Antho32170/ETD2/IMGS/sesame-fonctionnel.png

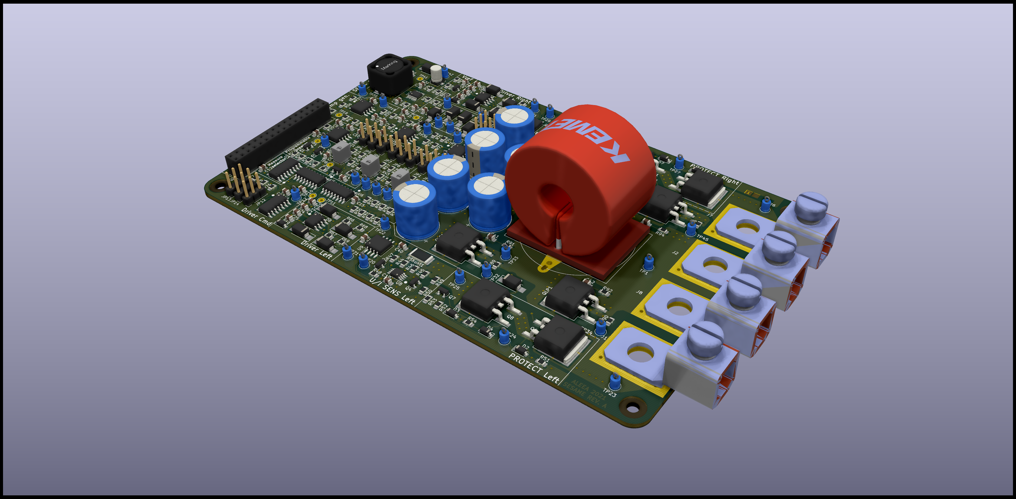
IMGS/sesame-fonctionnel.png
