Antho32170/ETD2/IMGS/sesame-dual_LT6105_equiped_render.png

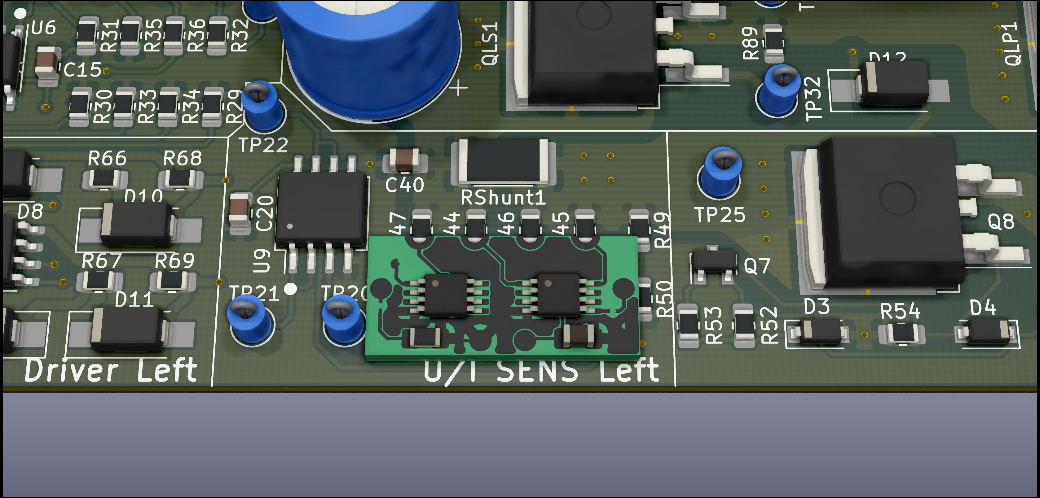
IMGS/sesame-dual_LT6105_equiped_render.png
