Antho32170/ETD2/README.md

# SESAME
Projet ETD18 BALMA

The SESAME project is a DC-DC converter which can be pluged from either side.
