Antho32170/ETD2/IMGS/Current_Res_Breaker.png

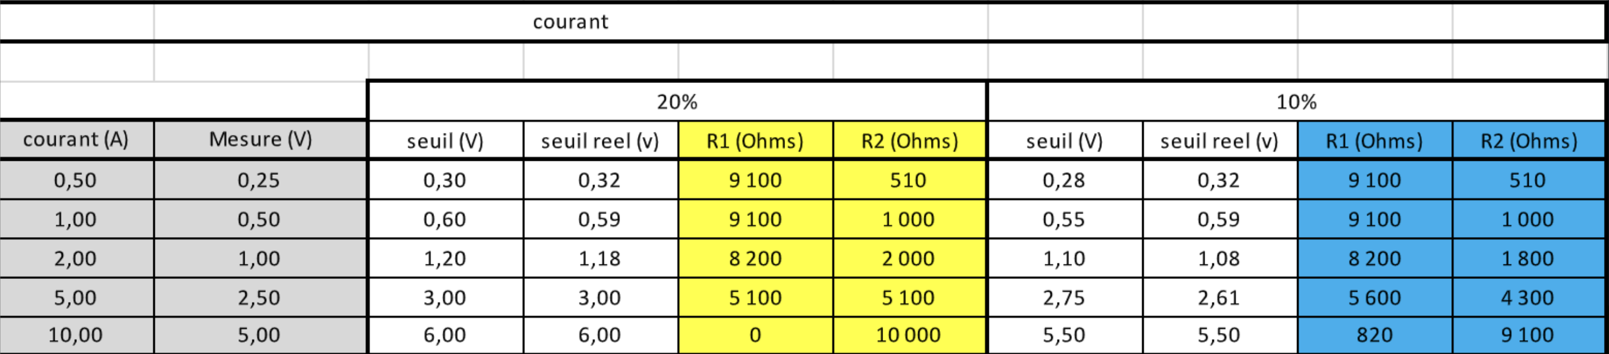
IMGS/Current_Res_Breaker.png
