Antho32170/ETD2/IMGS/lt6105_typ.png

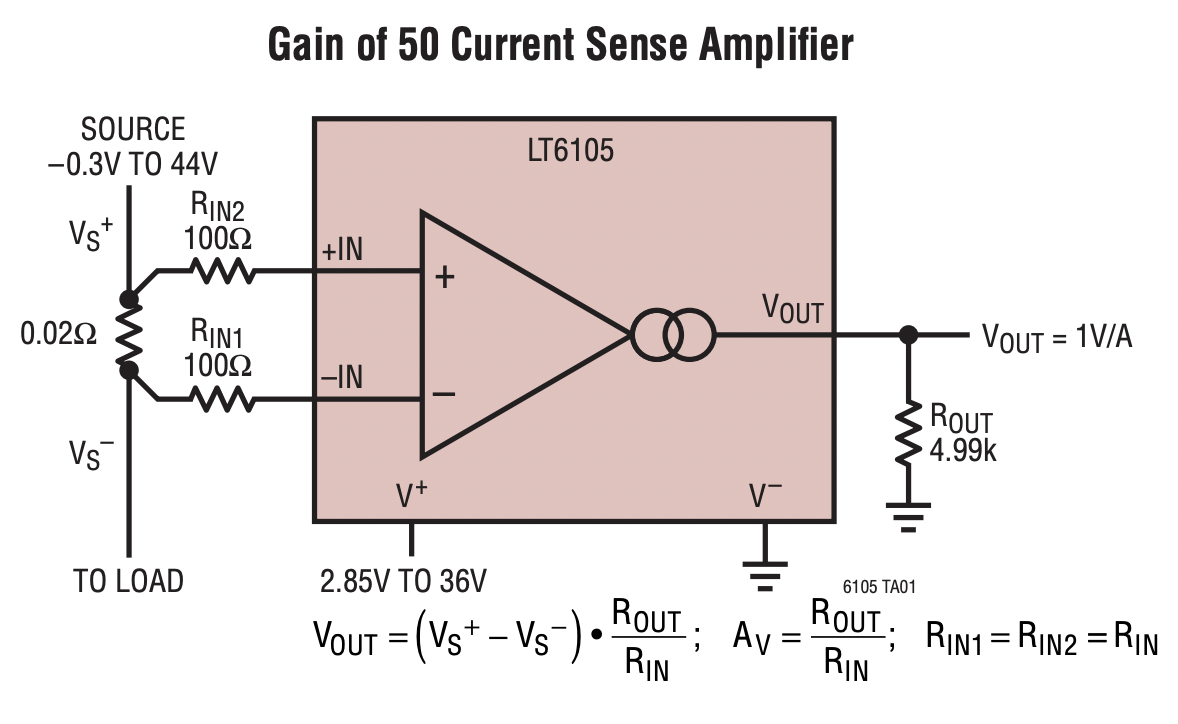
IMGS/lt6105_typ.png
