Antho32170/ETD2/IMGS/sesame-fonctionnel-no-rt.png

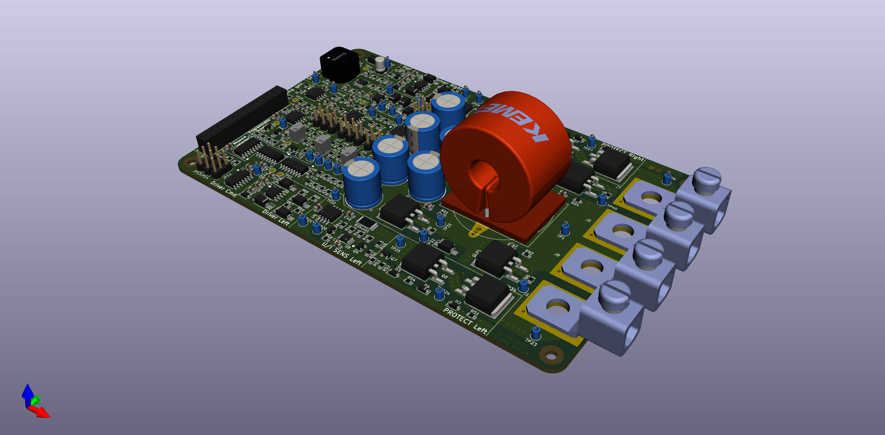
IMGS/sesame-fonctionnel-no-rt.png
