Antho32170/ETD2/IMGS/Voltage_Res_Breaker.png

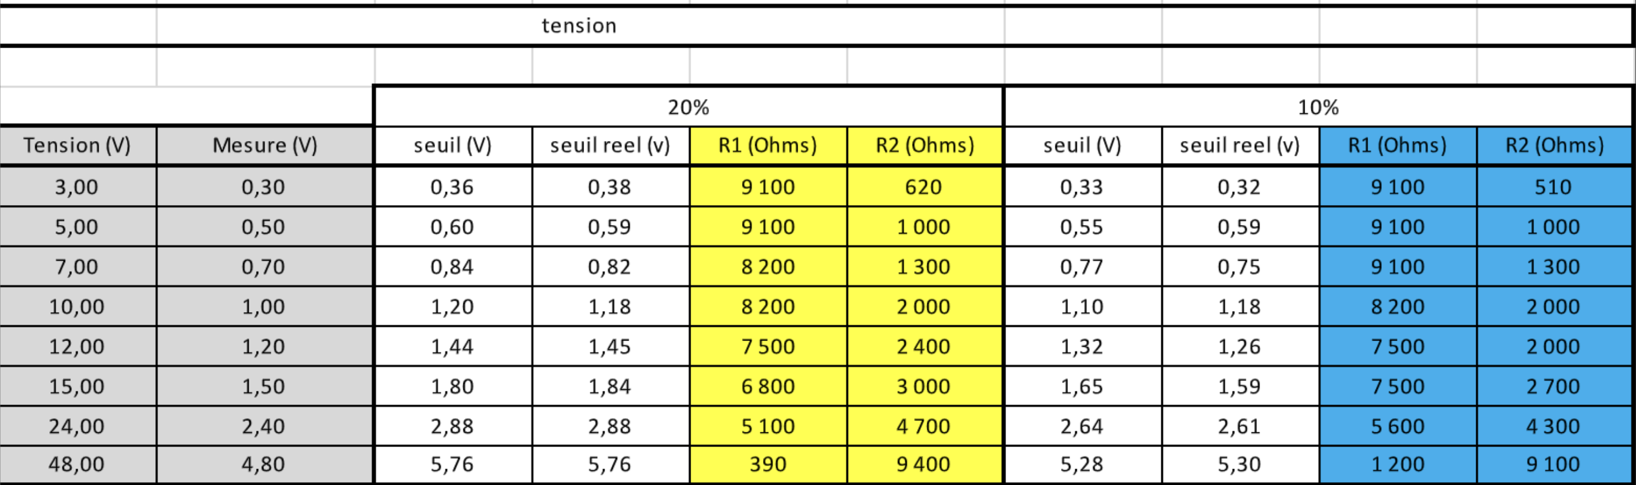
IMGS/Voltage_Res_Breaker.png
