Antho32170/ETD2/KICAD/dual_LT6105/dual_LT6105-rt.png

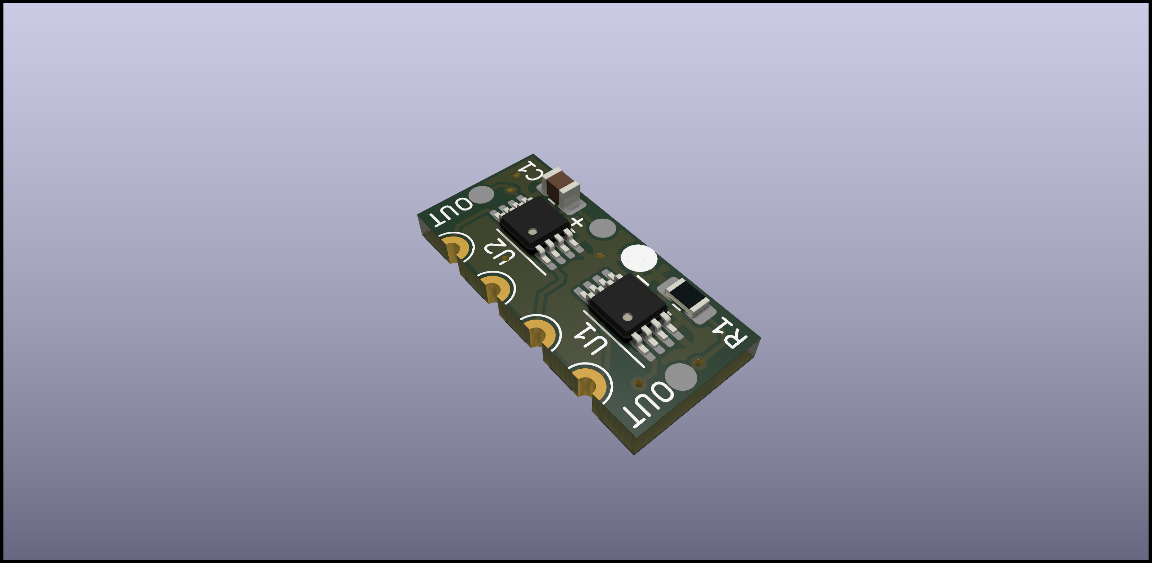
KICAD/dual_LT6105/dual_LT6105-rt.png
