Antho32170/ETD2/montage composants ordre.xlsx

Couleur | Ref | Valeur | Observation
 | R44 R45 R46 R47 R59 R60 R61 R62 R83 | 200Ω
 | mod1 mod2 | x | (suivre la procedure)
 | R68 R69 R87 R88 | 1Ω
 | R66 R67 R85 R86 | 4.7Ω
 | R9 | 390Ω
 | R43 | 680Ω
 | R71 | 4.7kΩ
 | R39 | 6.8kΩ
 | R7 R26 R29 R31 R32 R35 R36 R37 R40 R50 R65 R76 R77 R78 R84 R97 R98 | 10kΩ | En bobine
 | R38 | 11kΩ
Couleur | Ref | Valeur | Observation
 | R41 | 13kΩ
 | R28 | 14kΩ
 | R42 | 18kΩ
 | R8 mod1_R1 mod2_R1 | 20kΩ
 | R3 R5 R22 R23 R24 R25 R27 | 47kΩ
 | R49 R64 | 91kΩ
 | R14 R15 R16 R17 R18 R19 R20 R21 R52 R53 R56 R57 R70 R72 R73 R74 R75 | 100kΩ
 | R51 R55 | 330kΩ
 | R54 R58 | 1MΩ
 | RShunt1 RShunt2 | 5mΩ
Couleur | Ref | Valeur | Observation
 | C18 | 2.2nF
 | C8 C10 C11 | 10nF
 | C4 | 22nF
 | C1 C6 C12 C13 C15 C16 C17 C20 C22 C23 C24 C26 C27 C33 C34 mod1_C1 mod2_C1 | 100nF
 | C5 | 220nF
 | C3 C7 C9 C14 | 470nF
 | C50 C51 | 1µF
 | D1 | BZX384B5V1 | 5V1
 | D2 D4 D5 D7 D19 D22 | MMSZ5245 | 15V
 | D3 D6 | MMSZ51T1G | 51V
Couleur | Ref | Valeur | Observation
 | D10 D11 D17 D18 D20 D23 | SK16
 | Q1 Q2 Q3 | BC847 | NPN
 | Q7 Q10 | BC857 | PNP
 | U16 | TL431DBZ
 | U12 U17 | UCC27284-Q1
 | U13 | TS3702
 | U1 U7 U9 U11 | OPA2172
 | U2 | LM2903
 | U4 | CD4011
 | U3 U5 U6 | CD4053
 | mod1_U1 mod1_U2 mod2_U1 mod2_U2 | LT6105
Couleur | Ref | Valeur | Observation
 | QLS1 QLP1 QRP1 QRS1 | IRF3710SPBF | CHANNEL N
 | Q6 Q8 Q9 Q11 | TJ60S04 | CHANNEL P
 | C32 | 10µF | 60V
 | RV1 RV2 RV3 | 10KΩ
 | JP1 JP2 JP3 JP4 JP5 JP6 JP7 JP8 JP9 | 1X2
 | JP10 JP11 JP12 JP13 JP14 | 1X3
 | J9 | 2X16
 | C36 C47 | 470µF
 | L2 | GROSSE BOB
 | TP1 TP2 TP4 TP7 TP9 TP12 TP13 TP14 TP15 TP16 TP17 TP19 TP21 TP22 TP23 TP24 TP25 TP26 TP27 TP28 TP30 TP31 TP32 TP33 TP34 TP36 TP37 TP38 TP42 TP43 TP44 TP45 TP46 TP47 TP48 TP49 | Test point
