Antho32170/ETD2/FREECAD/dual_LT61051.FCStd

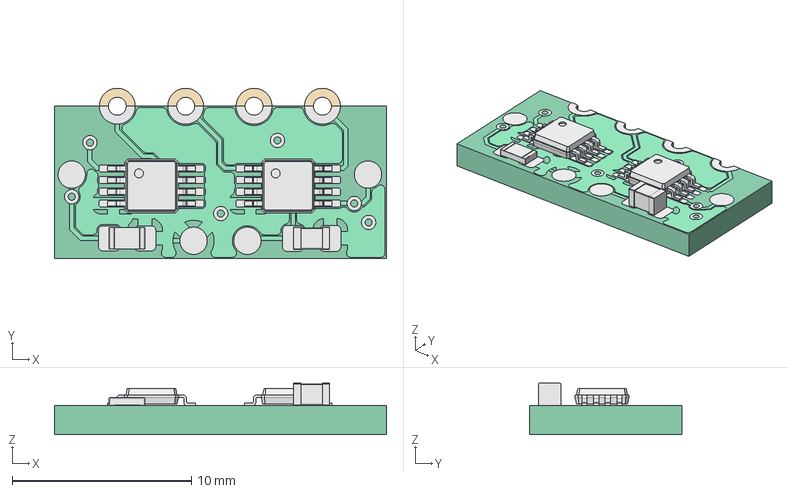
[picture p13: CAD file, 2021-11-26]
FREECAD/dual_LT61051.FCStd
18.5 x 9.50 x 2.87 mm
Pcb_2a2f
topPads_2a2f
topTracks_2a2f
topZones_2a2f
botPads_2a2f
botTracks_2a2f
botZones_2a2f
U1_MSOP_8_3x3mm_P065mm_f12392cb5f74 x 2
C1_C_0805_2012Metric_c8931768d43d
R1_R_0805_2012Metric_d0d7686d96ad
