Antho32170/ETD2/KICAD/dual_LT6105/dual_LT6105.step

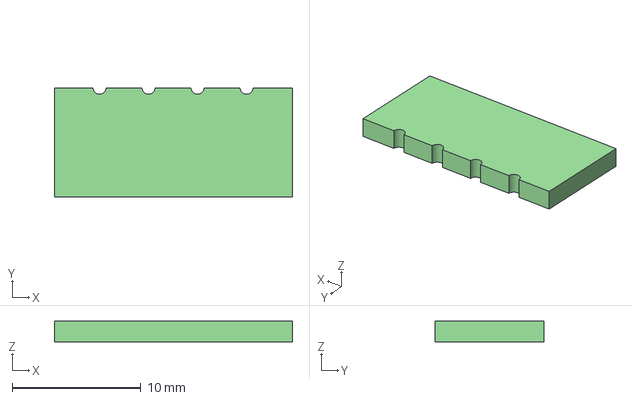
[picture p14: CAD file, 2021-11-26]
KICAD/dual_LT6105/dual_LT6105.step
18.5 x 8.50 x 1.60 mm
