Antho32170/ETD2/KICAD/STEP/SOIC-16.STEP

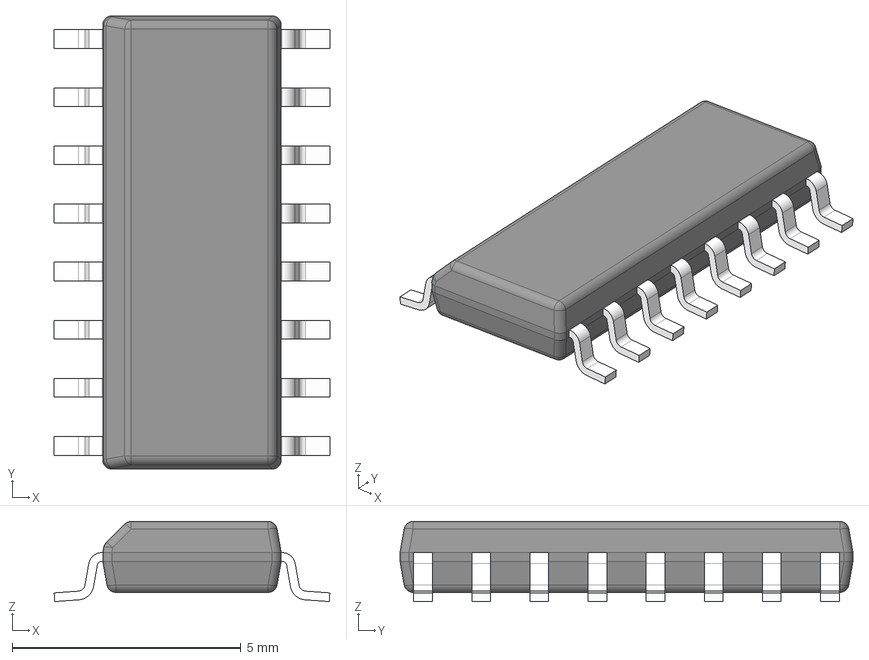
[picture p15: CAD file, 2021-08-27]
KICAD/STEP/SOIC-16.STEP
6.03 x 9.90 x 1.75 mm
BODY-SO
LEAD-SO x 16
PIN1-ID
