Antho32170/ETD2/KICAD/STEP/3214W.stp

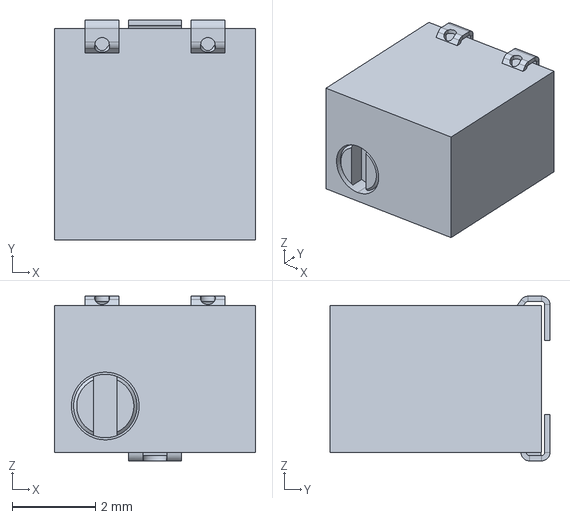
[picture p16: CAD file, 2021-08-26]
KICAD/STEP/3214W.stp
4.83 x 5.28 x 3.96 mm
