Antho32170/ETD2/KICAD/STEP/SN14P-300J.step

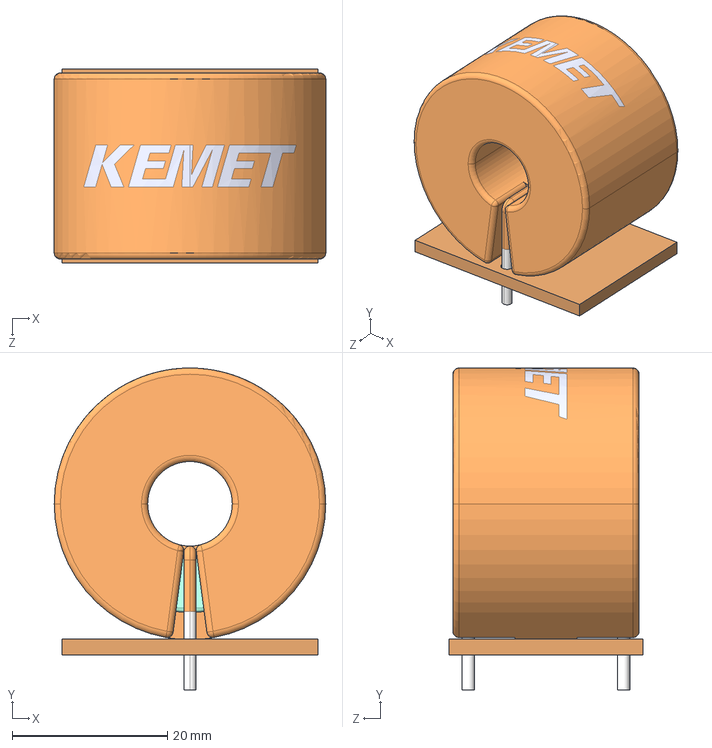
[picture p17: CAD file, 2021-08-25]
KICAD/STEP/SN14P-300J.step
35.0 x 41.5 x 25.0 mm
