Antho32170/ETD2/KICAD/STEP/keystone-PN6095.STEP

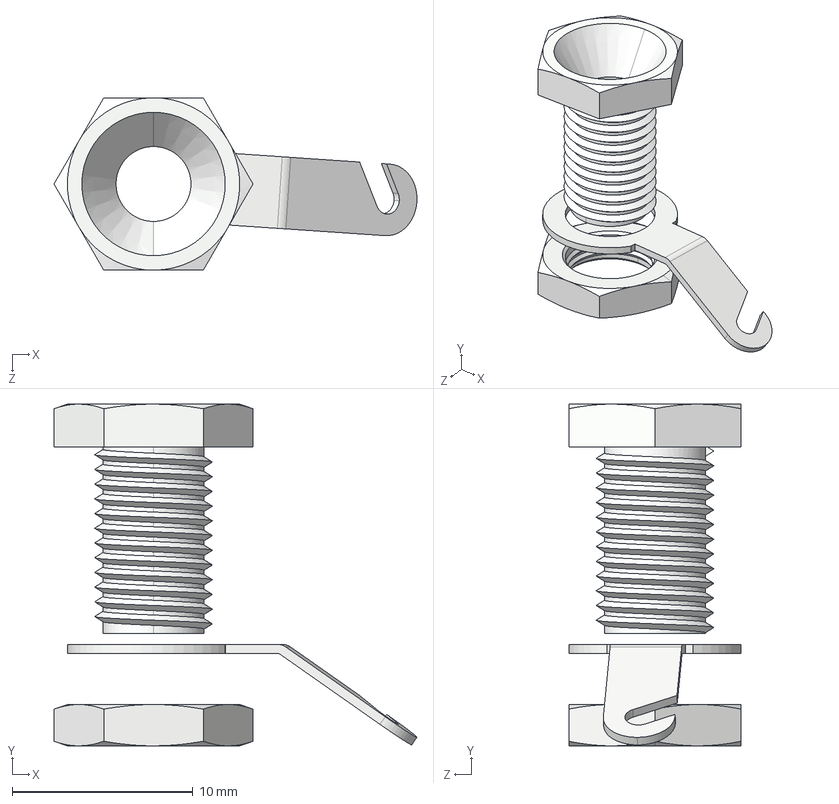
[picture p18: CAD file, 2021-08-22]
KICAD/STEP/keystone-PN6095.STEP
20.1 x 18.9 x 9.53 mm
