Antho32170/ETD2/KICAD/STEP/CXS70-14-C.STEP

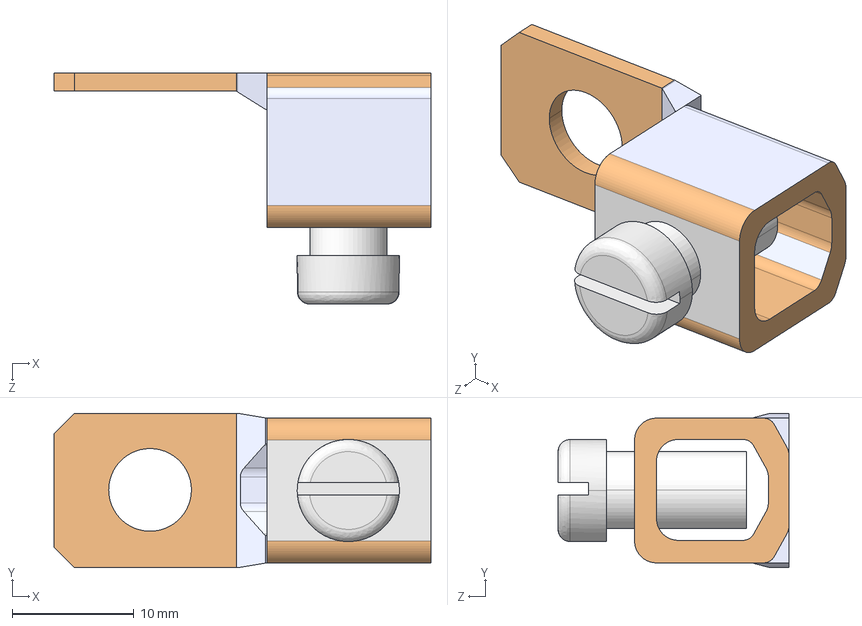
[picture p19: CAD file, 2021-08-22]
KICAD/STEP/CXS70-14-C.STEP
31.0 x 12.7 x 19.0 mm
