Antho32170/ETD2/KICAD/STEP/744873001_Download_STP_WE-DD-1280_rev1.stp

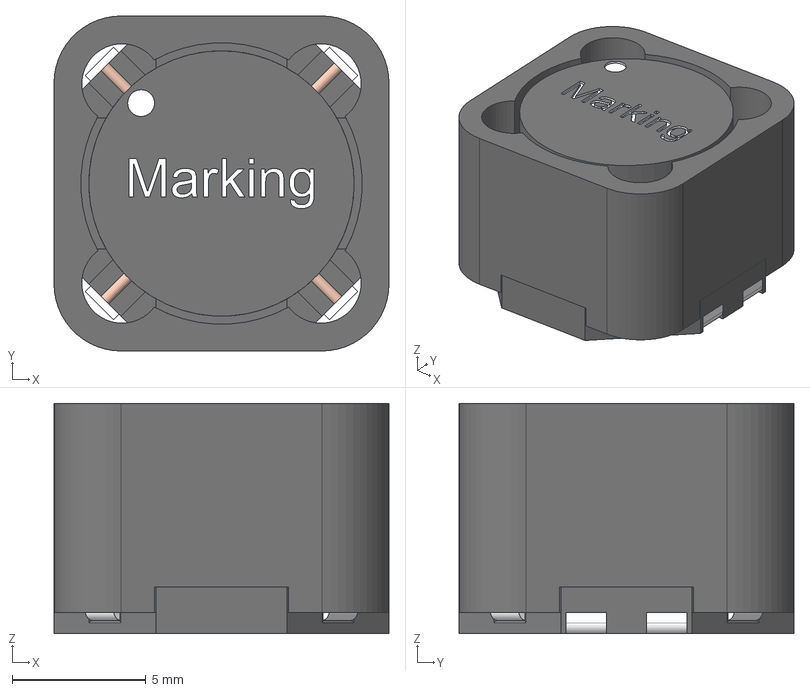
[picture p20: CAD file, 2021-08-25]
KICAD/STEP/744873001_Download_STP_WE-DD-1280_rev1.stp
12.5 x 12.5 x 8.60 mm
Kern x 4
Deckel
Pin x 2
Pin_2 x 2
