Antho32170/ETD2/(list of files, cad)

Other CAD files:
KICAD/STEP/dual_LT6105.step
