Antho32170/ETD2/DOCS/sesame-fonctionnel-1.0.pdf

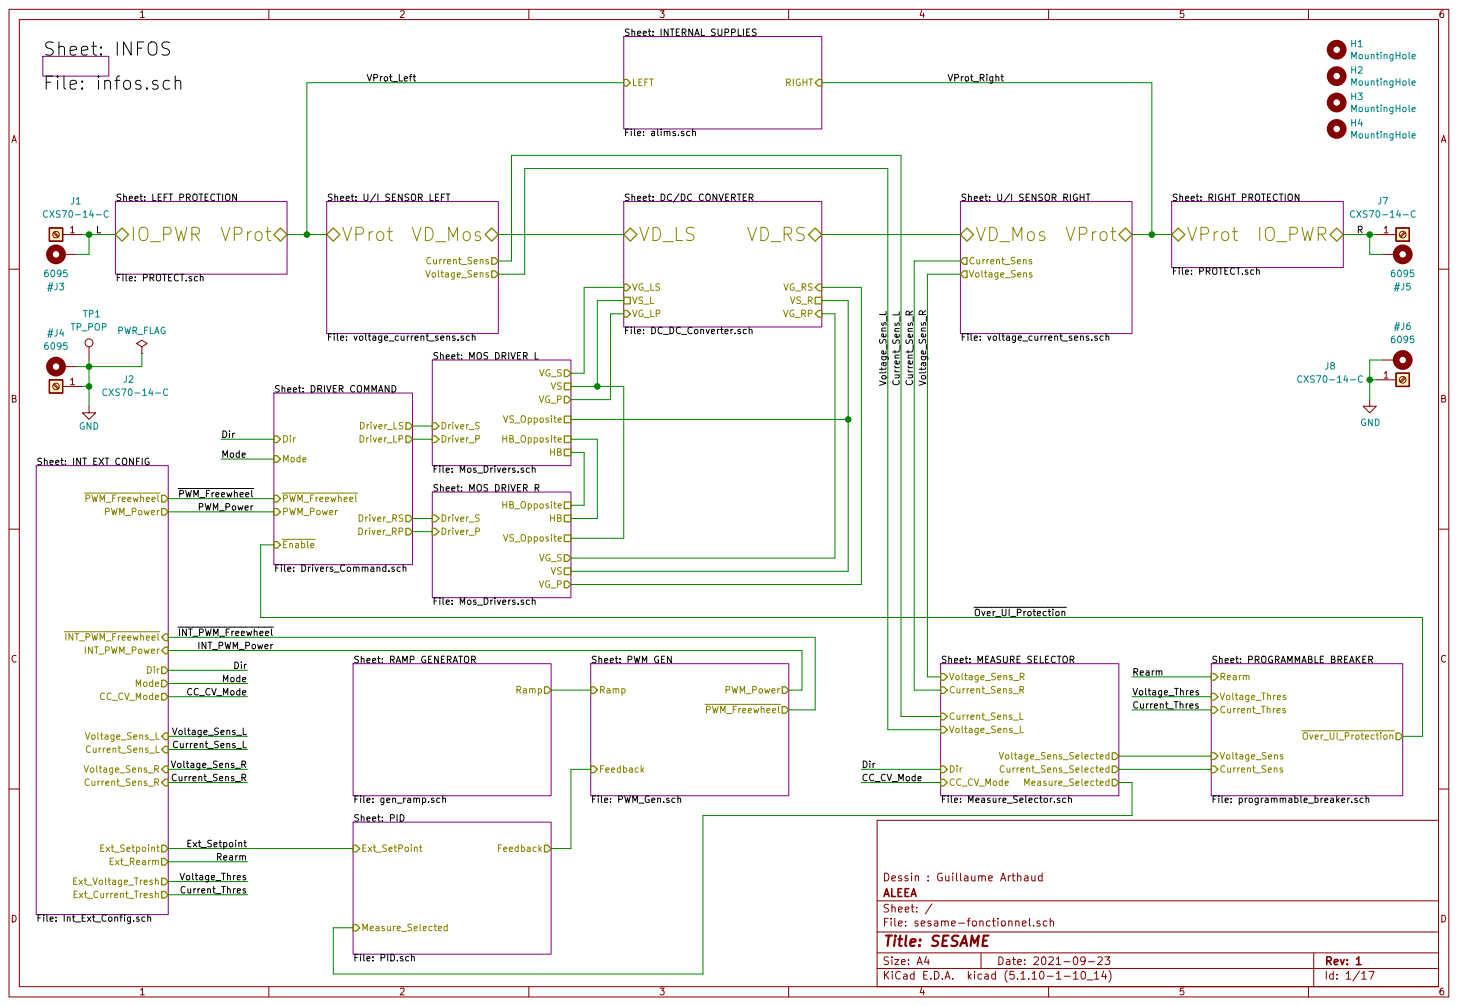
[picture p21: page 1]

VD_Mos VProt Current_Sens Voltage_Sens Sheet: DC/DC CONVERTER

File: PROTECT.sch VProt IO_PWR

Dessin : Guillaume Arthaud Sheet: INT EXT CONFIG

File: sesame-fonctionnel.sch Sheet: / ALEEA

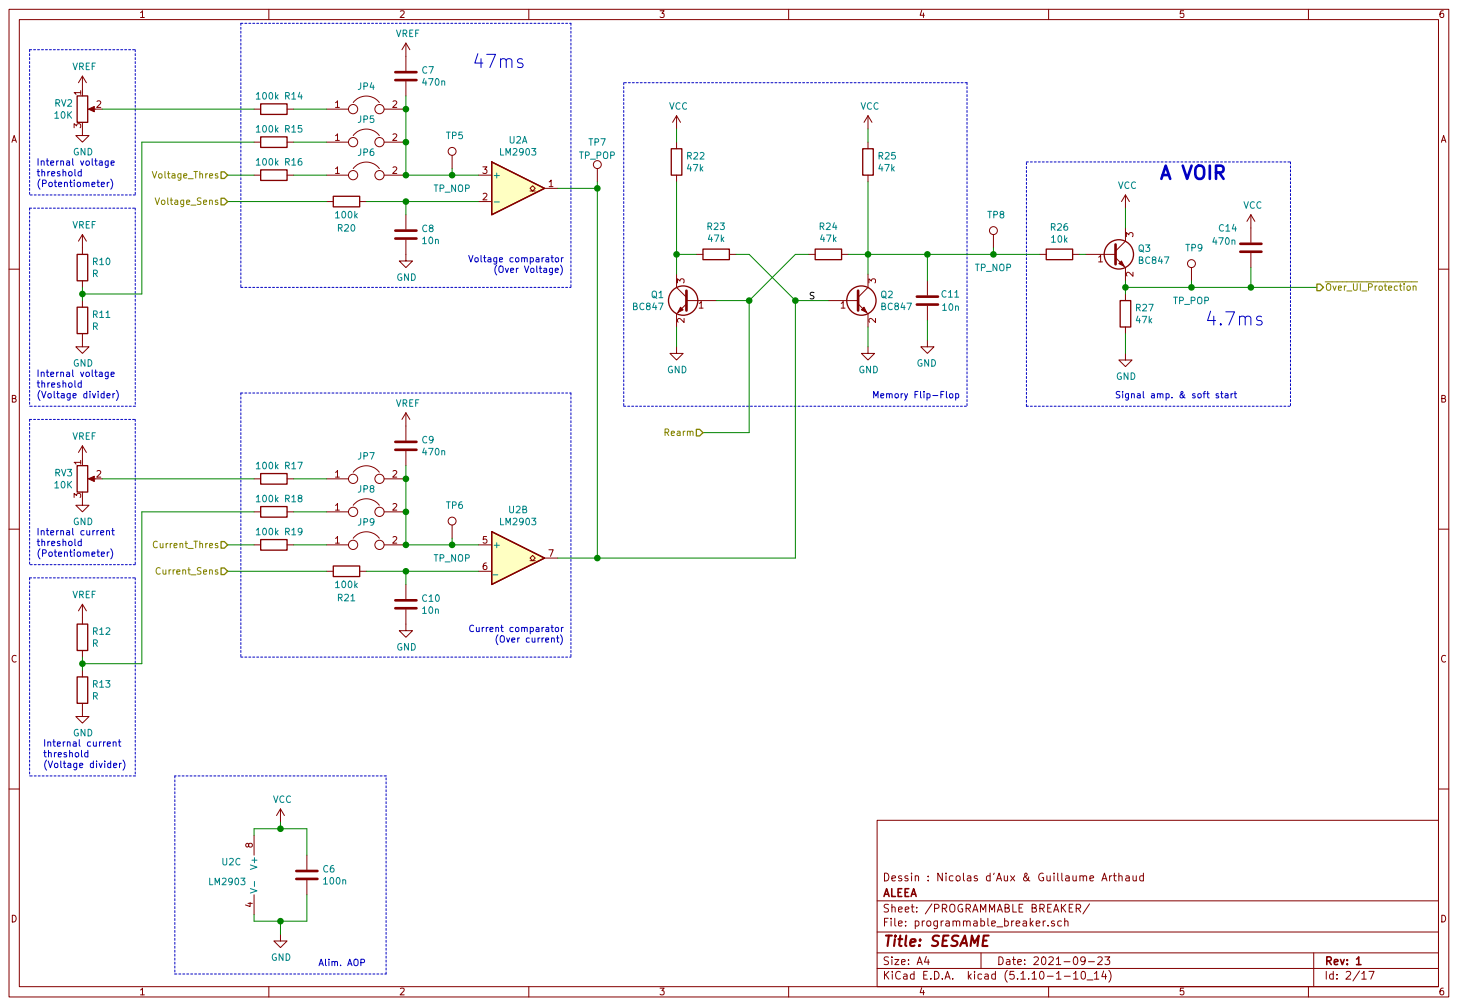
[picture p22: page 2]

A VOIR

10n GND | - 2 + 1 Voltage comparator (Over Voltage)

Signal amp. & soft start

Dessin : Nicolas d'Aux & Guillaume Arthaud
File: programmable_breaker.sch Sheet: /PROGRAMMABLE BREAKER/ ALEEA

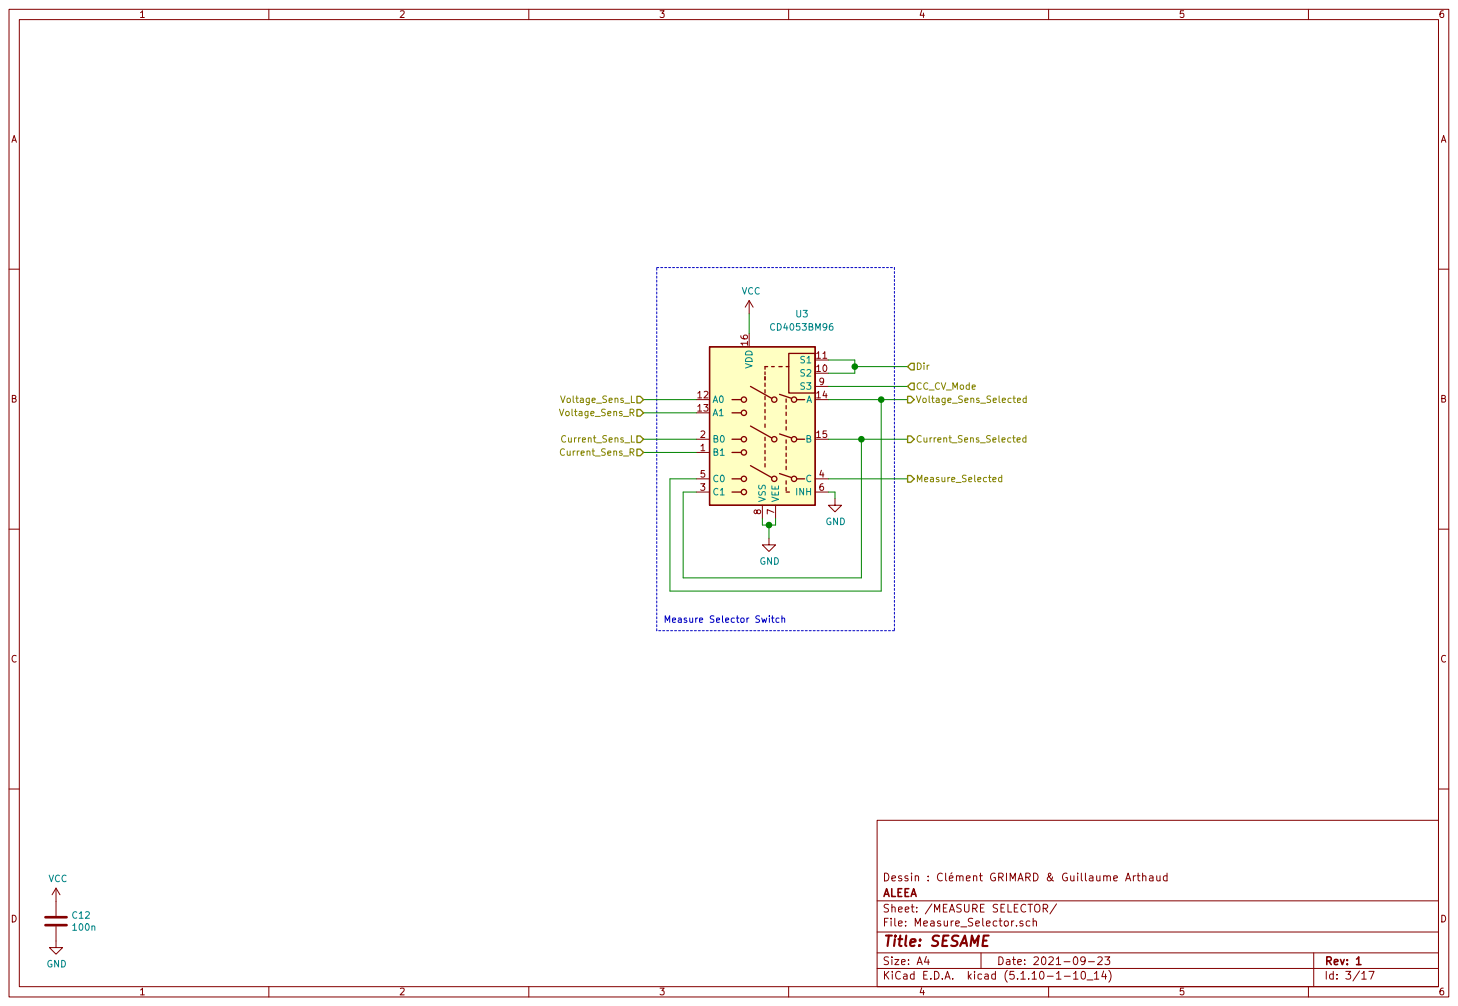
[picture p23: page 3]

Dessin : Clément GRIMARD & Guillaume Arthaud
File: Measure_Selector.sch Sheet: /MEASURE SELECTOR/ ALEEA

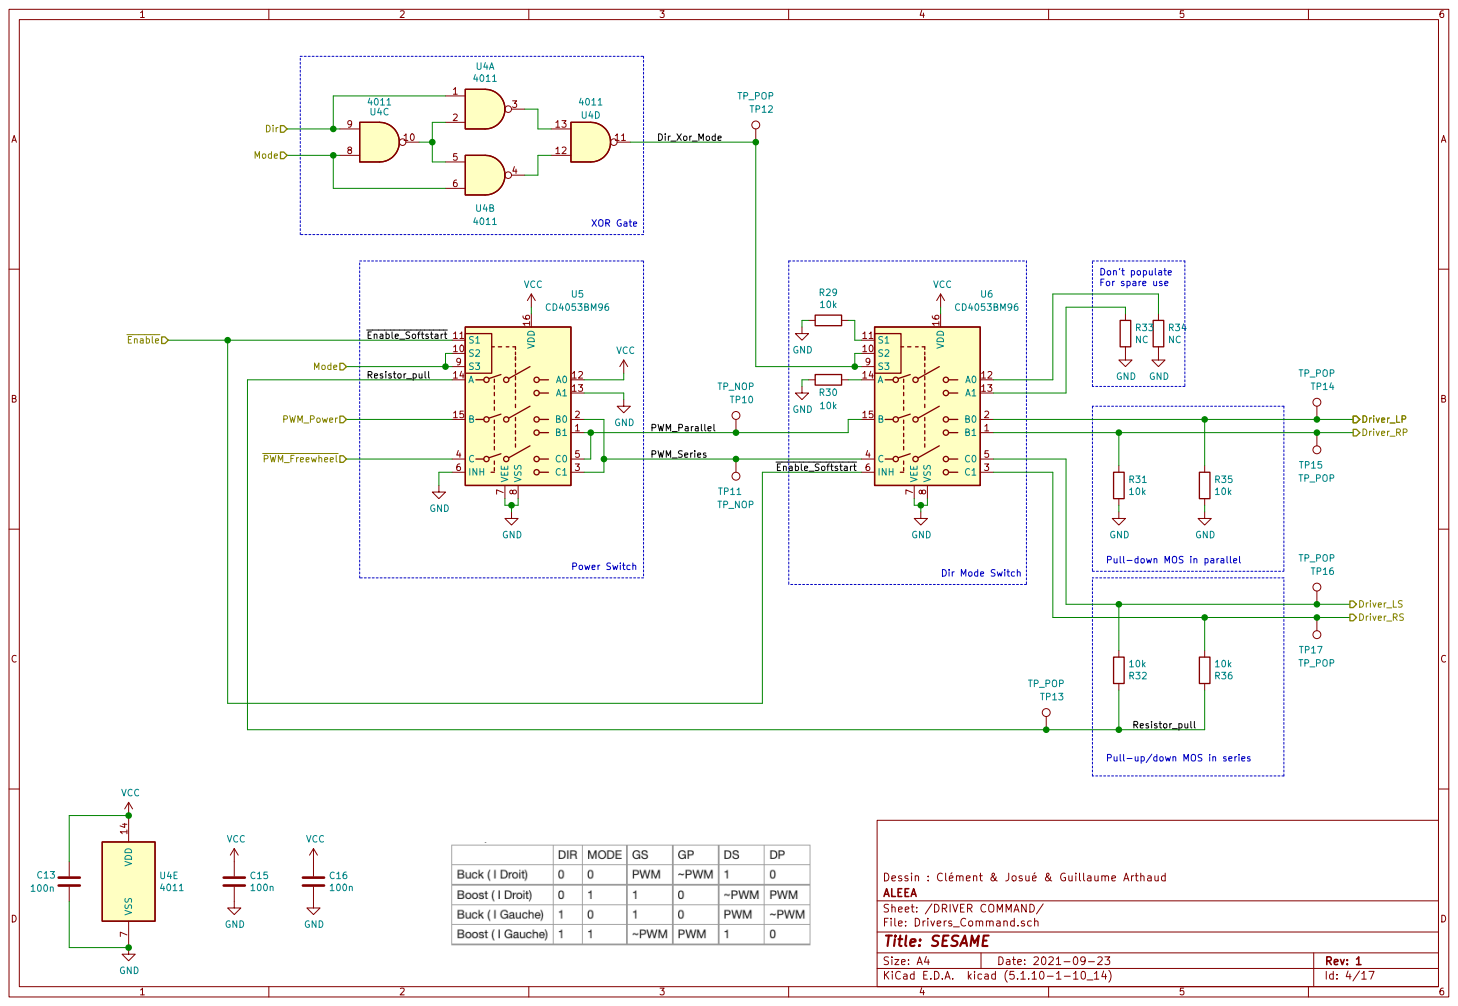
[picture p24: page 4]

Pull-up/down MOS in series

Dessin : Clément & Josué & Guillaume Arthaud
File: Drivers_Command.sch Sheet: /DRIVER COMMAND/ ALEEA

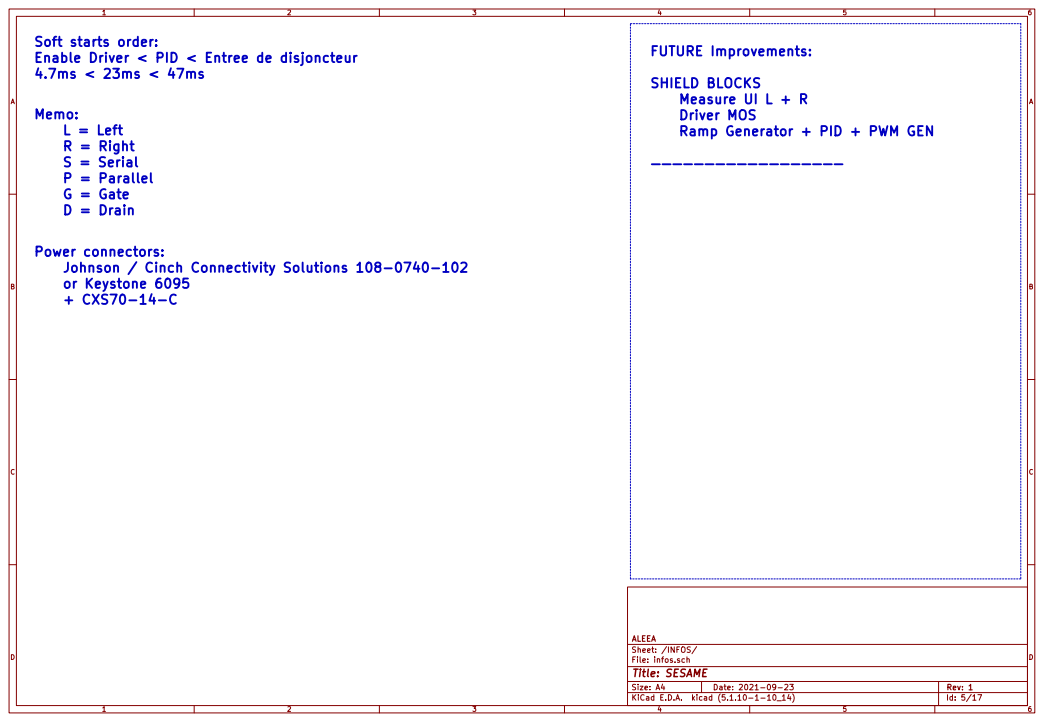
[picture p25: page 5]

File: infos.sch Sheet: /INFOS/ ALEEA Soft starts order:
Enable Driver < PID < Entree de disjoncteur

SHIELD BLOCKS
Measure UI L + R
Driver MOS
Ramp Generator + PID + PWM GEN

Power connectors:
Johnson / Cinch Connectivity Solutions 108-0740-102
or Keystone 6095
+ CXS70-14-C

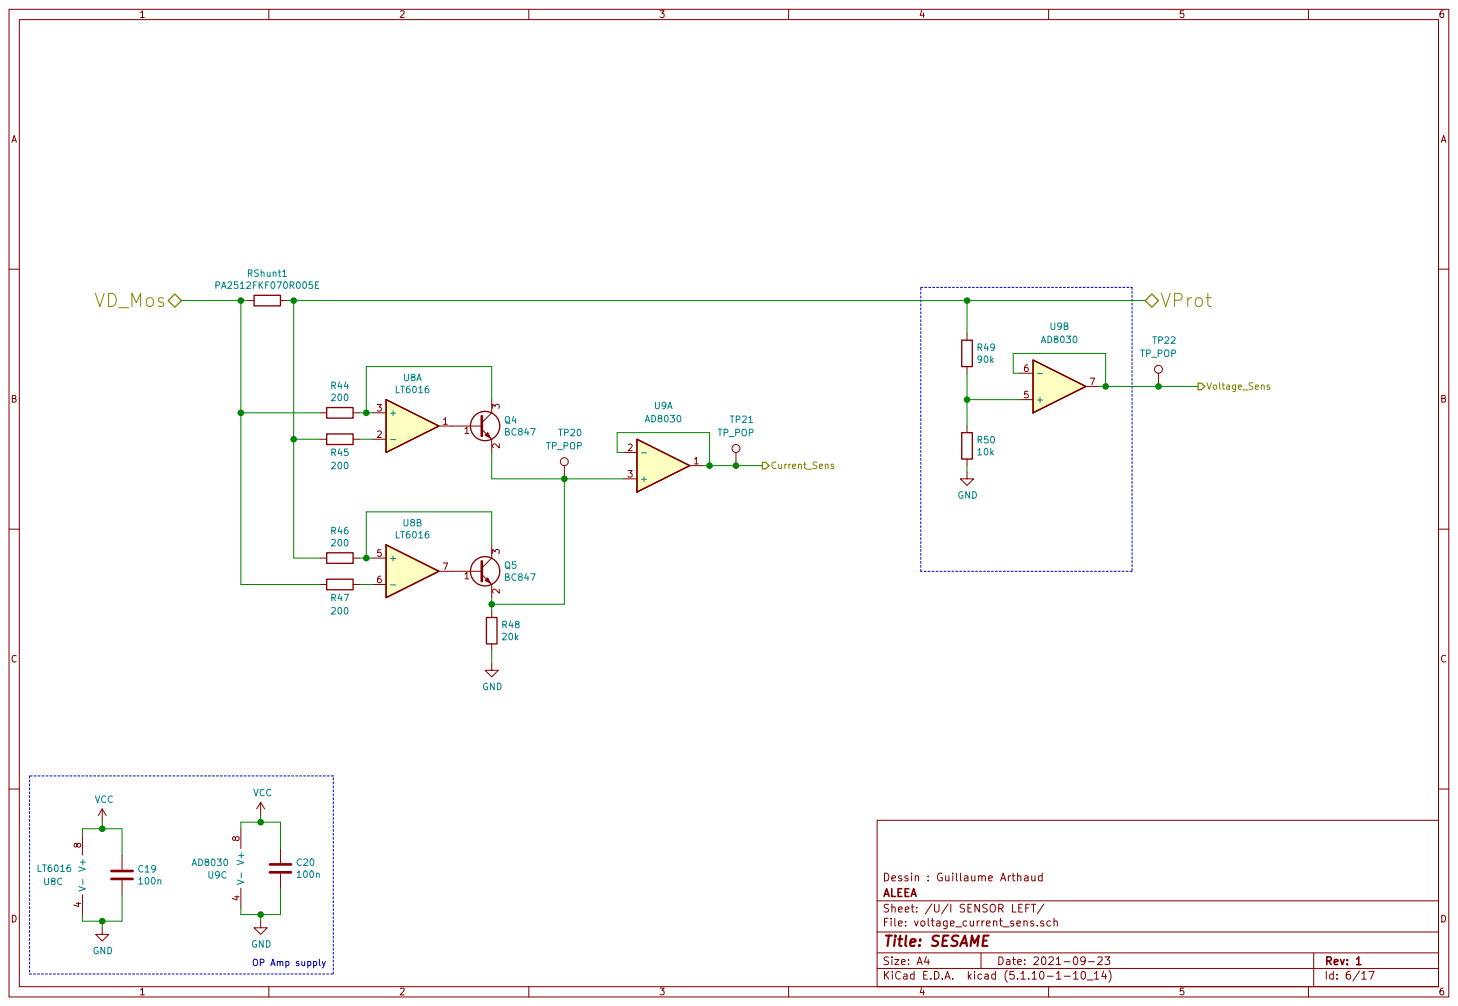
[picture p26: page 6]

Dessin : Guillaume Arthaud
File: voltage_current_sens.sch Sheet: /U/I SENSOR LEFT/ ALEEA

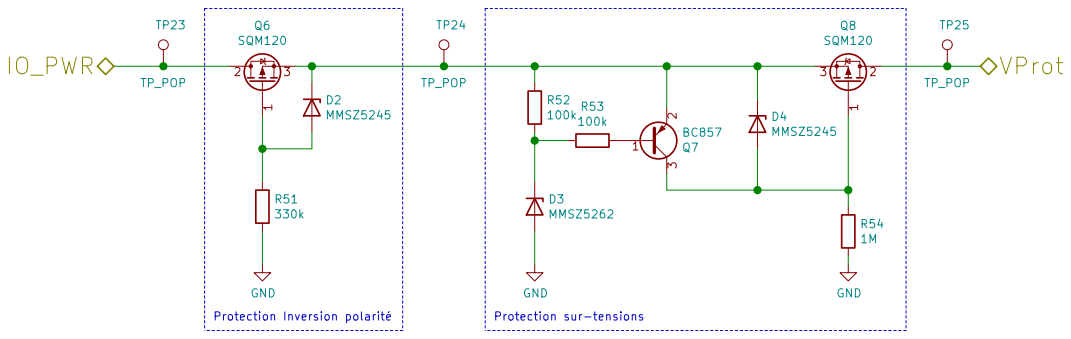
[picture p27: page 7]

File: PROTECT.sch Sheet: /LEFT PROTECTION/ ALEEA

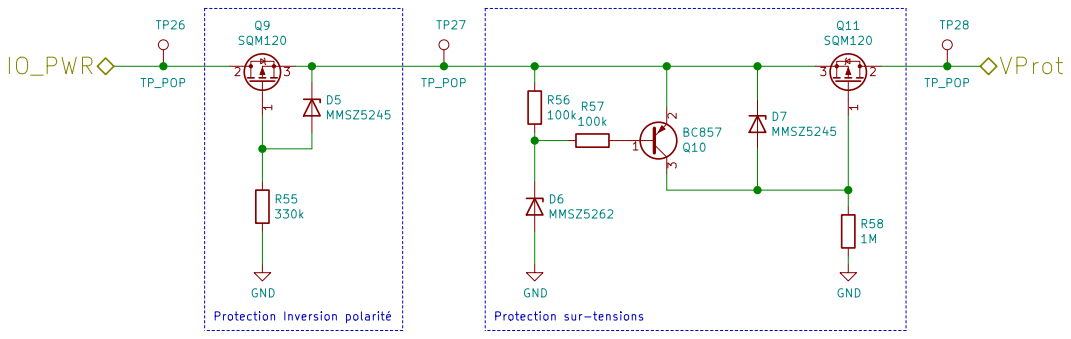
[picture p28: page 8]

File: PROTECT.sch Sheet: /RIGHT PROTECTION/ ALEEA

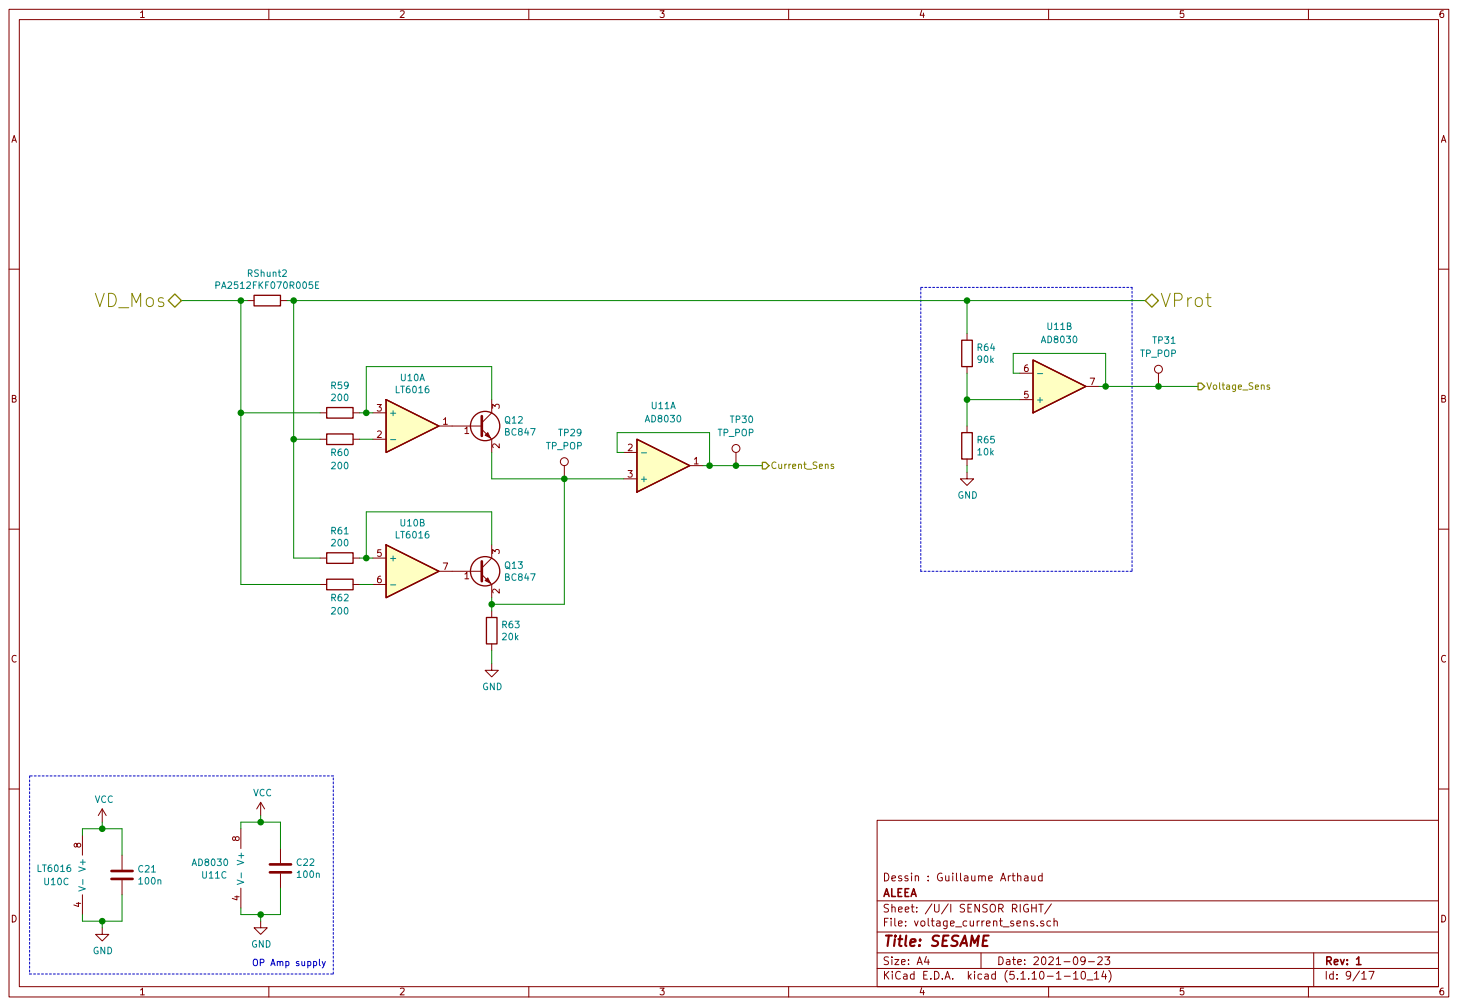
[picture p29: page 9]

Dessin : Guillaume Arthaud
File: voltage_current_sens.sch Sheet: /U/I SENSOR RIGHT/ ALEEA

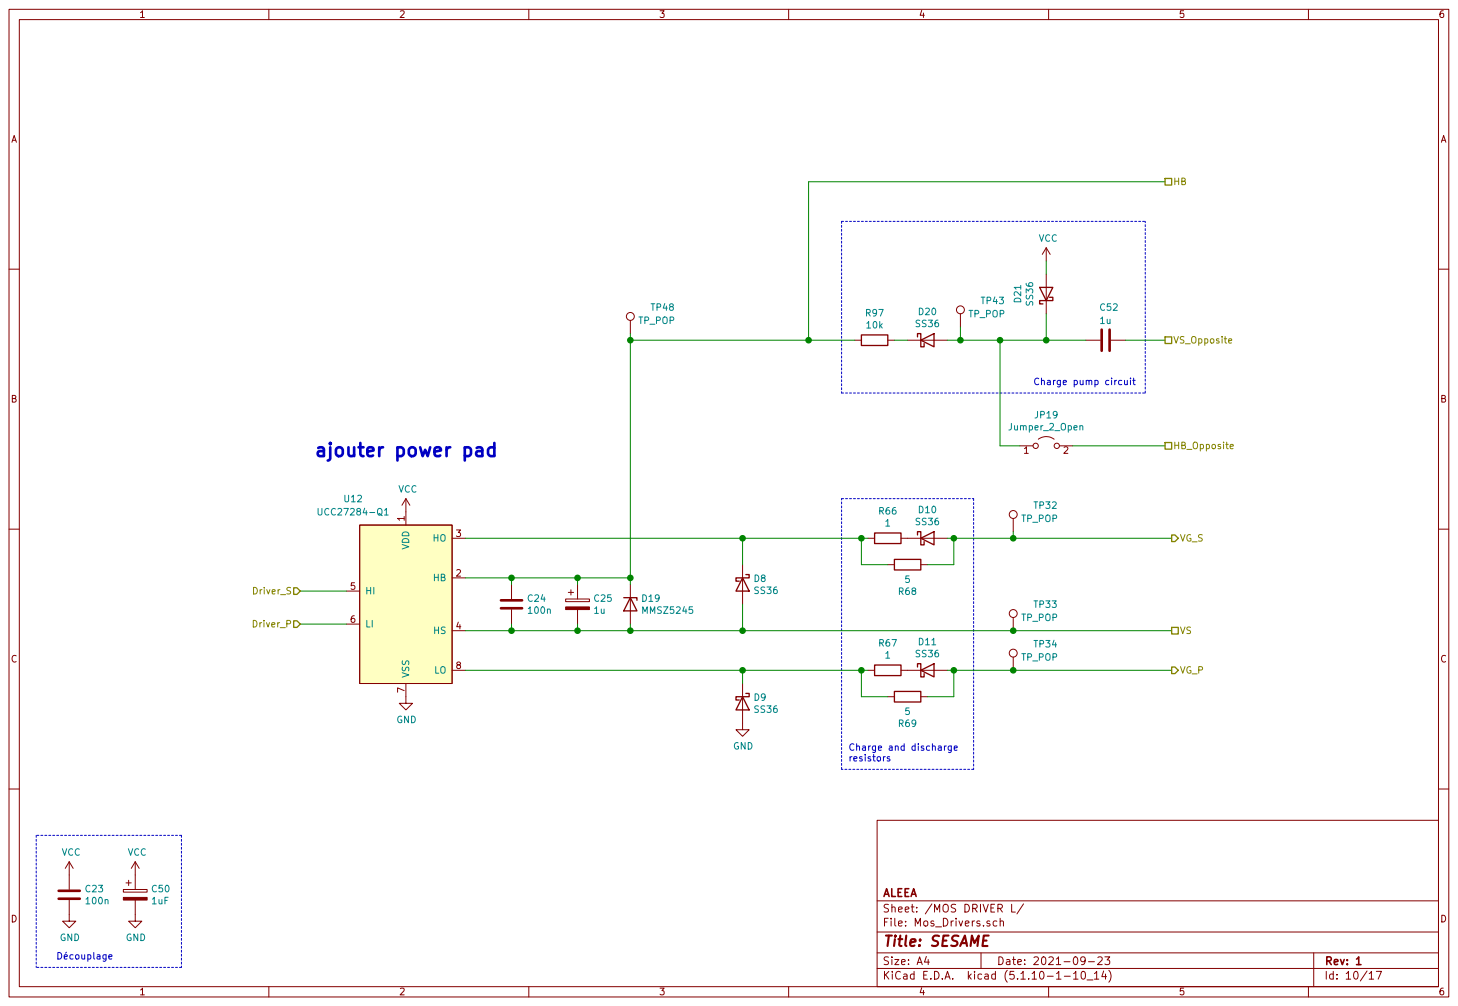
[picture p30: page 10]

resistors ajouter power pad

File: Mos_Drivers.sch Sheet: /MOS DRIVER L/ ALEEA

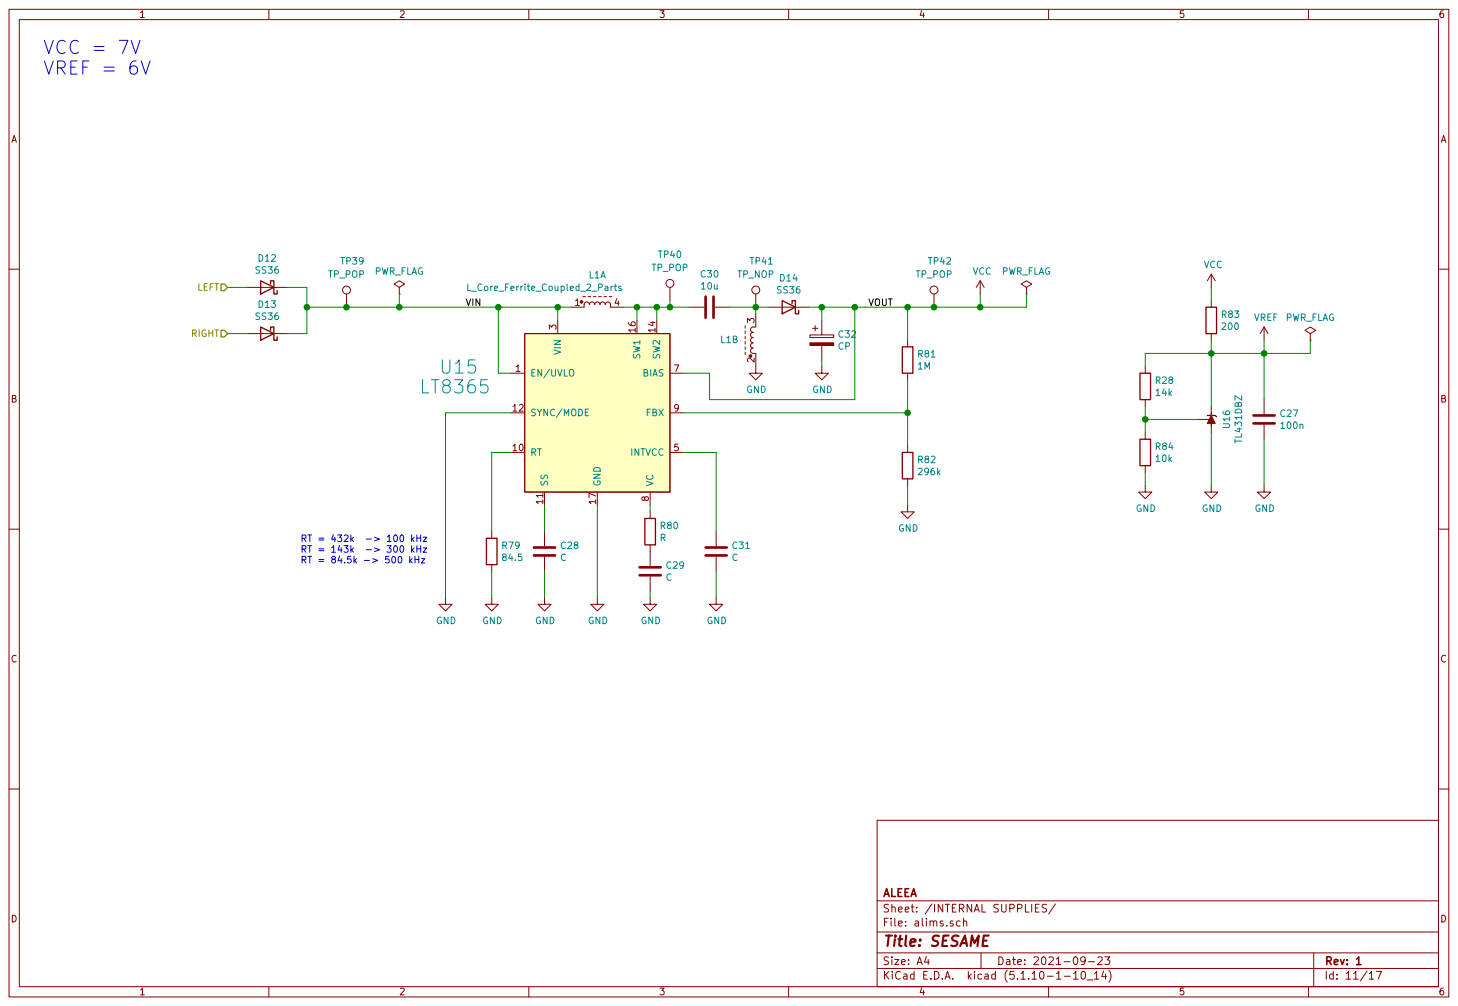
[picture p31: page 11]

RT = 432k -> 100 kHz RT = 143k -> 300 kHz RT = 84.5k -> 500 kHz

File: alims.sch Sheet: /INTERNAL SUPPLIES/ ALEEA

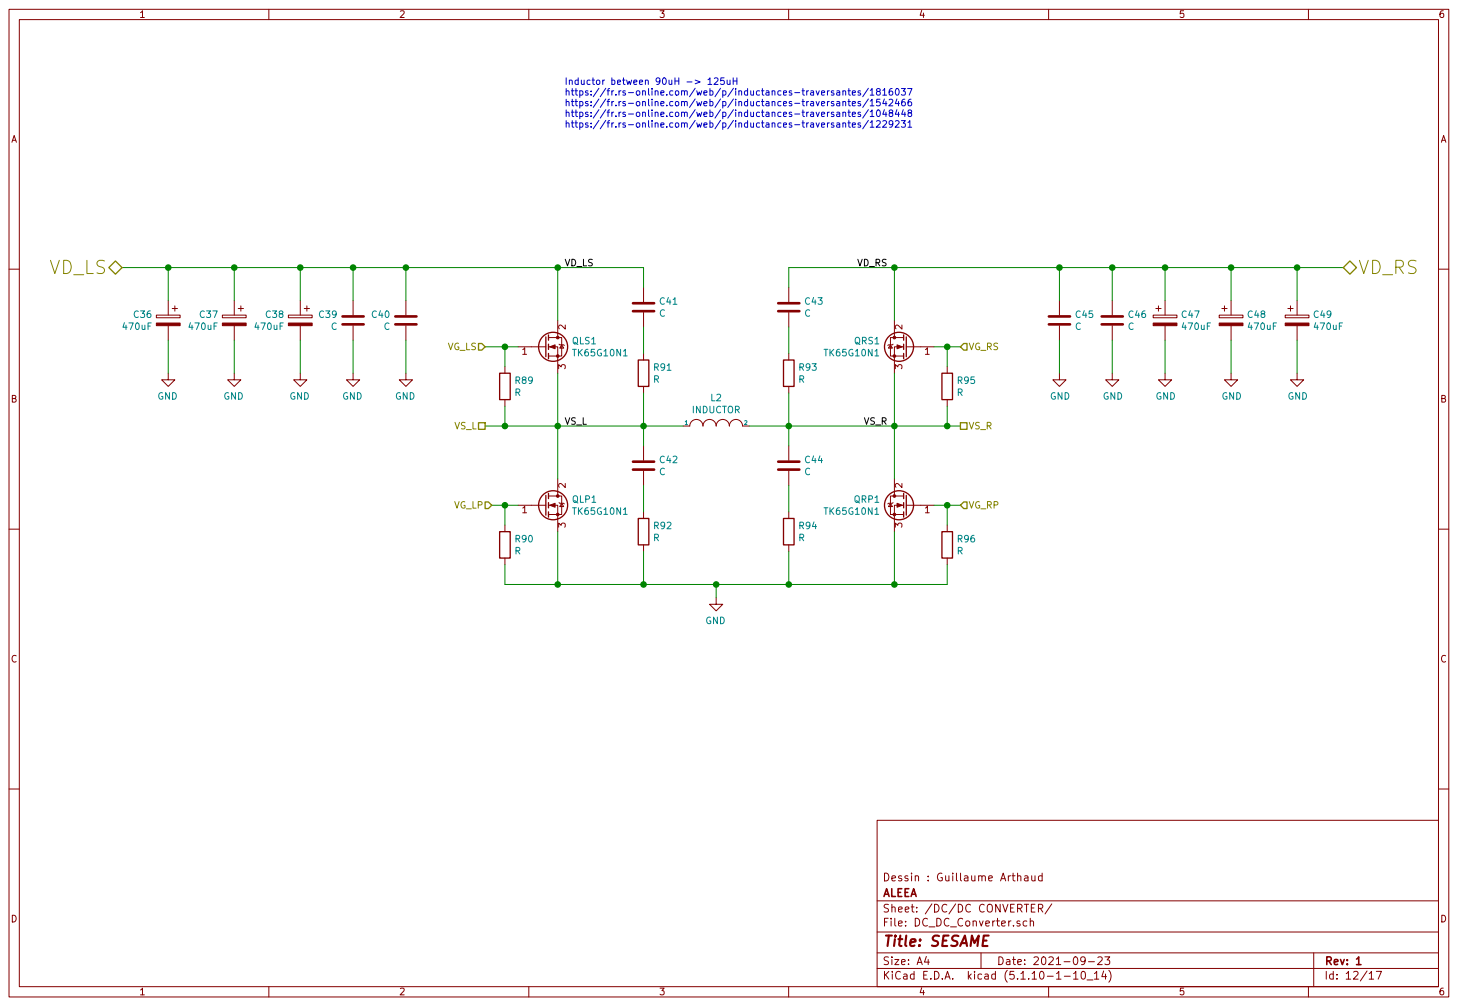
[picture p32: page 12]

Inductor between 90uH -> 125uH
https://fr.rs-online.com/web/p/inductances-traversantes/1816037
https://fr.rs-online.com/web/p/inductances-traversantes/1542466
https://fr.rs-online.com/web/p/inductances-traversantes/1048448
https://fr.rs-online.com/web/p/inductances-traversantes/1229231

Dessin : Guillaume Arthaud R94 R GND

File: DC_DC_Converter.sch Sheet: /DC/DC CONVERTER/ ALEEA

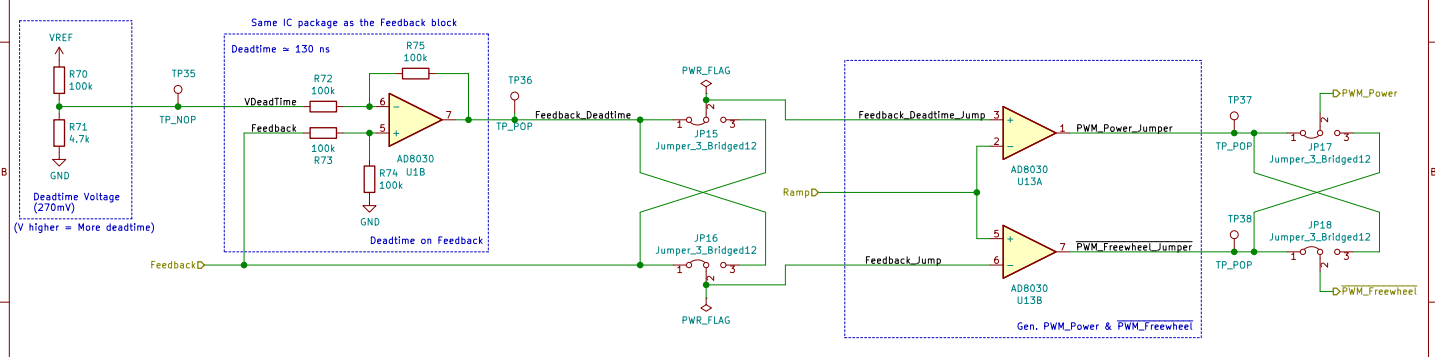
[picture p33: page 13]

Feedback_Deadtime_Jump Deadtime on Feedback Deadtime 130 ns OP Amp supply

Dessin : Kevin & Sarah & Guillaume Arthaud VCC

File: PWM_Gen.sch Sheet: /PWM GEN/ ALEEA

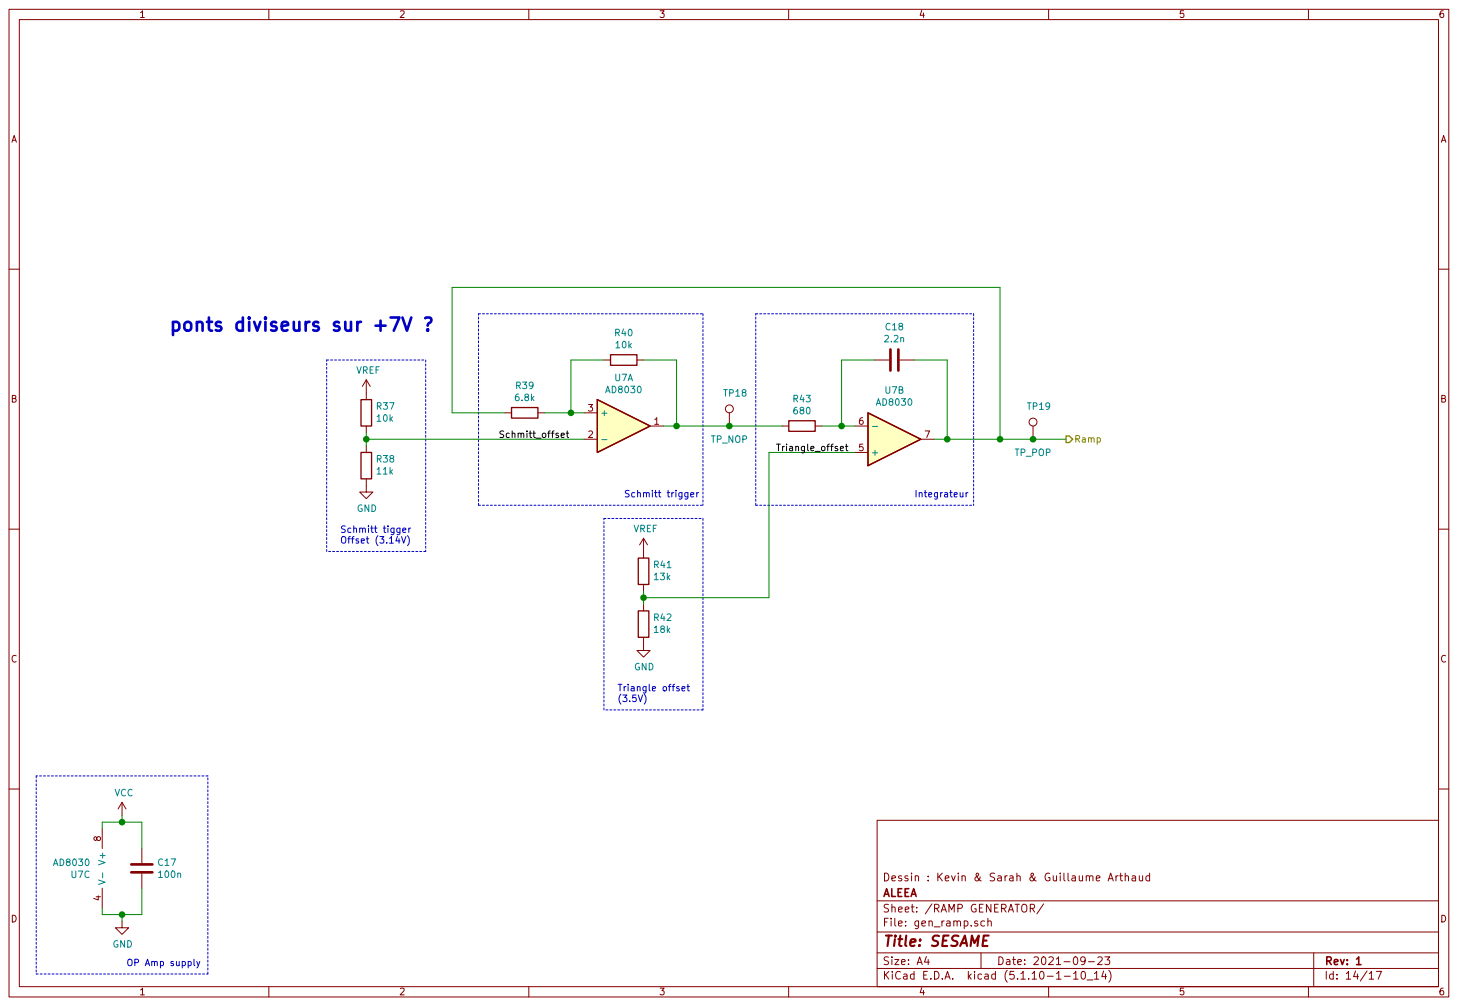
[picture p34: page 14]

Dessin : Kevin & Sarah & Guillaume Arthaud
File: gen_ramp.sch Sheet: /RAMP GENERATOR/ ALEEA

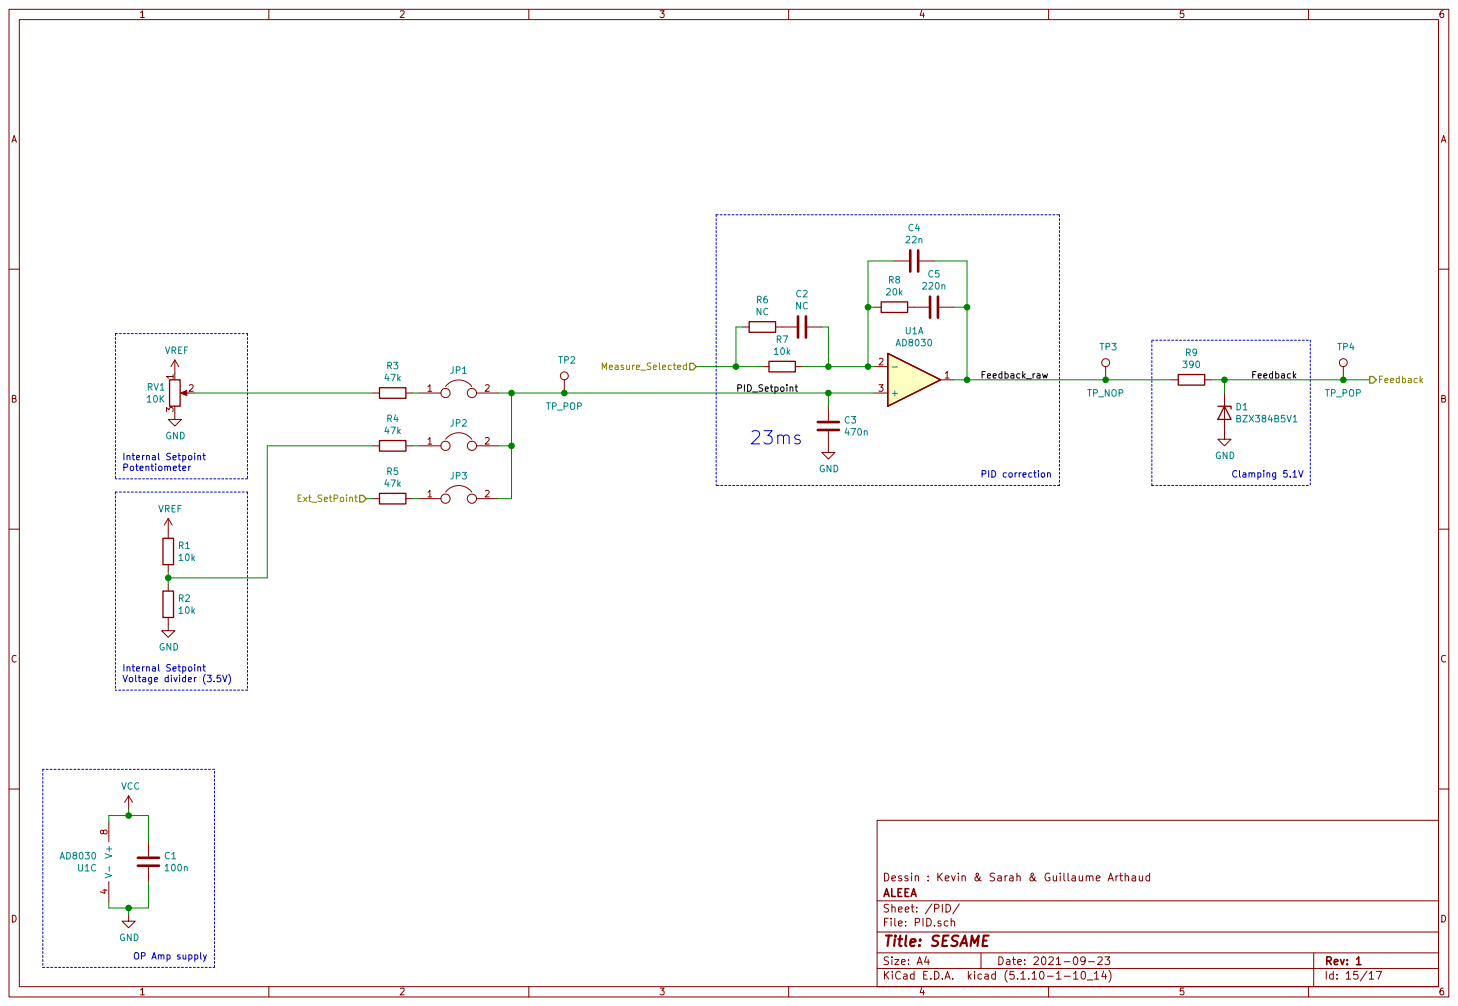
[picture p35: page 15]

10K GND
Internal Setpoint Potentiometer OP Amp supply

Dessin : Kevin & Sarah & Guillaume Arthaud GND

File: PID.sch Sheet: /PID/ ALEEA

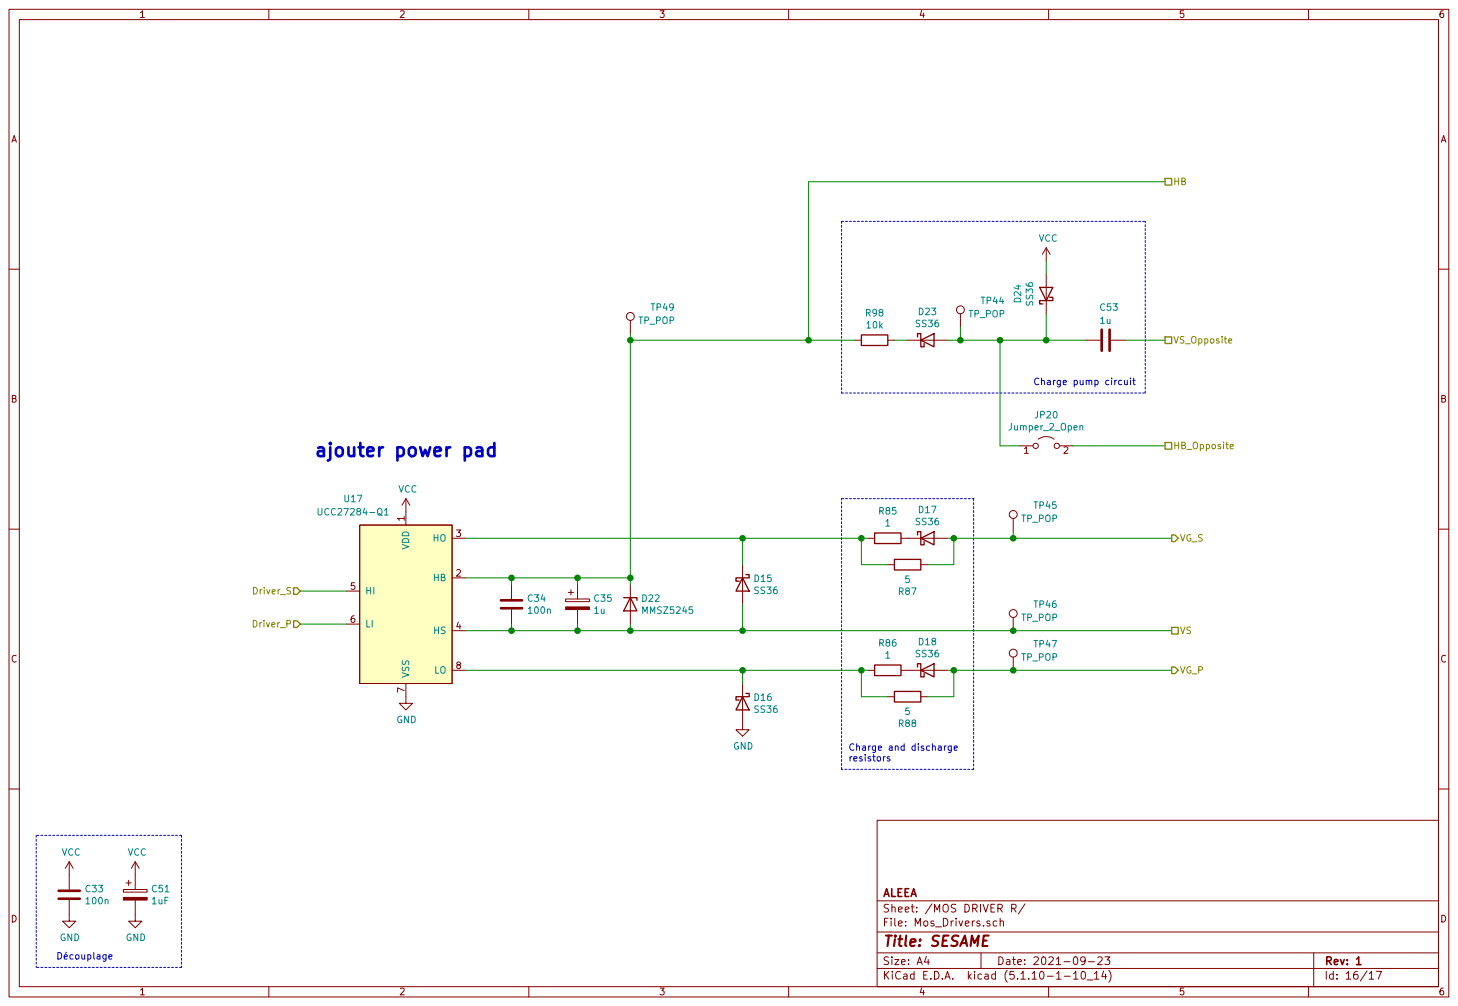
[picture p36: page 16]

resistors ajouter power pad

File: Mos_Drivers.sch Sheet: /MOS DRIVER R/ ALEEA

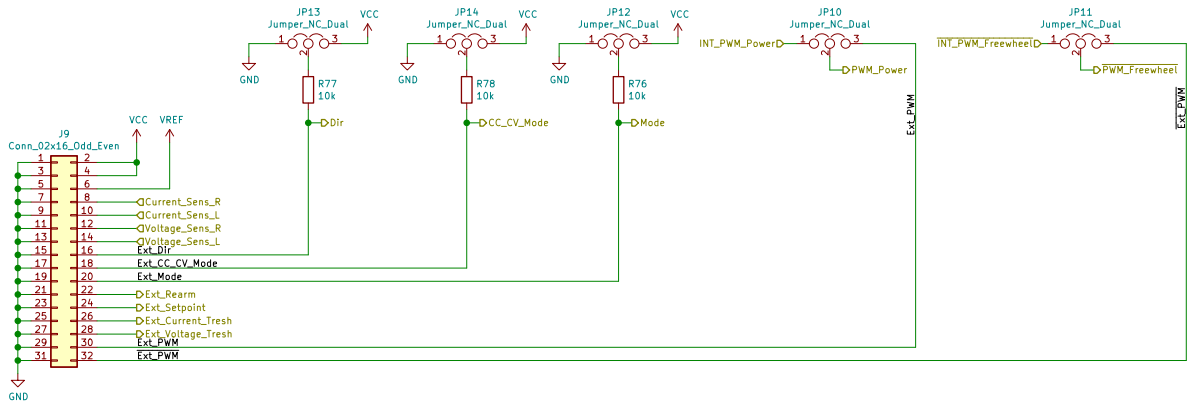
[picture p37: page 17]

9 | 10
11 | 12
13 | 14
15 | 16
17 | 18
19 | 20
21 | 22
23 | 24
25 | 26
27 | 28
29 | 30
31 | 32 Ext_PWM

File: Int_Ext_Config.sch Sheet: /INT EXT CONFIG/ ALEEA
