Antho32170/ETD2/DOCS/PLANS/plan percage detourage.pdf

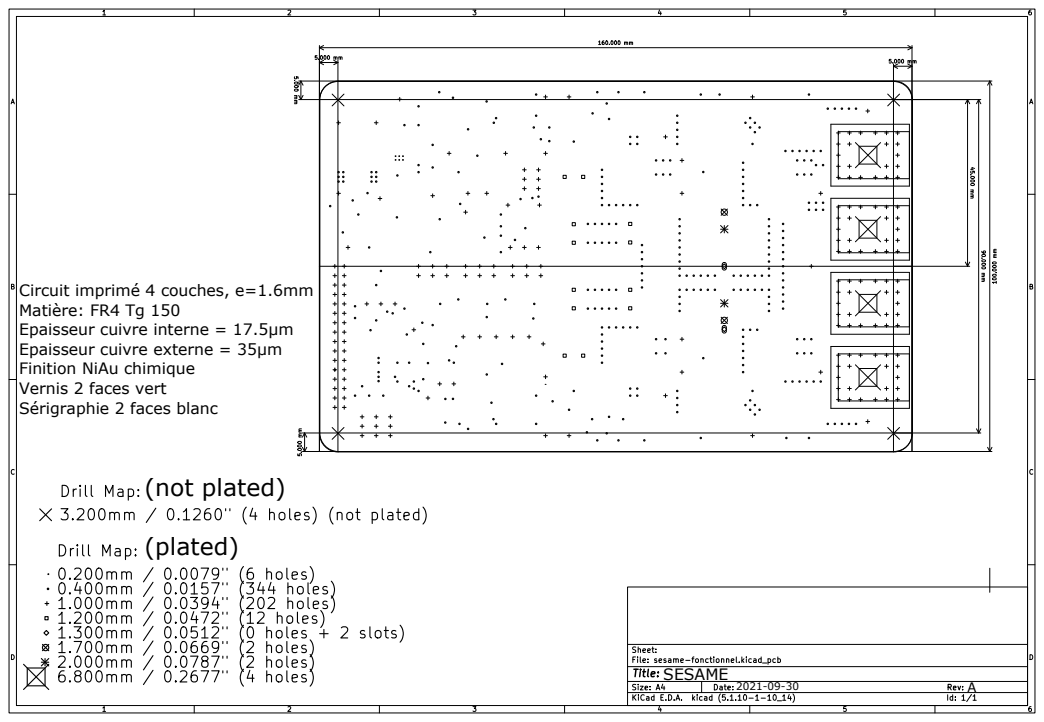
[picture p38: page 1]
(not plated); (plated); SESAME

Circuit imprimé 4 couches, e=1.6mm
Matière: FR4 Tg 150
Epaisseur cuivre interne = 17.5µm
Epaisseur cuivre externe = 35µm
Finition NiAu chimique
Vernis 2 faces vert
Sérigraphie 2 faces blanc
