Antho32170/ETD2/KICAD/dual_LT6105/dual_LT6105.pdf

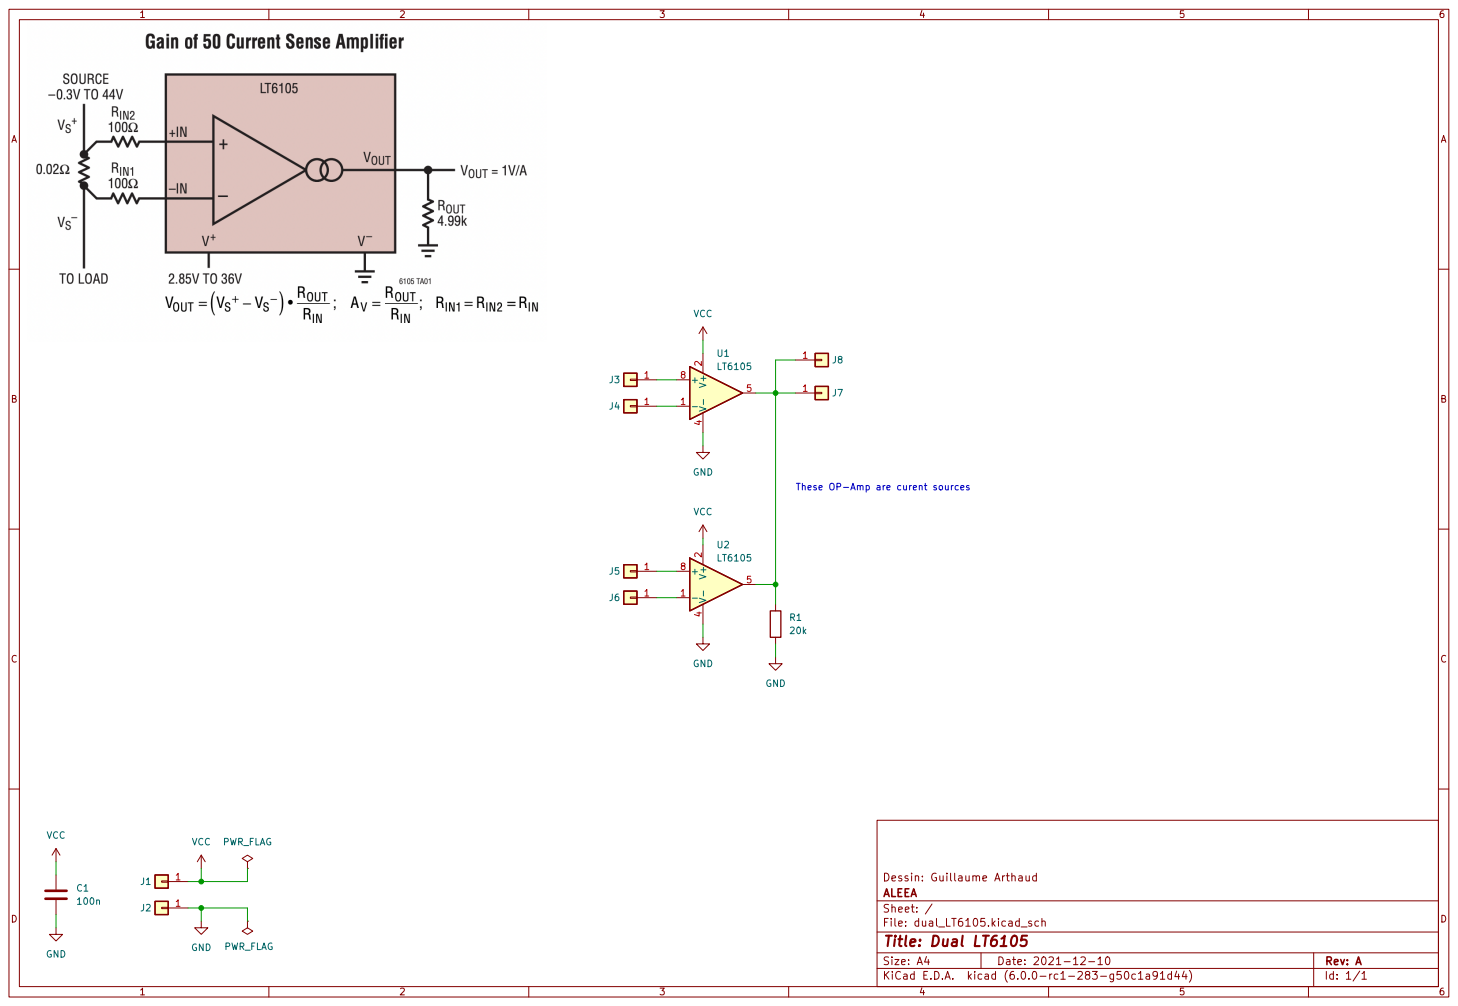
[picture p39: page 1]

These OP-Amp are curent sources
