Antho32170/ETD2/FAB/REV_A1/sesame-fonctionnel-plan-2.pdf

## xxx

x

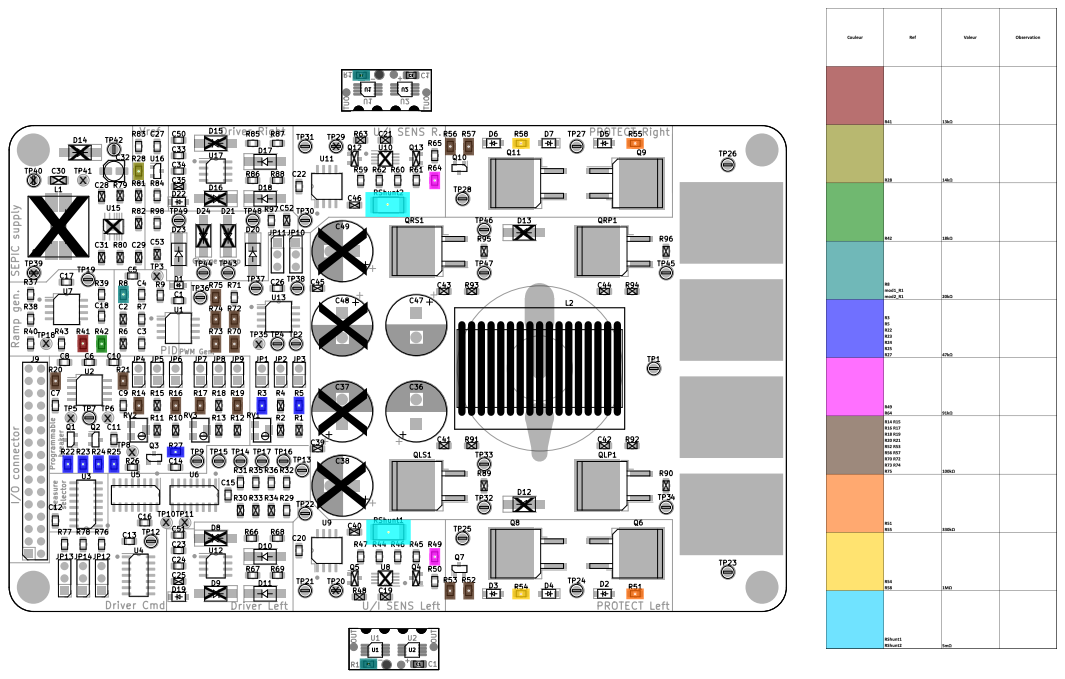
[picture p41: page 1]
x x x x x xxx
