Antho32170/ETD2/FAB/REV_A1/sesame-fonctionnel-plan-4.pdf

## xxx

x

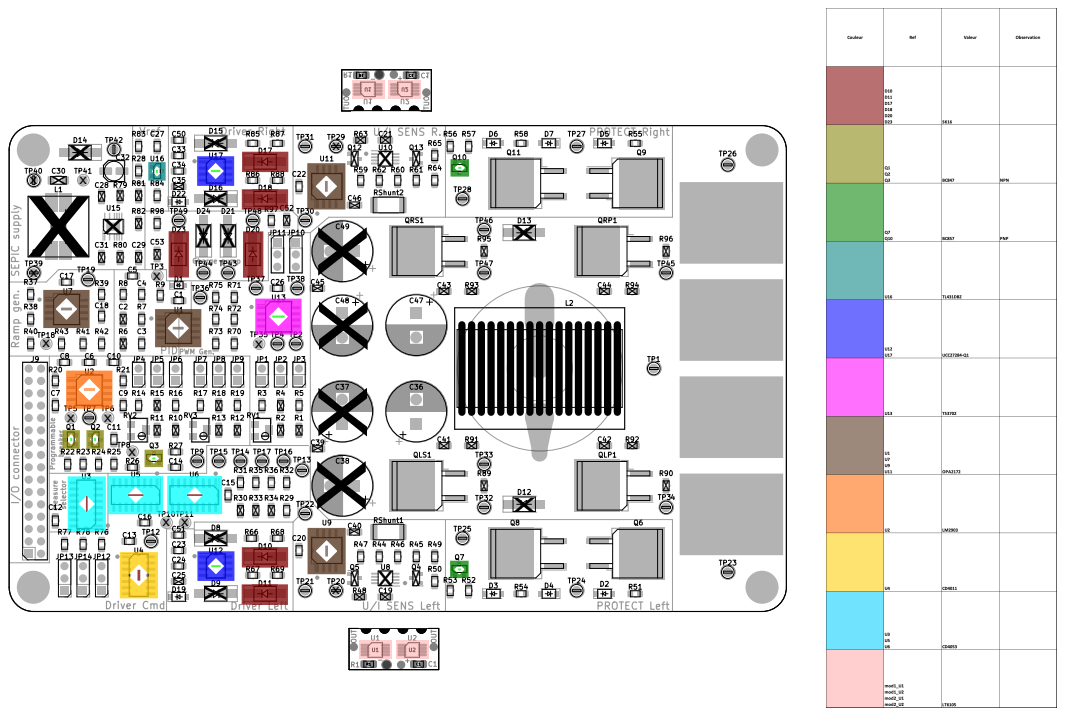
[picture p43: page 1]
x x x x x xxx
