Antho32170/ETD2/SPICE/Diode schottky alims test 1.asc

D1: schottky
D2: schottky
L1: ind; 1m
R1: res; 100
V1: voltage; 15
V2: voltage; 17
Named nets: 0
.tran 5m
