Antho32170/ETD2/SPICE/elevateur_parfait Diode schottky alims test 2.asc

C1: cap; 1µ
D1: schottky
D2: schottky
L1: ind; 470µ
R1: res; 100
S1: sw; ""
S2: sw; ""
V1: voltage; 12
V2: voltage; PULSE(0 5 5u 100n 100n 4.9u 10u)
Named nets: 0, VDC, VOUT, HACHE, PWM
.model normally_closed SW(Ron=10meg Roff=1m Vt=2.5 Vh=0)
.tran 2m startup
.model normally_open SW(Ron=1m Roff=10meg Vt=2.5 Vh=0)
