Antho32170/ETD2/SPICE/sim_current_sens_lt6016.asc

Q1: npn; BC547B
Q2: npn; BC547B
R1: res; 0.005
R2: res; 200
R3: res; 2.5
R4: res; 200
R5: res; 1k
R6: res; 20k
R7: res; 200
R8: res; 200
R9: res; 2.5
U1: LT6016
U2: LT6016
U3: AD8030
V1: voltage; 7; Rser=0.01
V3: voltage; SINE(5 1.25 1 0 0 180); Rser=0
V4: voltage; SINE(5 1.25 1 0 0 0); Rser=0
Named nets: VCC, 0
.lib ina240a2.lib
.tran 3s startup
