Antho32170/ETD2/SPICE/sim_current_sens_lt6101.asc

R1: res; 0.005
R2: res; 200
R3: res; 2.5
R4: res; 200
R6: res; 20k
R9: res; 2.5
U1: LTC6101
U2: AD8030
U3: LTC6101
V1: voltage; 7; Rser=0.01
V3: voltage; SINE(25 25 1 0 0 180); Rser=0
V4: voltage; SINE(25 25 1 0 0 0); Rser=0
Named nets: VCC, 0
.lib ina240a2.lib
.tran 3s startup
