Antho32170/ETD2/SPICE/alim_sepic.asc

C1: cap; 1µ; Rser=0.01
C2: cap; 10n
C3: cap; 6.8n
C4: cap; 10µ
C5: cap; 100µ; Rser=0.01
C6: cap; 10µ; Rser=0.01
C7: cap; 100µ; Rser=0.01
C8: cap; 10µ; Rser=0.01
D1: schottky; SS24
D2: schottky; SS24
D3: schottky; SS24
L1: ind2; 40µ; Rser=0.01
L2: ind2; 40µ; Rser=0.01
R1: res; 90k
R2: res; 33k
R3: res; 1000k
R4: res; 296k
R5: res; 40
U1: LT8365
V1: voltage; PULSE(0 48 10m 10m 10m); Rser=0.1
V2: voltage; 4; Rser=0.1
Named nets: 0, Vout, Vin
.tran 100m startup
.tran 0 1000m 0 1u
K L1 L2 1
