Antho32170/ETD2/SPICE/sim_current_ina240.asc

R1: res; 0.01
R2: res; 10k
R3: res; 5
R4: res; 10k
R5: res; 10k
R6: res; 10k
R7: res; 10k
R8: res; 10k
R9: res; 10k
R10: res; 10k
R11: res; 10k
R12: res; 10k
R13: res; 10k
R14: res; 10k
R15: res; 10k
R16: res; 10k
U1: INA240A2
U2: LT1366
U3: LT1366
U4: LT1366
U5: LT1366
V1: voltage; 5
V2: voltage; PULSE(0 10 0 0 0 0.5s 1s)
V3: voltage; PULSE(0 10 0.5s 0 0 0.5s 1s)
V4: voltage; PULSE(0 5 0 0 0 0.5s 1s)
Named nets: VCC, 0, CURRENT_SENS, VDir, VMeasure
.lib ina240a2.lib
.tran 900m
INA240A2: 50 V/V
@10V = 50A -> 5V -> 0.1V
@10V = 5A -> 0.5V -> 0.01V
si dir = 5v alors signal = 5-out
si dir = 0v alors signal = out
(VMeasure - VDir) + (VDir - VMeasure)
VMeasure - VDir
VDir - VMeasure
