Antho32170/ETD2/SPICE/calibre_courant.asc

R1: res; 10k
R2: res; 10k
R3: res; 90k
R4: res; 10k
R5: res; 10k
R6: res; 10k
U1: LT1006
U2: LT1006
V1: voltage; SINE(25 25 1)
V2: voltage; 5
Named nets: 0, 5V, Seuil
.tran 0 1s
