Antho32170/ETD2/SPICE/Meusure de courant bidir 4 (nw).asc

R1: res; 10k
R2: res; 10k
R4: res; 10k
R5: res; 0,1
R6: res; 10
R7: res; 10k
U1: LT1006
U2: LT1006
V1: voltage; 12v
V2: voltage; 5V
Named nets: 0, +5V
.tran 5m
