Antho32170/ETD2/SPICE/VREF/TL431.asc

R1: res; 200
R2: res; 10k
R3: res; 14048
U1: TL431
V1: voltage; 7
Named nets: 0
.include tl431.mod
.tran 100m
