Antho32170/ETD2/SPICE/LM393/LM393.asc

R1: res; 3k
R2: res; 10K
R4: res; 10k
U2: LM393
V1: voltage; PULSE(0 5.1 0 0 0 500m 1s); Rser=0
V2: voltage; 7
Named nets: 0, VCC, PULSE
.tran 2s
.lib LM393.asc
