Antho32170/ETD2/KICAD/sesame-fonctionnel.kicad_pcb

## KiCad design KICAD/sesame-fonctionnel.kicad_pcb (2021-12-02)

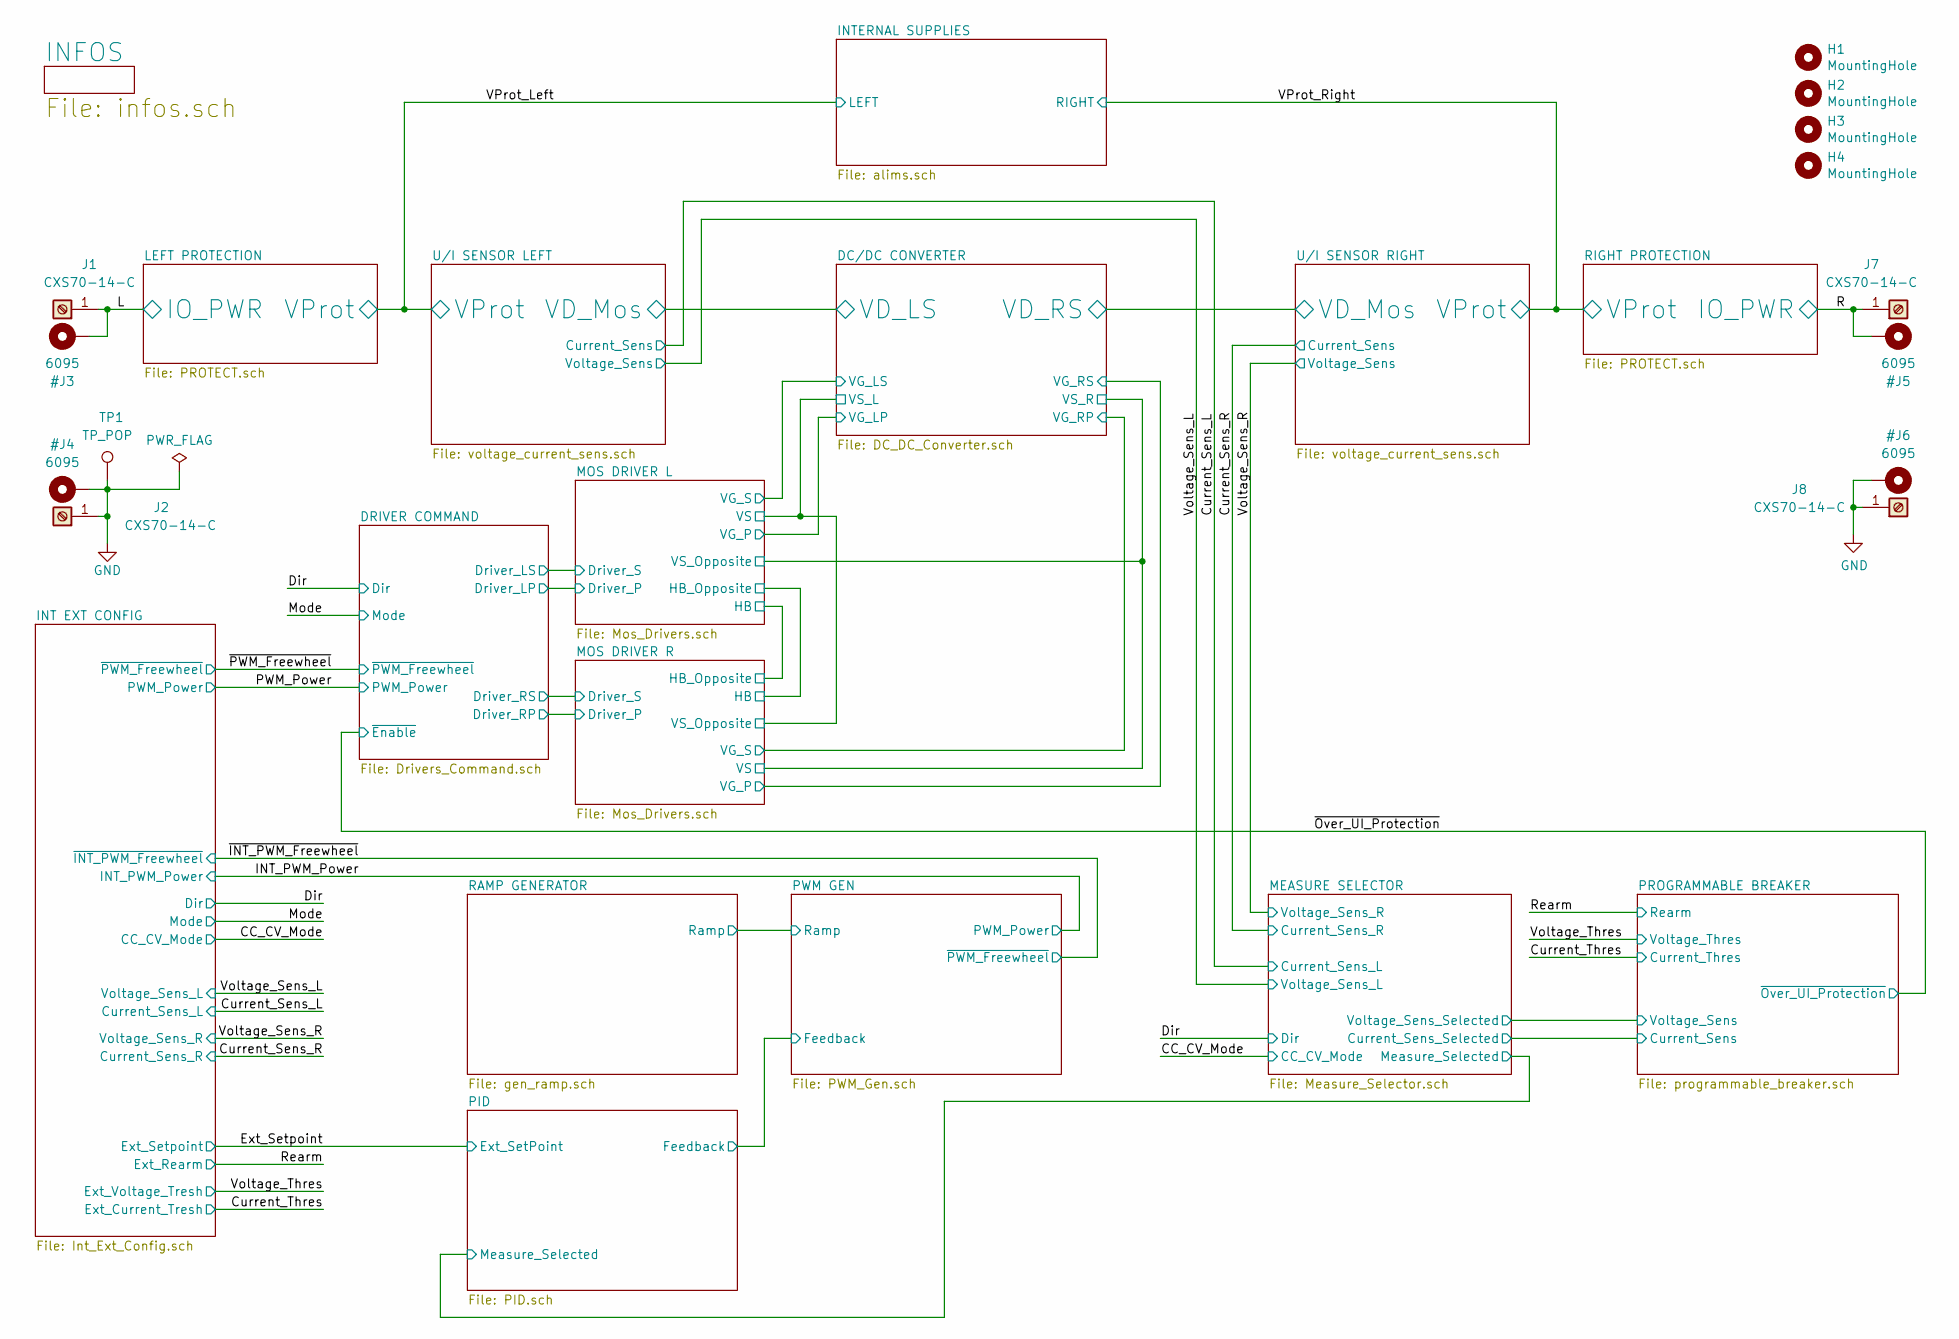
[picture p45: schematic sesame-fonctionnel.sch, SESAME]

Parts:
H1, H2, H3, H4: MountingHole; MountingHole_3.2mm_M3
J1, J2, J7, J8: CXS70-14-C
TP1: TP_POP; TestPoint_Loop_D1.80mm_Drill1.0mm_Beaded

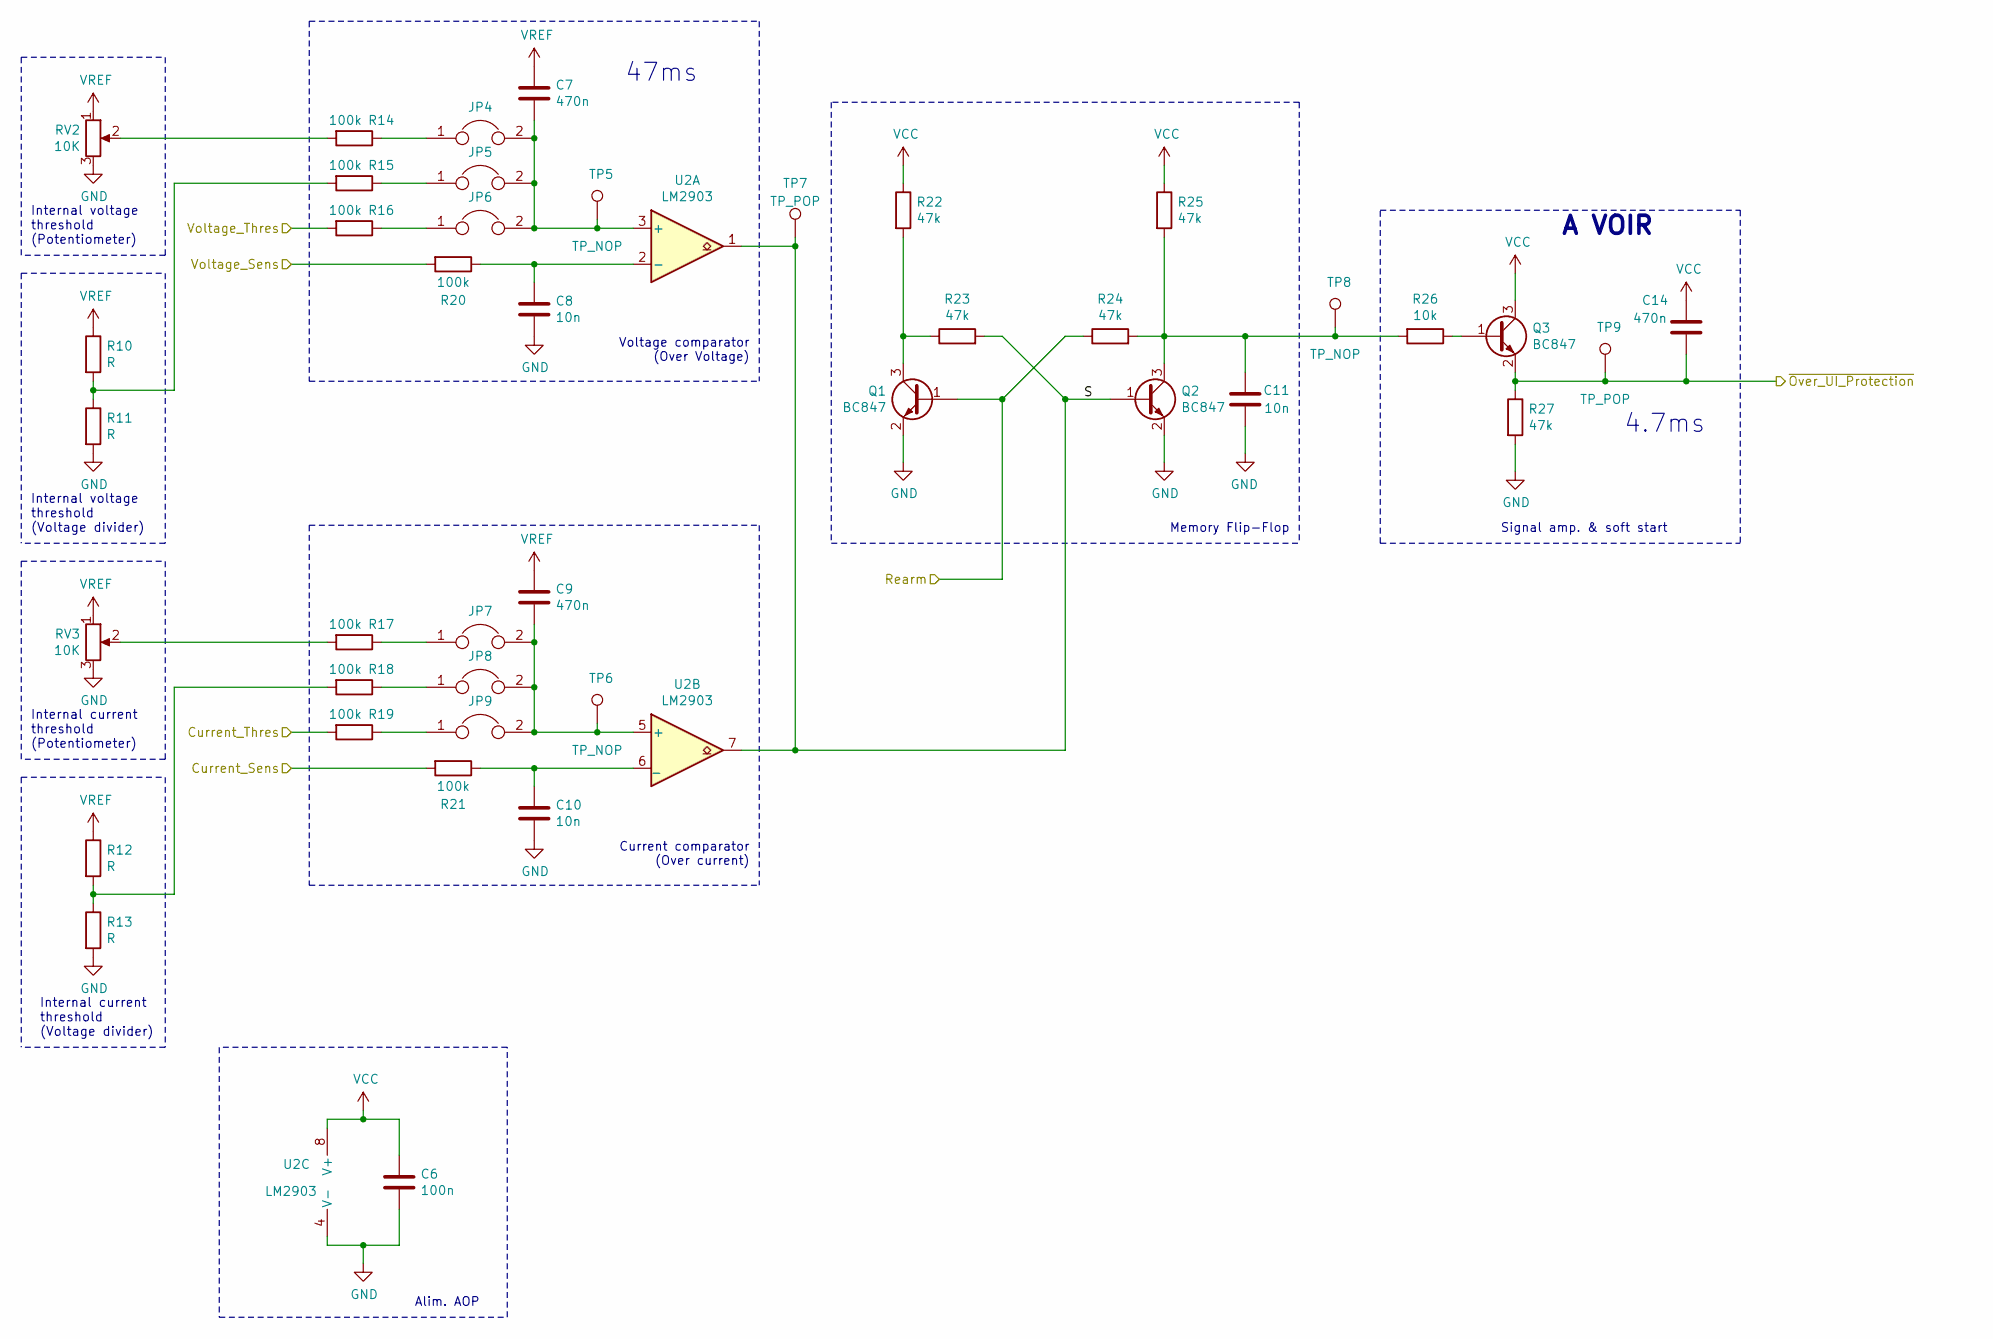
[picture p46: schematic programmable_breaker.sch, SESAME]

Parts:
C6: 100n; C_0805_2012Metric_Pad1.18x1.45mm_HandSolder
C7, C9, C14: 470n; C_0805_2012Metric_Pad1.18x1.45mm_HandSolder
C8, C10, C11: 10n; C_0805_2012Metric_Pad1.18x1.45mm_HandSolder
JP4, JP5, JP6, JP7, JP8, JP9: Jumper; PinHeader_1x02_P2.54mm_Vertical
Q1, Q2, Q3: BC847; SOT-23
R10, R11, R12, R13: R; R_0805_2012Metric_Pad1.20x1.40mm_HandSolder
R14, R15, R16, R17, R18, R19, R20, R21: 100k; R_0805_2012Metric_Pad1.20x1.40mm_HandSolder
R22, R23, R24, R25, R27: 47k; R_0805_2012Metric_Pad1.20x1.40mm_HandSolder
R26: 10k; R_0805_2012Metric_Pad1.20x1.40mm_HandSolder
RV2, RV3: 10K; Potentiometer_Bourns_3214W_Vertical
TP5, TP6, TP8: TP_NOP; TestPoint_THTPad_D2.0mm_Drill1.0mm
TP7, TP9: TP_POP; TestPoint_Loop_D1.80mm_Drill1.0mm_Beaded
U2: LM2903; SO-8_5.3x6.2mm_P1.27mm

Connections:
/Current_Thres: R19.2; also elsewhere on the board
/PROGRAMMABLE BREAKER/Current_Sens: R21.2; also elsewhere on the board
/PROGRAMMABLE BREAKER/S: Q2.1 (B), R23.2, TP7.1, U2.1, U2.7
/PROGRAMMABLE BREAKER/Voltage_Sens: R20.2; also elsewhere on the board
/Rearm: Q1.1 (B), R24.1; also elsewhere on the board
/Voltage_Thres: R16.2; also elsewhere on the board
/~Over_UI_Protection: C14.2, Q3.2 (E), R27.1, TP9.1; also elsewhere on the board
unnamed: C7.2, JP4.2, JP5.2, JP6.2, TP5.1, U2.3 (+)
unnamed: C8.1, R20.1, U2.2 (-)
unnamed: C9.2, JP7.2, JP8.2, JP9.2, TP6.1, U2.5 (+)
unnamed: C10.1, R21.1, U2.6 (_)
unnamed: C11.1, Q2.3 (C), R24.2, R25.2, R26.2, TP8.1
unnamed: JP4.1, R14.1
unnamed: JP5.1, R15.1
unnamed: JP6.1, R16.1
unnamed: JP7.1, R17.1
unnamed: JP8.1, R18.1
unnamed: JP9.1, R19.1
unnamed: Q1.3 (C), R22.2, R23.1
unnamed: Q3.1 (B), R26.1
unnamed: R10.2, R11.1, R15.2
unnamed: R12.2, R13.1, R18.2
unnamed: R14.2, RV2.2
unnamed: R17.2, RV3.2
VCC: C6.1, C14.1, Q3.3 (C), R22.1, R25.1, U2.8 (V+); also elsewhere on the board
VREF: C7.1, C9.1, R10.1, R12.1, RV2.1, RV3.1; also elsewhere on the board

Notes on the sheet:
Voltage comparator (Over Voltage)
Memory Flip-Flop
Alim. AOP
Signal amp. & soft start
Internal voltage threshold (Potentiometer)
Internal voltage threshold (Voltage divider)
Current comparator (Over current)
Internal current threshold (Voltage divider)
Internal current threshold (Potentiometer)
4.7ms
47ms
A VOIR

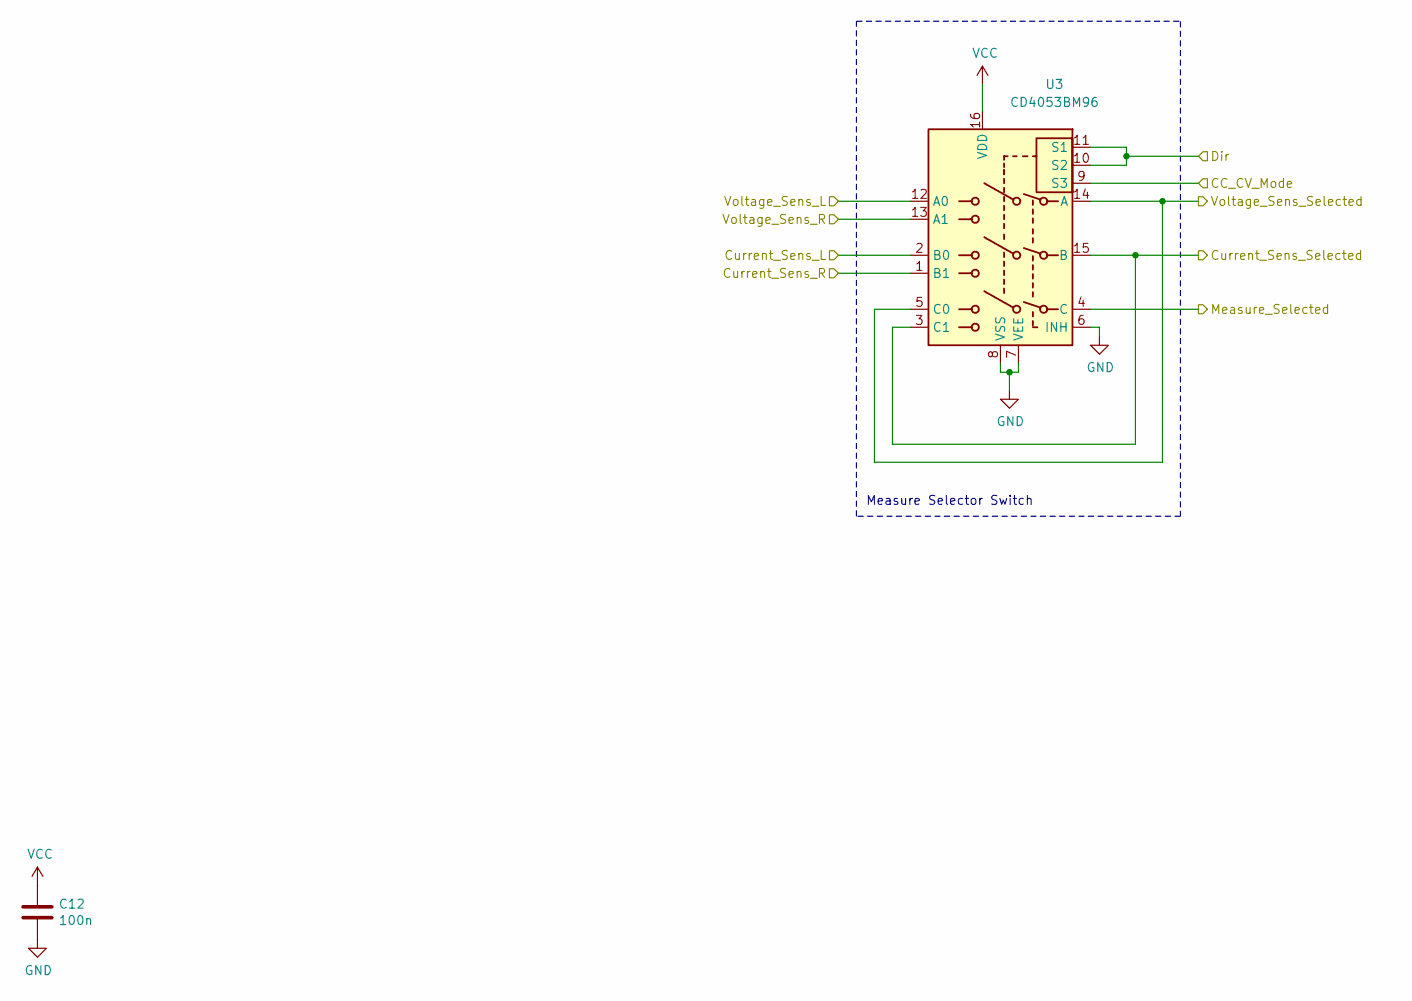
[picture p47: schematic Measure_Selector.sch, SESAME]

Parts:
C12: 100n; C_0805_2012Metric_Pad1.18x1.45mm_HandSolder
U3: CD4053BM96; SOIC-16_3.9x9.9mm_P1.27mm

Connections:
/CC_CV_Mode: U3.9 (S3); also elsewhere on the board
/Current_Sens_L: U3.2 (B0); also elsewhere on the board
/Current_Sens_R: U3.1 (B1); also elsewhere on the board
/Dir: U3.10 (S2), U3.11 (S1); also elsewhere on the board
/MEASURE SELECTOR/Measure_Selected: U3.4 (C); also elsewhere on the board
/PROGRAMMABLE BREAKER/Current_Sens: U3.3 (C1), U3.15 (B); also elsewhere on the board
/PROGRAMMABLE BREAKER/Voltage_Sens: U3.5 (C0), U3.14 (A); also elsewhere on the board
/Voltage_Sens_L: U3.12 (A0); also elsewhere on the board
/Voltage_Sens_R: U3.13 (A1); also elsewhere on the board
VCC: C12.1, U3.16 (VDD); also elsewhere on the board

Notes on the sheet:
Measure Selector Switch

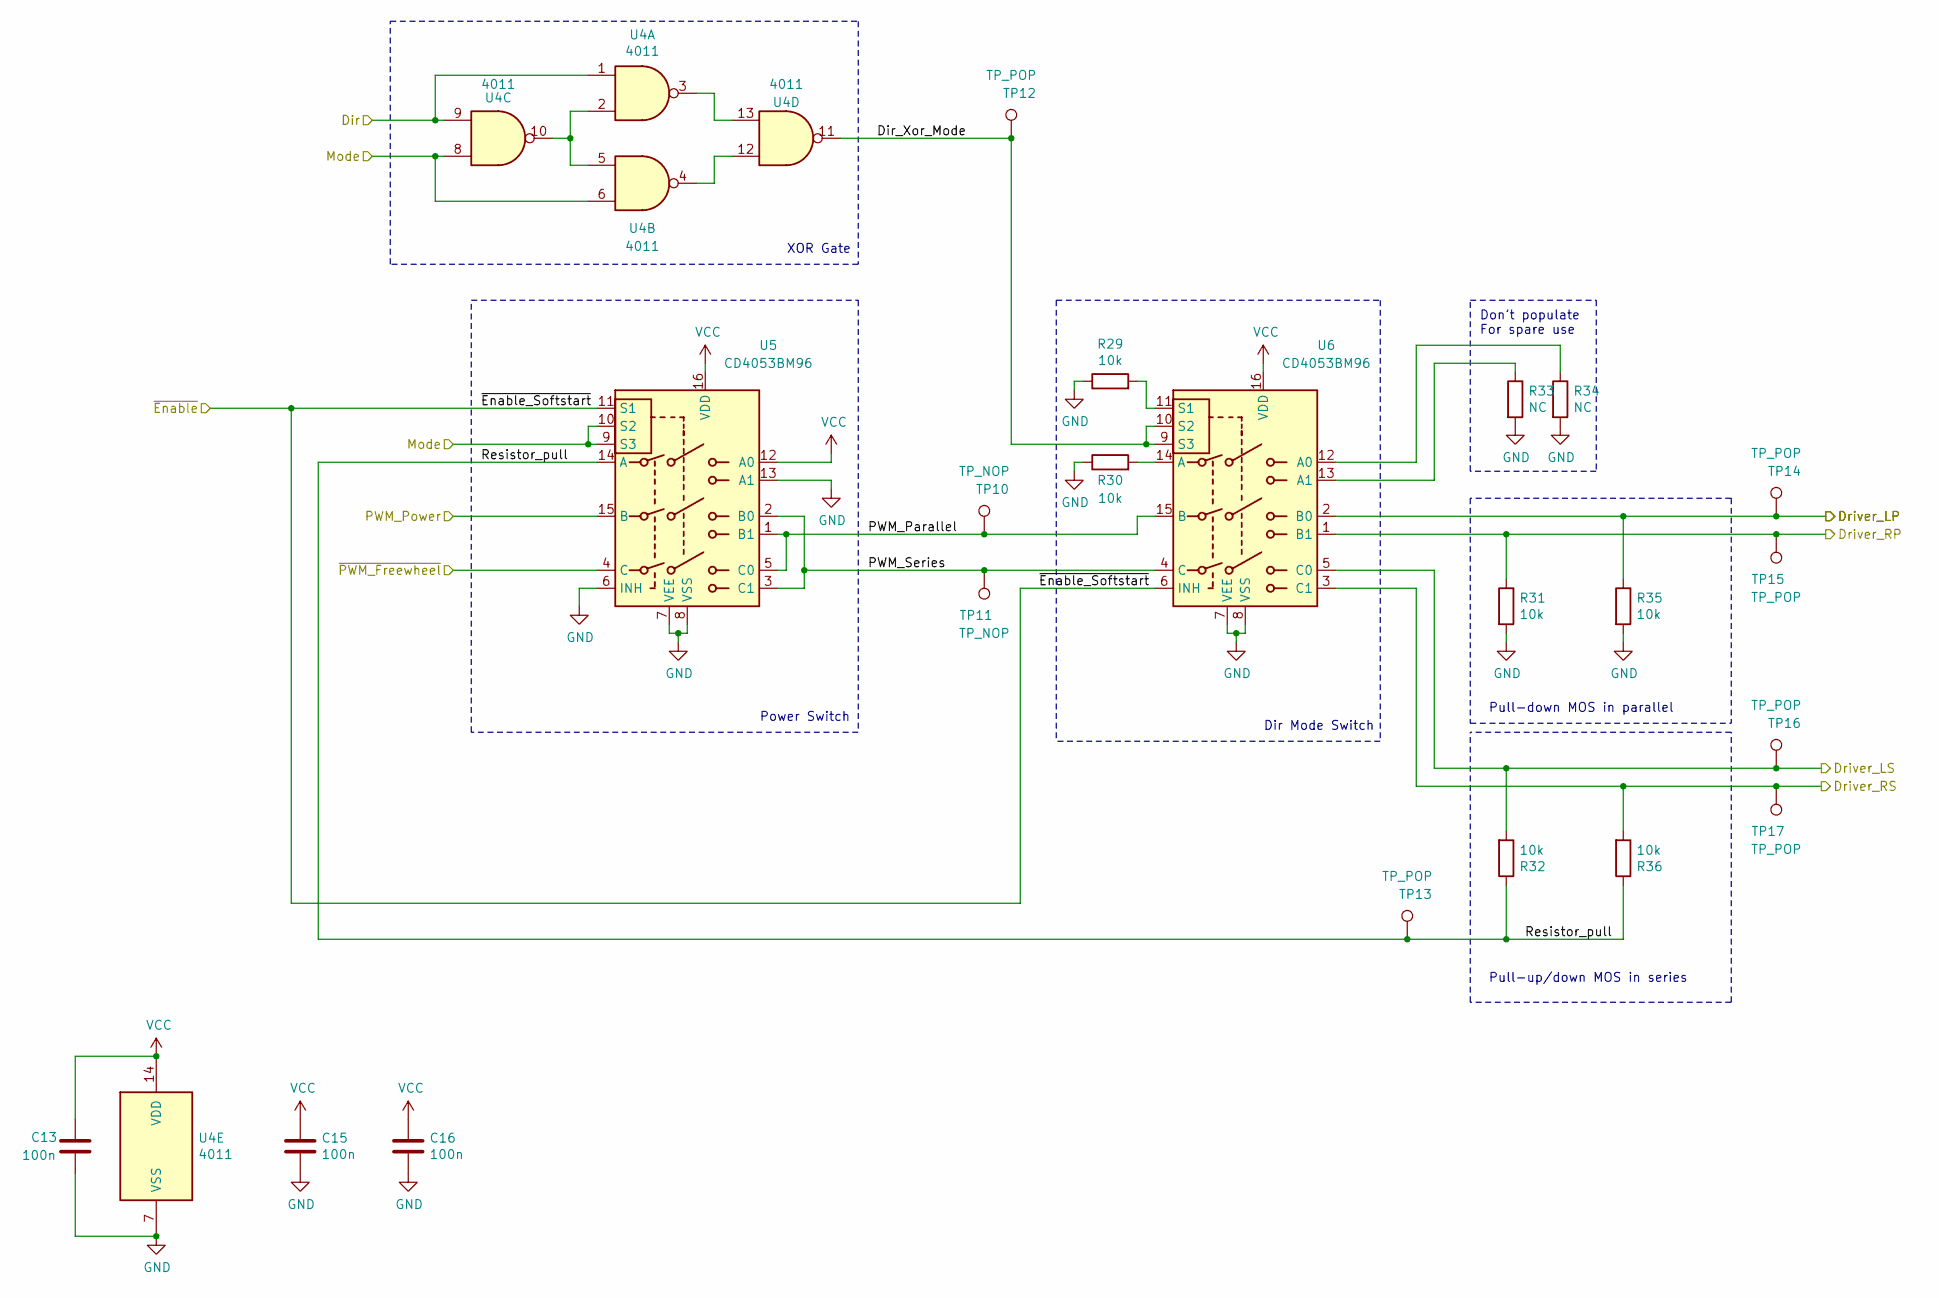
[picture p48: schematic Drivers_Command.sch, SESAME]

Parts:
C13, C15, C16: 100n; C_0805_2012Metric_Pad1.18x1.45mm_HandSolder
R29, R30, R31, R32, R35, R36: 10k; R_0805_2012Metric_Pad1.20x1.40mm_HandSolder
R33, R34: NC; R_0805_2012Metric_Pad1.20x1.40mm_HandSolder
TP10, TP11: TP_NOP; TestPoint_THTPad_D2.0mm_Drill1.0mm
TP12, TP13, TP14, TP15, TP16, TP17: TP_POP; TestPoint_Loop_D1.80mm_Drill1.0mm_Beaded
U4: 4011; SOIC-14_3.9x8.7mm_P1.27mm
U5, U6: CD4053BM96; SOIC-16_3.9x9.9mm_P1.27mm

Connections:
/DRIVER COMMAND/Dir_Xor_Mode: TP12.1, U4.11, U6.9 (S3), U6.10 (S2)
/DRIVER COMMAND/Driver_LP: R35.1, TP14.1, U6.2 (B0); also elsewhere on the board
/DRIVER COMMAND/Driver_LS: R32.2, TP16.1, U6.5 (C0); also elsewhere on the board
/DRIVER COMMAND/Driver_RS: R36.2, TP17.1, U6.3 (C1); also elsewhere on the board
/DRIVER COMMAND/PWM_Parallel: TP10.1, U5.1 (B1), U5.5 (C0), U6.15 (B)
/DRIVER COMMAND/PWM_Series: TP11.1, U5.2 (B0), U5.3 (C1), U6.4 (C)
/DRIVER COMMAND/Resistor_pull: R32.1, R36.1, TP13.1, U5.14 (A)
/Dir: U4.1, U4.9; also elsewhere on the board
/MOS DRIVER R/Driver_P: R31.1, TP15.1, U6.1 (B1); also elsewhere on the board
/Mode: U4.6, U4.8, U5.9 (S3), U5.10 (S2); also elsewhere on the board
/PWM_Power: U5.15 (B); also elsewhere on the board
/~Over_UI_Protection: U5.11 (S1), U6.6 (INH); also elsewhere on the board
/~PWM_Freewheel: U5.4 (C); also elsewhere on the board
unnamed: R29.2, U6.11 (S1)
unnamed: R30.2, U6.14 (A)
unnamed: R33.1, U6.13 (A1)
unnamed: R34.1, U6.12 (A0)
unnamed: U4.2, U4.5, U4.10
unnamed: U4.4, U4.12
unnamed: U4.3, U4.13
VCC: C13.1, C15.1, C16.1, U4.14 (VDD), U5.12 (A0), U5.16 (VDD), U6.16 (VDD); also elsewhere on the board

Notes on the sheet:
Pull-down MOS in parallel
XOR Gate
Don’t populate For spare use
Pull-up/down MOS in series
Power Switch
Dir Mode Switch

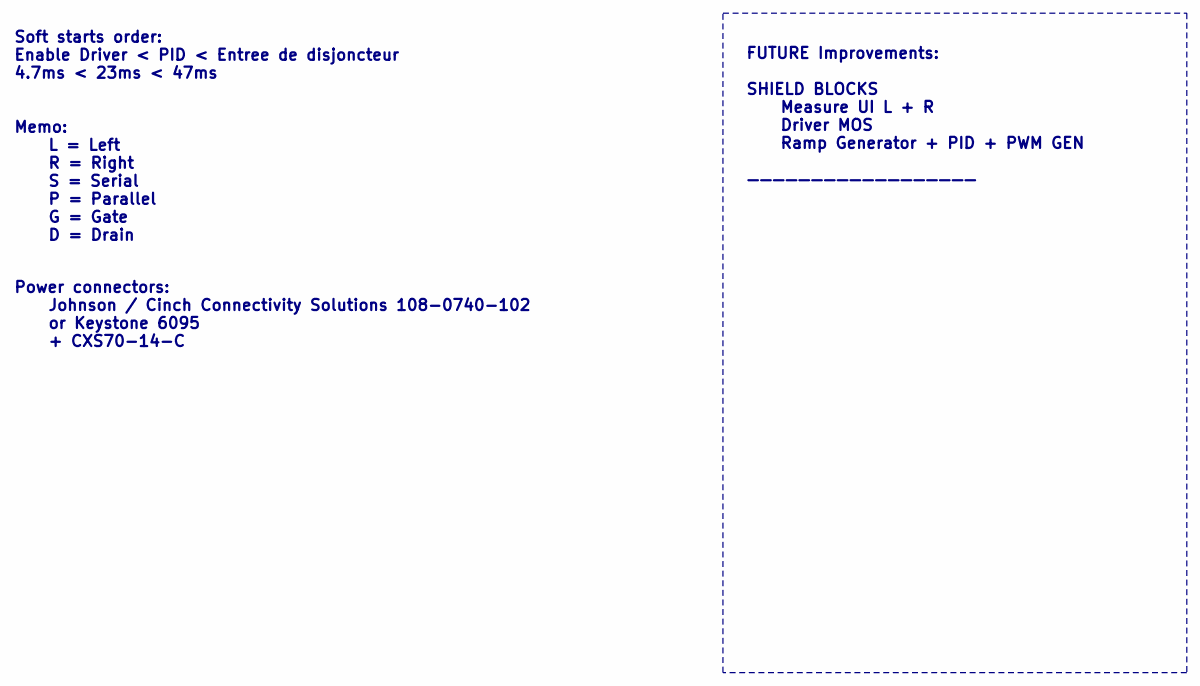
[picture p49: schematic infos.sch, SESAME]

Notes on the sheet:
Soft starts order: Enable Driver < PID < Entree de disjoncteur 4.7ms < 23ms < 47ms
FUTURE Improvements: SHIELD BLOCKS Measure UI L + R Driver MOS Ramp Generator + PID + PWM GEN ——————————————————
Memo: L = Left R = Right S = Serial P = Parallel G = Gate D = Drain
Power connectors: Johnson / Cinch Connectivity Solutions 108-0740-102 or Keystone 6095 + CXS70-14-C

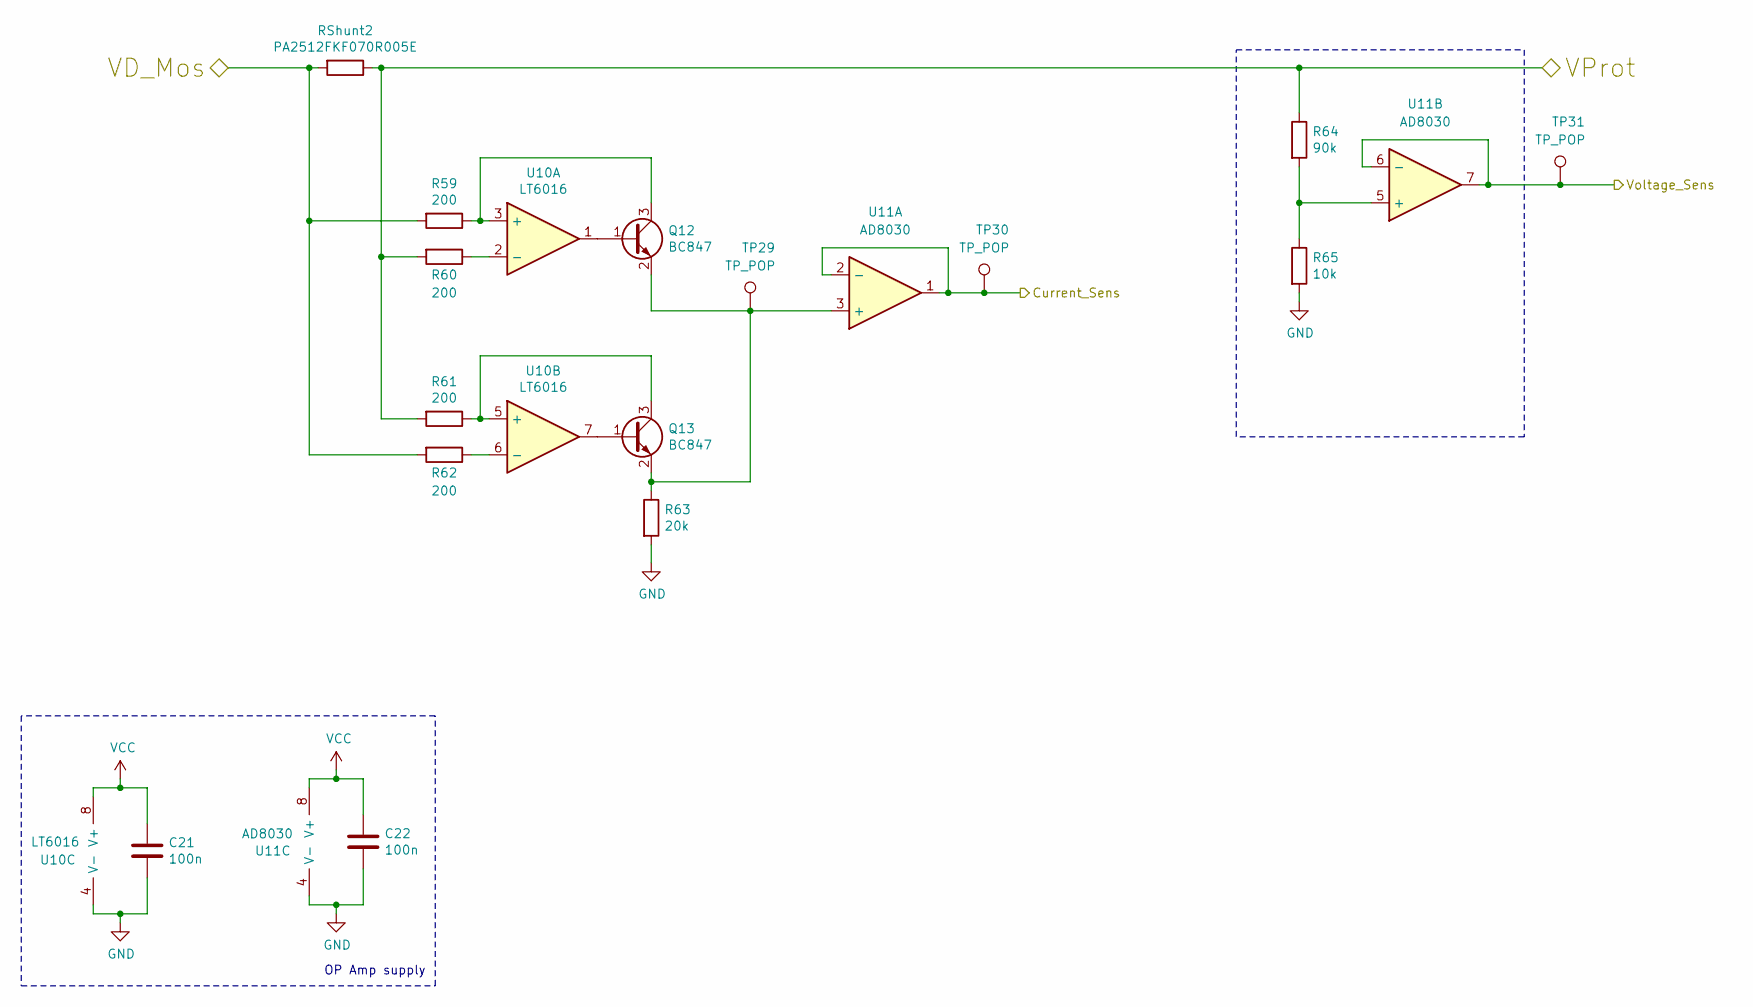
[picture p50: schematic voltage_current_sens.sch, SESAME]

Parts:
C19, C20: 100n; C_0805_2012Metric_Pad1.18x1.45mm_HandSolder
Q4, Q5: BC847; SOT-23
R48: 20k; R_0805_2012Metric_Pad1.20x1.40mm_HandSolder
R49: 90k; R_0805_2012Metric_Pad1.20x1.40mm_HandSolder
R50: 10k; R_0805_2012Metric_Pad1.20x1.40mm_HandSolder
R59, R60, R61, R62: 200; R_0805_2012Metric_Pad1.20x1.40mm_HandSolder
RShunt2: PA2512FKF070R005E; R_2512_6332Metric_Pad1.52x3.35mm_HandSolder
TP20, TP21, TP22: TP_POP; TestPoint_Loop_D1.80mm_Drill1.0mm_Beaded
U8: LT6016; MSOP-8_3x3mm_P0.65mm
U9: AD8030; SO-8_5.3x6.2mm_P1.27mm

Connections:
/Current_Sens_L: TP21.1, U9.1, U9.2 (-); also elsewhere on the board
/U/I SENSOR RIGHT/VD_Mos: R59.2, R62.2, RShunt2.2; also elsewhere on the board
/Voltage_Sens_L: TP22.1, U9.6 (-), U9.7; also elsewhere on the board
unnamed: Q4.1 (B), U8.1
unnamed: Q4.2 (E), Q5.2 (E), R48.1, TP20.1, U9.3 (+)
unnamed: Q5.1 (B), U8.7
unnamed: R49.2, R50.1, U9.5 (+)
VCC: C19.1, C20.1, U8.8 (V+), U9.8 (V+); also elsewhere on the board

Parts of its further copies:
C21, C22: 100n; C_0805_2012Metric_Pad1.18x1.45mm_HandSolder
Q12, Q13: BC847; SOT-23
R44, R45, R46, R47: 200; R_0805_2012Metric_Pad1.20x1.40mm_HandSolder
R63: 20k; R_0805_2012Metric_Pad1.20x1.40mm_HandSolder
R64: 90k; R_0805_2012Metric_Pad1.20x1.40mm_HandSolder
R65: 10k; R_0805_2012Metric_Pad1.20x1.40mm_HandSolder
RShunt1: PA2512FKF070R005E; R_2512_6332Metric_Pad1.52x3.35mm_HandSolder
TP29, TP30, TP31: TP_POP; TestPoint_Loop_D1.80mm_Drill1.0mm_Beaded
U10: LT6016; MSOP-8_3x3mm_P0.65mm
U11: AD8030; SO-8_5.3x6.2mm_P1.27mm

Connections of its further copies:
/Current_Sens_R: TP30.1, U11.1, U11.2 (-); also elsewhere on the board
/DC/DC CONVERTER/VD_LS: R44.2, R47.2, RShunt1.2; also elsewhere on the board
/Voltage_Sens_R: TP31.1, U11.6 (-), U11.7; also elsewhere on the board
unnamed: Q12.1 (B), U10.1
unnamed: Q12.2 (E), Q13.2 (E), R63.1, TP29.1, U11.3 (+)
unnamed: Q13.1 (B), U10.7
unnamed: R64.2, R65.1, U11.5 (+)
VCC: C21.1, C22.1, U10.8 (V+), U11.8 (V+); also elsewhere on the board

Notes on the sheet:
OP Amp supply

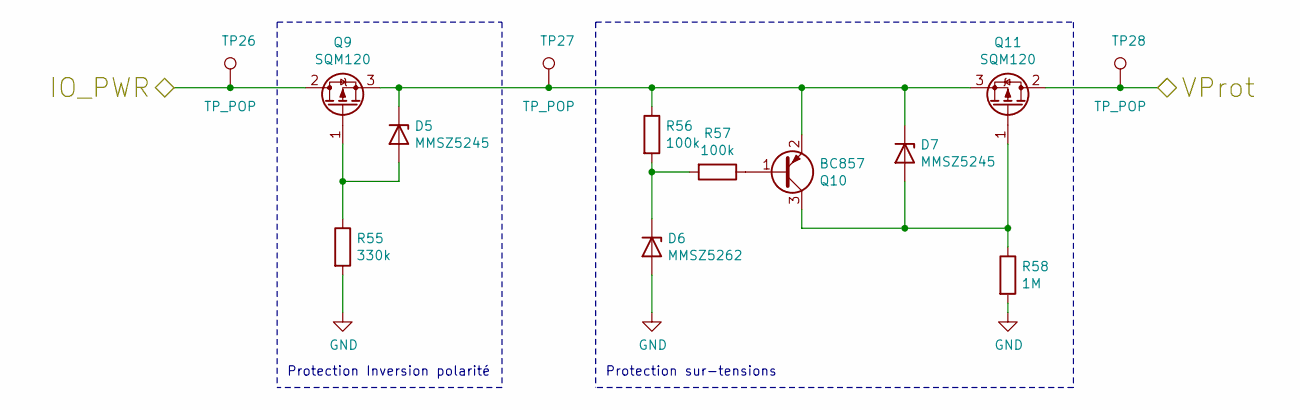
[picture p51: schematic PROTECT.sch, SESAME]

Parts:
D5, D7: MMSZ5245; D_SOD-123
D6: MMSZ5262; D_SOD-123
Q9, Q11: SQM120; TO-263-2
Q10: BC857; SOT-23
R55: 330k; R_0805_2012Metric_Pad1.20x1.40mm_HandSolder
R56, R57: 100k; R_0805_2012Metric_Pad1.20x1.40mm_HandSolder
R58: 1M; R_0805_2012Metric_Pad1.20x1.40mm_HandSolder
TP26, TP27, TP28: TP_POP; TestPoint_Loop_D1.80mm_Drill1.0mm_Beaded

Connections:
unnamed: D5.1 (K), D7.1 (K), Q9.3 (S), Q10.2 (E), Q11.3 (S), R56.1, TP27.1
unnamed: D5.2 (A), Q9.1 (G), R55.1
unnamed: D6.1 (K), R56.2, R57.2
unnamed: D7.2 (A), Q10.3 (C), Q11.1 (G), R58.1
unnamed: Q10.1 (B), R57.1

Parts of its further copies:
D2, D4: MMSZ5245; D_SOD-123
D3: MMSZ5262; D_SOD-123
Q6, Q8: SQM120; TO-263-2
Q7: BC857; SOT-23
R51: 330k; R_0805_2012Metric_Pad1.20x1.40mm_HandSolder
R52, R53: 100k; R_0805_2012Metric_Pad1.20x1.40mm_HandSolder
R54: 1M; R_0805_2012Metric_Pad1.20x1.40mm_HandSolder
TP23, TP24, TP25: TP_POP; TestPoint_Loop_D1.80mm_Drill1.0mm_Beaded

Connections of its further copies:
unnamed: D2.1 (K), D4.1 (K), Q6.3 (S), Q7.2 (E), Q8.3 (S), R52.1, TP24.1
unnamed: D2.2 (A), Q6.1 (G), R51.1
unnamed: D3.1 (K), R52.2, R53.2
unnamed: D4.2 (A), Q7.3 (C), Q8.1 (G), R54.1
unnamed: Q7.1 (B), R53.1

Notes on the sheet:
Protection sur-tensions
Protection Inversion polarité

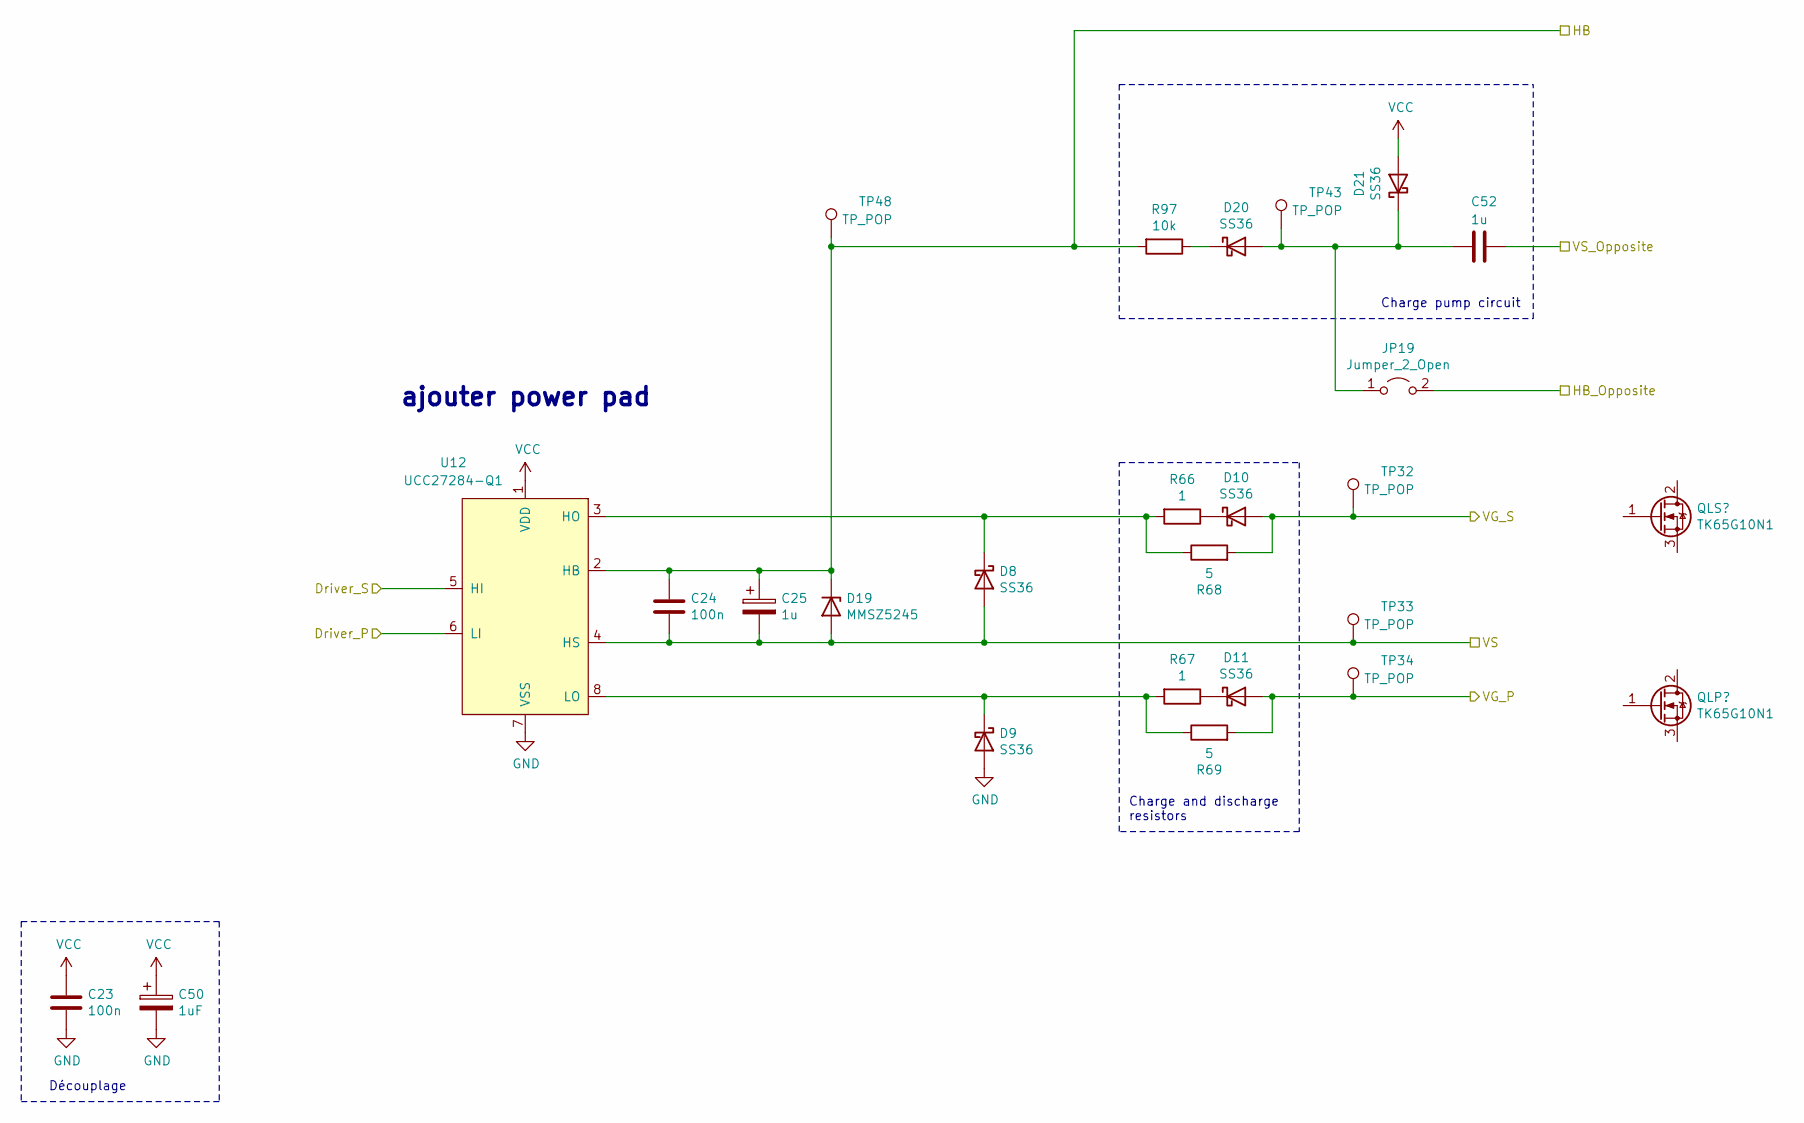
[picture p52: schematic Mos_Drivers.sch, SESAME]

Parts:
C23, C24: 100n; C_0805_2012Metric_Pad1.18x1.45mm_HandSolder
C25, C52: 1u; C_0805_2012Metric_Pad1.18x1.45mm_HandSolder
C50: 1uF; C_0805_2012Metric_Pad1.18x1.45mm_HandSolder
D8, D9, D10, D11, D20, D21: SS36; D_SMA_Handsoldering
D19: MMSZ5245; D_SOD-123
JP19: Jumper_2_Open; SolderJumper-2_P1.3mm_Open_TrianglePad1.0x1.5mm
R66, R67: 1; R_0805_2012Metric_Pad1.20x1.40mm_HandSolder
R68, R69: 5; R_0805_2012Metric_Pad1.20x1.40mm_HandSolder
R97: 10k; R_0805_2012Metric_Pad1.20x1.40mm_HandSolder
TP32, TP33, TP34, TP43, TP48: TP_POP; TestPoint_Loop_D1.80mm_Drill1.0mm_Beaded
U12: UCC27284-Q1; SOIC-8_3.9x4.9mm_P1.27mm

Connections:
/DC/DC CONVERTER/VG_LP: D11.2 (A), R69.2, TP34.1; also elsewhere on the board
/DC/DC CONVERTER/VG_LS: D10.2 (A), R68.2, TP32.1; also elsewhere on the board
/DRIVER COMMAND/Driver_LP: U12.6 (LI); also elsewhere on the board
/DRIVER COMMAND/Driver_LS: U12.5 (HI); also elsewhere on the board
/MOS DRIVER L/HB: C24.1, C25.1, D19.1 (K), R97.2, TP48.1, U12.2 (HB); also elsewhere on the board
/MOS DRIVER L/VS: C24.2, C25.2, D8.2 (A), D19.2 (A), TP33.1, U12.4 (HS); also elsewhere on the board
/MOS DRIVER R/HB: JP19.2 (B); also elsewhere on the board
/MOS DRIVER R/VS: C52.1; also elsewhere on the board
unnamed: C52.2, D20.2 (A), D21.1 (K), JP19.1 (A), TP43.1
unnamed: D8.1 (K), R66.2, R68.1, U12.3 (HO)
unnamed: D9.1 (K), R67.2, R69.1, U12.8 (LO)
unnamed: D10.1 (K), R66.1
unnamed: D11.1 (K), R67.1
unnamed: D20.1 (K), R97.1
VCC: C23.1, C50.1, D21.2 (A), U12.1 (VDD); also elsewhere on the board

Parts of its further copies:
C33, C34: 100n; C_0805_2012Metric_Pad1.18x1.45mm_HandSolder
C35, C53: 1u; C_0805_2012Metric_Pad1.18x1.45mm_HandSolder
C51: 1uF; C_0805_2012Metric_Pad1.18x1.45mm_HandSolder
D15, D16, D17, D18, D23, D24: SS36; D_SMA_Handsoldering
D22: MMSZ5245; D_SOD-123
JP20: Jumper_2_Open; SolderJumper-2_P1.3mm_Open_TrianglePad1.0x1.5mm
R85, R86: 1; R_0805_2012Metric_Pad1.20x1.40mm_HandSolder
R87, R88: 5; R_0805_2012Metric_Pad1.20x1.40mm_HandSolder
R98: 10k; R_0805_2012Metric_Pad1.20x1.40mm_HandSolder
TP44, TP45, TP46, TP47, TP49: TP_POP; TestPoint_Loop_D1.80mm_Drill1.0mm_Beaded
U17: UCC27284-Q1; SOIC-8_3.9x4.9mm_P1.27mm

Connections of its further copies:
/DC/DC CONVERTER/VG_RP: D17.2 (A), R87.2, TP45.1; also elsewhere on the board
/DRIVER COMMAND/Driver_RS: U17.5 (HI); also elsewhere on the board
/MOS DRIVER L/HB: JP20.2 (B); also elsewhere on the board
/MOS DRIVER L/VS: C53.1; also elsewhere on the board
/MOS DRIVER R/Driver_P: U17.6 (LI); also elsewhere on the board
/MOS DRIVER R/HB: C34.1, C35.1, D22.1 (K), R98.2, TP49.1, U17.2 (HB); also elsewhere on the board
/MOS DRIVER R/VG_P: D18.2 (A), R88.2, TP47.1; also elsewhere on the board
/MOS DRIVER R/VS: C34.2, C35.2, D15.2 (A), D22.2 (A), TP46.1, U17.4 (HS); also elsewhere on the board
unnamed: C53.2, D23.2 (A), D24.1 (K), JP20.1 (A), TP44.1
unnamed: D15.1 (K), R85.2, R87.1, U17.3 (HO)
unnamed: D16.1 (K), R86.2, R88.1, U17.8 (LO)
unnamed: D17.1 (K), R85.1
unnamed: D18.1 (K), R86.1
unnamed: D23.1 (K), R98.1
VCC: C33.1, C51.1, D24.2 (A), U17.1 (VDD); also elsewhere on the board

Notes on the sheet:
Découplage
ajouter power pad
Charge pump circuit
Charge and discharge resistors
