Antho32170/ETD2/KICAD/sesame-fonctionnel.kicad_pcb

## KiCad design KICAD/sesame-fonctionnel.kicad_pcb (continued)

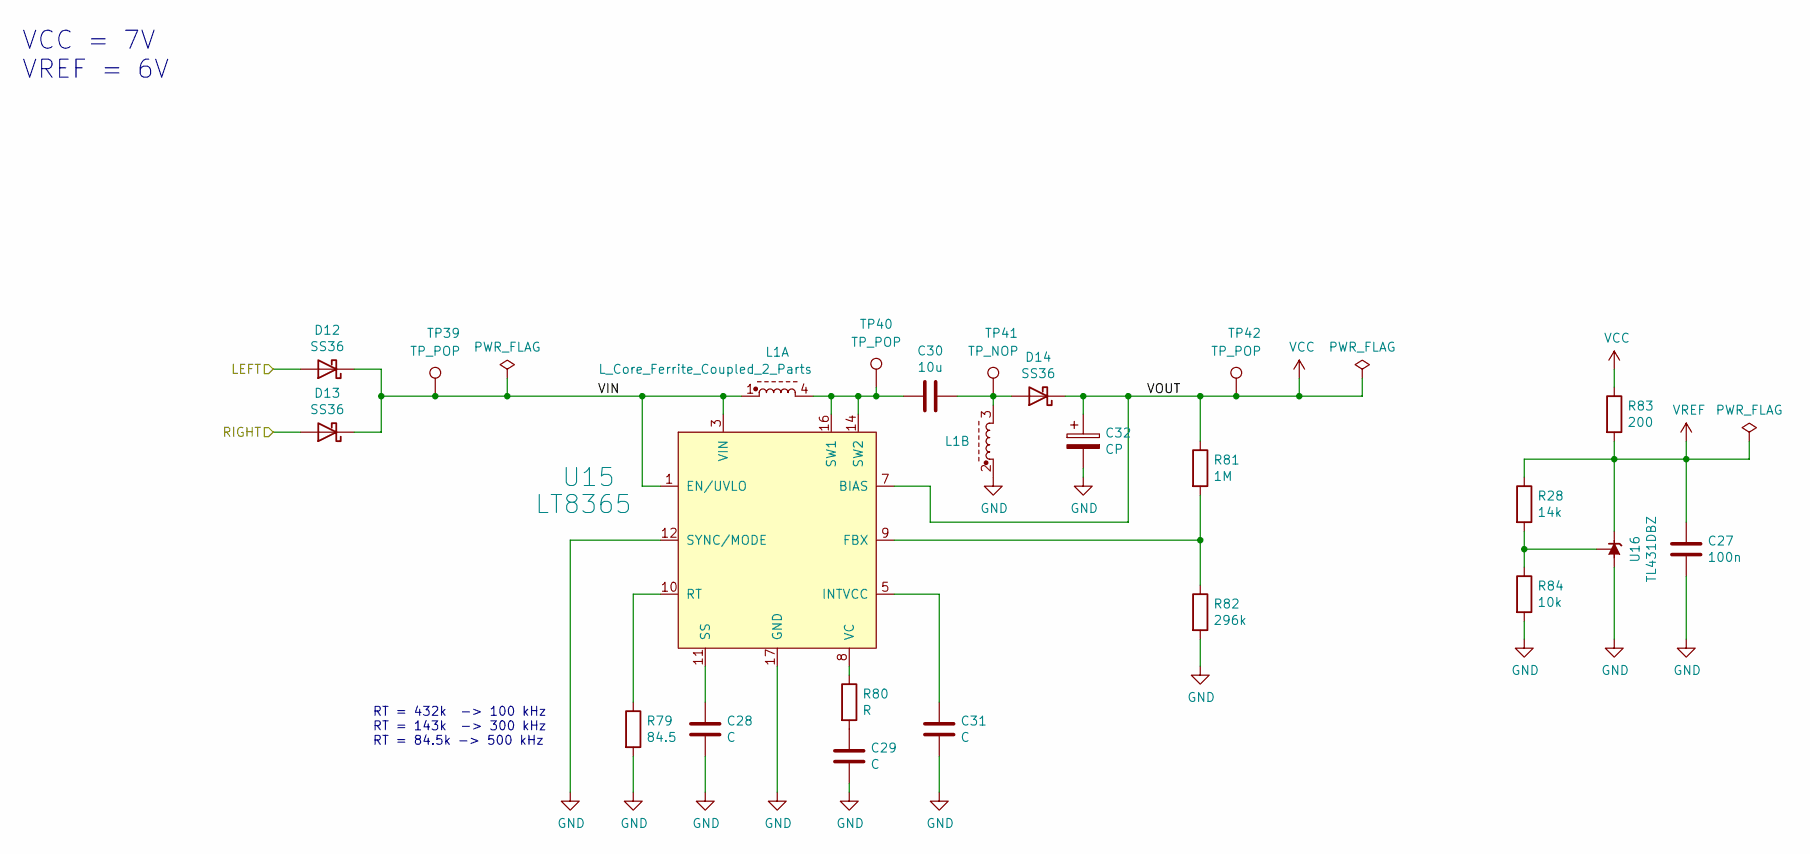
[picture p53: schematic alims.sch, SESAME]

Parts:
C27: 100n; C_0805_2012Metric_Pad1.18x1.45mm_HandSolder
C28, C29, C31: C; C_0805_2012Metric_Pad1.18x1.45mm_HandSolder
C30: 10u; C_1206_3216Metric_Pad1.42x1.75mm_HandSolder
C32: CP; C_Elec_4x5.8
D12, D13, D14: SS36; D_SMA_Handsoldering
L1: L_Core_Ferrite_Coupled_2_Parts; WE-DD_1260_128012
R28: 14k; R_0805_2012Metric_Pad1.20x1.40mm_HandSolder
R79: 84.5; R_0805_2012Metric_Pad1.20x1.40mm_HandSolder
R80: R; R_0805_2012Metric_Pad1.20x1.40mm_HandSolder
R81: 1M; R_0805_2012Metric_Pad1.20x1.40mm_HandSolder
R82: 296k; R_0805_2012Metric_Pad1.20x1.40mm_HandSolder
R83: 200; R_0805_2012Metric_Pad1.20x1.40mm_HandSolder
R84: 10k; R_0805_2012Metric_Pad1.20x1.40mm_HandSolder
TP39, TP40, TP42: TP_POP; TestPoint_Loop_D1.80mm_Drill1.0mm_Beaded
TP41: TP_NOP; TestPoint_THTPad_D2.0mm_Drill1.0mm
U15: LT8365; MSE-16-1EP_3x4mm_P0.5mm_EP1.65x2.85mm_ThermalVias
U16: TL431DBZ; SOT-23

Connections:
/INTERNAL SUPPLIES/VIN: D12.1 (K), D13.1 (K), L1.1 (2), TP39.1, U15.1 (EN/UVLO), U15.3 (VIN)
unnamed: C28.1, U15.11 (SS)
unnamed: C29.1, R80.2
unnamed: C30.1, D14.2 (A), L1.3, TP41.1
unnamed: C30.2, L1.4 (3), TP40.1, U15.14 (SW2), U15.16 (SW1)
unnamed: C31.1, U15.5 (INTVCC)
unnamed: R28.2, R84.1, U16.2 (REF)
unnamed: R79.1, U15.10 (RT)
unnamed: R80.1, U15.8 (VC)
unnamed: R81.2, R82.1, U15.9 (FBX)
VCC: C32.1, D14.1 (K), R81.1, R83.1, TP42.1, U15.7 (BIAS); also elsewhere on the board
VREF: C27.1, R28.1, R83.2, U16.1 (K); also elsewhere on the board

Notes on the sheet:
RT = 432k -> 100 kHz RT = 143k -> 300 kHz RT = 84.5k -> 500 kHz
VCC = 7V VREF = 6V

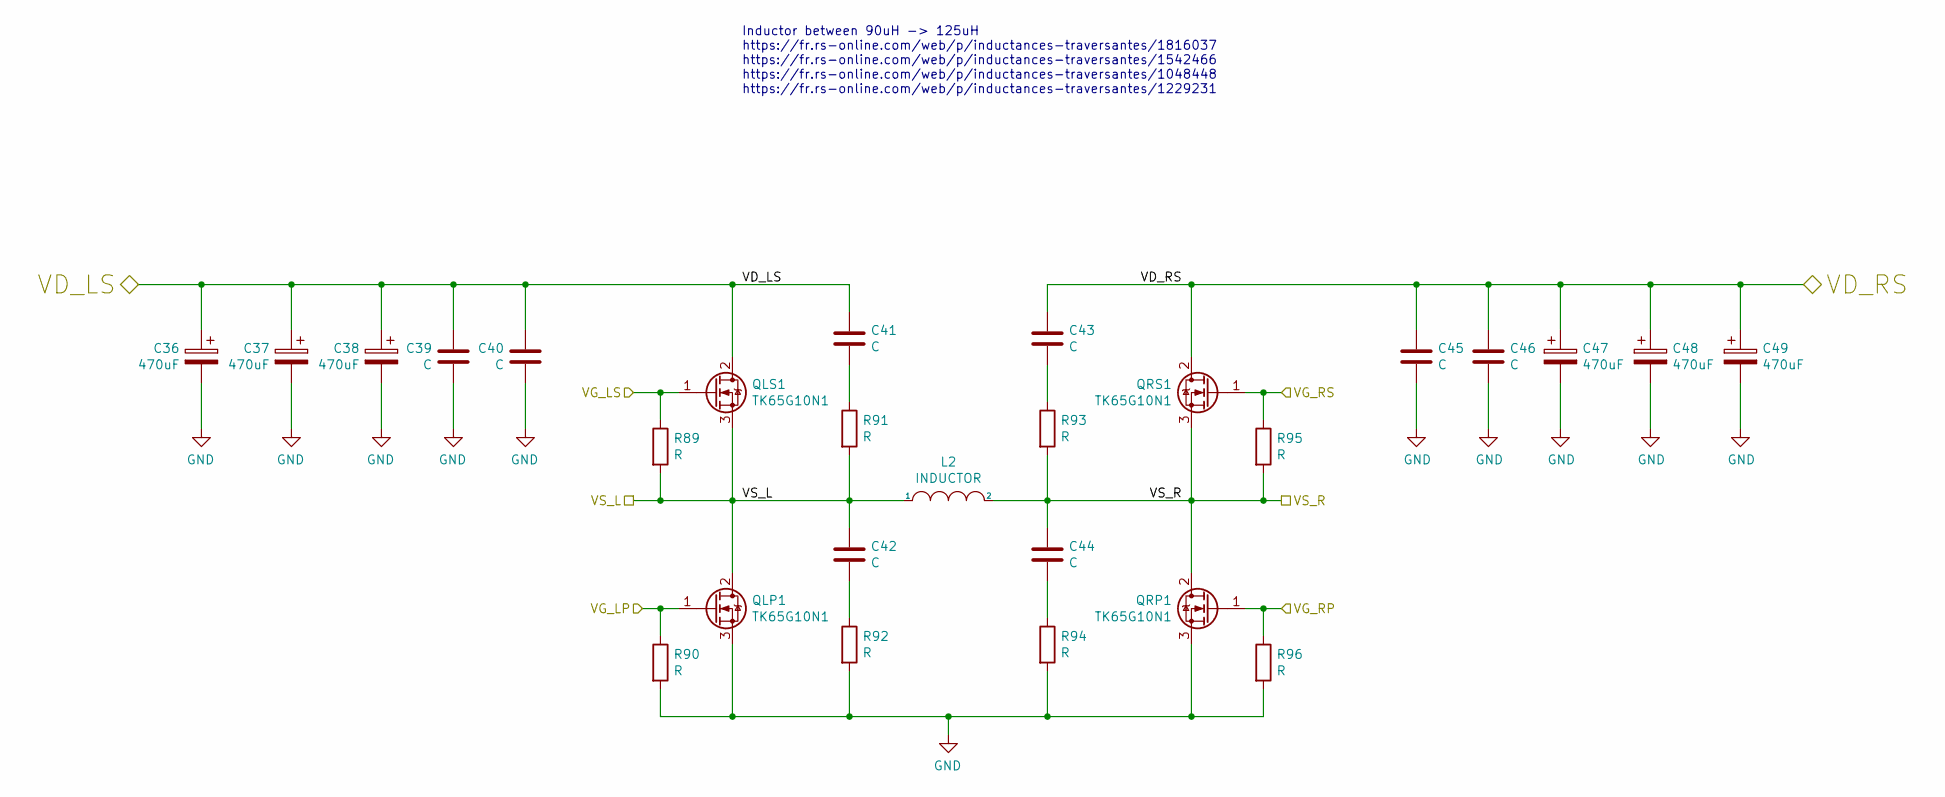
[picture p54: schematic DC_DC_Converter.sch, SESAME]

Parts:
C36, C37, C38, C47, C48, C49: 470uF; CP_Radial_D12.5mm_P5.00mm
C39, C40, C41, C42, C43, C44, C45, C46: C; C_0805_2012Metric_Pad1.18x1.45mm_HandSolder
L2: INDUCTOR; Multi-coil
QLP1: TK65G10N1; TO-263-2
QLS1: TK65G10N1; TO-263-2
QRP1: TK65G10N1; TO-263-2
QRS1: TK65G10N1; TO-263-2
R89, R90, R91, R92, R93, R94, R95, R96: R; R_0805_2012Metric_Pad1.20x1.40mm_HandSolder

Connections:
/DC/DC CONVERTER/VD_LS: C36.1, C37.1, C38.1, C39.1, C40.1, C41.1, QLS1.2 (D); also elsewhere on the board
/DC/DC CONVERTER/VG_LP: QLP1.1 (G), R90.1; also elsewhere on the board
/DC/DC CONVERTER/VG_LS: QLS1.1 (G), R89.1; also elsewhere on the board
/DC/DC CONVERTER/VG_RP: QRP1.1 (G), R96.1; also elsewhere on the board
/MOS DRIVER L/VS: C42.1, L2.1, QLP1.2 (D), QLS1.3 (S), R89.2, R91.2; also elsewhere on the board
/MOS DRIVER R/VG_P: QRS1.1 (G), R95.1; also elsewhere on the board
/MOS DRIVER R/VS: C44.1, L2.2, QRP1.2 (D), QRS1.3 (S), R93.2, R95.2; also elsewhere on the board
/U/I SENSOR RIGHT/VD_Mos: C43.1, C45.1, C46.1, C47.1, C48.1, C49.1, QRS1.2 (D); also elsewhere on the board
unnamed: C41.2, R91.1
unnamed: C42.2, R92.1
unnamed: C43.2, R93.1
unnamed: C44.2, R94.1

Notes on the sheet:
Inductor between 90uH -> 125uH https://fr.rs-online.com/web/p/inductances-traversantes/1816037 https://fr.rs-online.com/web/p/inductances-traversantes/1542466 https://fr.rs-online.com/web/p/inductances-traversantes/1048448 https://fr.rs-online.com/web/p/inductances-traversantes/1229231

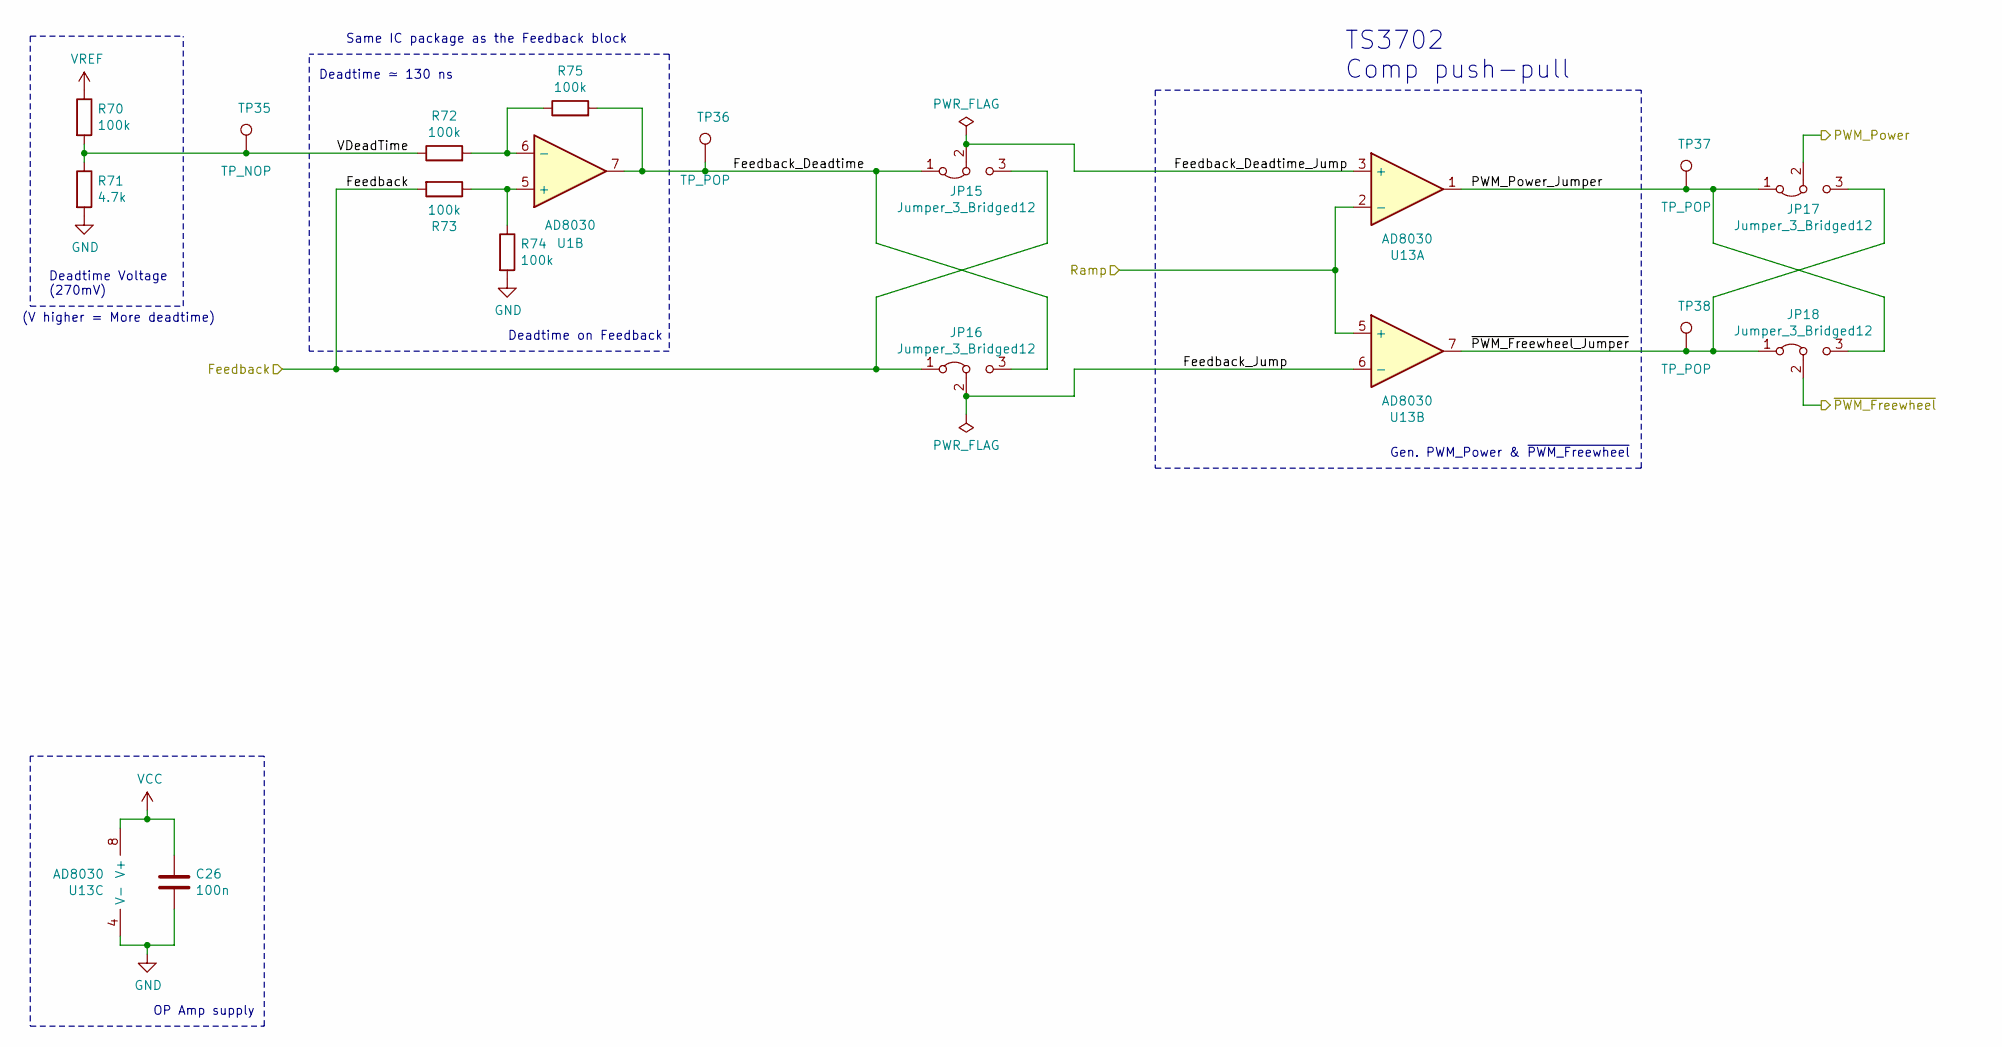
[picture p55: schematic PWM_Gen.sch, SESAME]

Parts:
C26: 100n; C_0805_2012Metric_Pad1.18x1.45mm_HandSolder
JP15, JP16, JP17, JP18: Jumper_3_Bridged12; SolderJumper-3_P1.3mm_Bridged12_Pad1.0x1.5mm
R70, R72, R73, R74, R75: 100k; R_0805_2012Metric_Pad1.20x1.40mm_HandSolder
R71: 4.7k; R_0805_2012Metric_Pad1.20x1.40mm_HandSolder
TP35: TP_NOP; TestPoint_THTPad_D2.0mm_Drill1.0mm
TP36, TP37, TP38: TP_POP; TestPoint_Loop_D1.80mm_Drill1.0mm_Beaded
U1, U13: AD8030; SO-8_5.3x6.2mm_P1.27mm

Connections:
/INT_PWM_Power: JP17.2 (C); also elsewhere on the board
/PID/Feedback: JP15.3 (B), JP16.1 (A), R73.2; also elsewhere on the board
/PWM GEN/Feedback_Deadtime: JP15.1 (A), JP16.3 (B), R75.2, TP36.1, U1.7
/PWM GEN/Feedback_Deadtime_Jump: JP15.2 (C), U13.3 (+)
/PWM GEN/Feedback_Jump: JP16.2 (C), U13.6 (-)
/PWM GEN/PWM_Power_Jumper: JP17.1 (A), JP18.3 (B), TP37.1, U13.1
/PWM GEN/Ramp: U13.2 (-), U13.5 (+); also elsewhere on the board
/PWM GEN/VDeadTime: R70.2, R71.1, R72.1, TP35.1
/PWM GEN/~PWM_Freewheel_Jumper: JP17.3 (B), JP18.1 (A), TP38.1, U13.7
/~INT_PWM_Freewheel: JP18.2 (C); also elsewhere on the board
unnamed: R72.2, R75.1, U1.6 (-)
unnamed: R73.1, R74.1, U1.5 (+)
VCC: C26.1, U13.8 (V+); also elsewhere on the board
VREF: R70.1; also elsewhere on the board

Notes on the sheet:
Deadtime on Feedback
Deadtime Voltage (270mV)
(V higher = More deadtime)
Gen. PWM_Power & ~PWM_Freewheel
Same IC package as the Feedback block
OP Amp supply
Deadtime ≃ 130 ns
TS3702 Comp push-pull

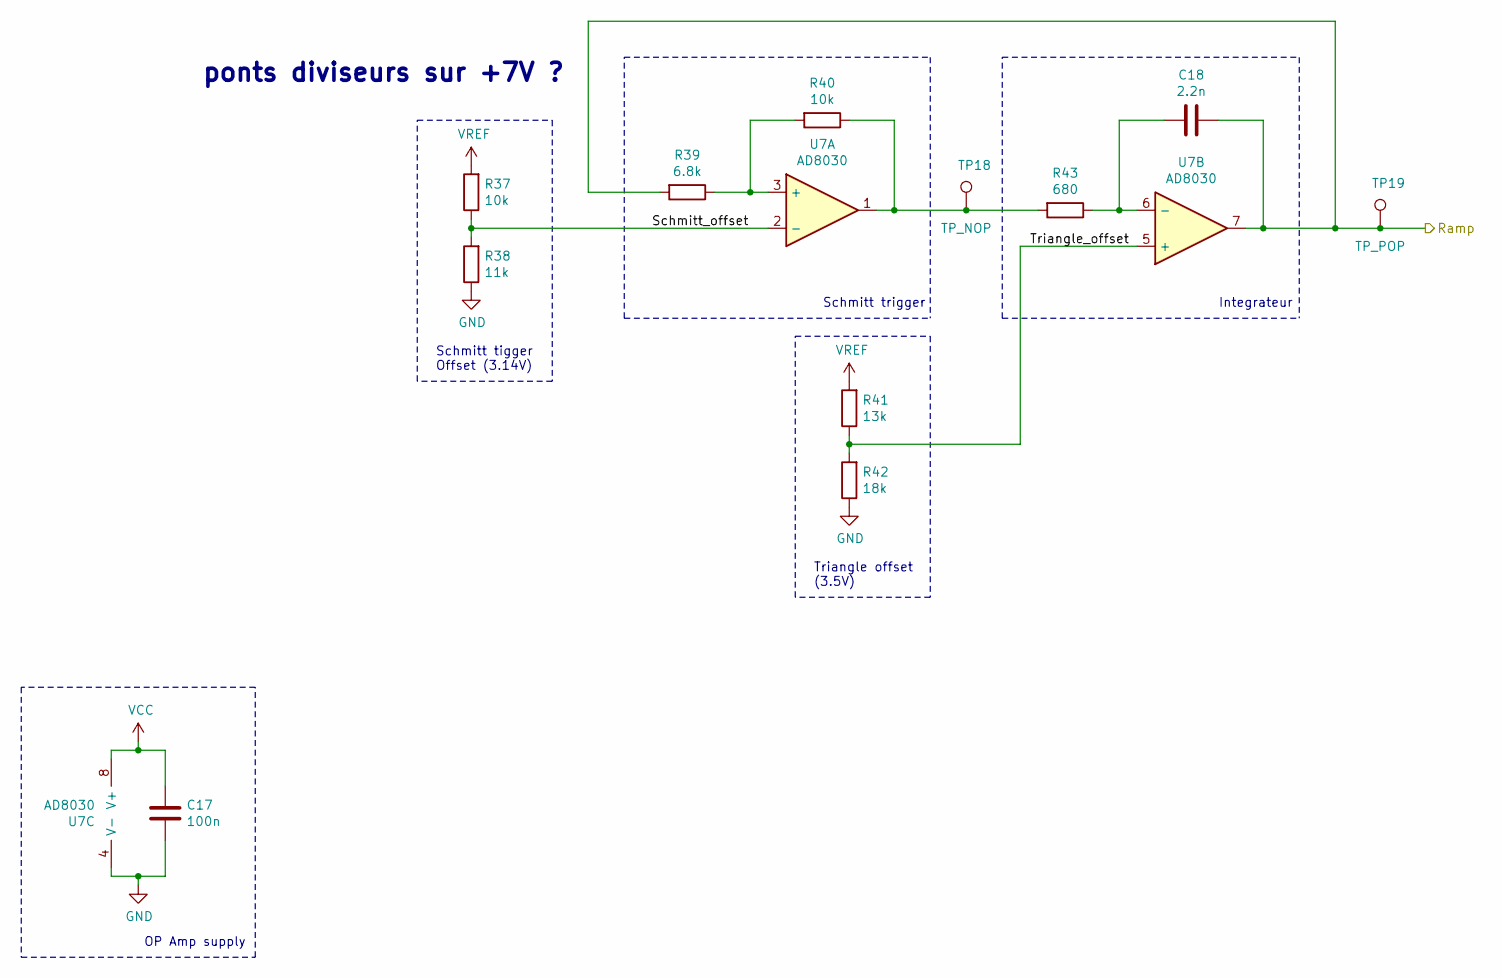
[picture p56: schematic gen_ramp.sch, SESAME]

Parts:
C17: 100n; C_0805_2012Metric_Pad1.18x1.45mm_HandSolder
C18: 2.2n; C_0805_2012Metric_Pad1.18x1.45mm_HandSolder
R37, R40: 10k; R_0805_2012Metric_Pad1.20x1.40mm_HandSolder
R38: 11k; R_0805_2012Metric_Pad1.20x1.40mm_HandSolder
R39: 6.8k; R_0805_2012Metric_Pad1.20x1.40mm_HandSolder
R41: 13k; R_0805_2012Metric_Pad1.20x1.40mm_HandSolder
R42: 18k; R_0805_2012Metric_Pad1.20x1.40mm_HandSolder
R43: 680; R_0805_2012Metric_Pad1.20x1.40mm_HandSolder
TP18: TP_NOP; TestPoint_THTPad_D2.0mm_Drill1.0mm
TP19: TP_POP; TestPoint_Loop_D1.80mm_Drill1.0mm_Beaded
U7: AD8030; SO-8_5.3x6.2mm_P1.27mm

Connections:
/PWM GEN/Ramp: C18.1, R39.2, TP19.1, U7.7; also elsewhere on the board
/RAMP GENERATOR/Schmitt_offset: R37.1, R38.2, U7.2 (-)
/RAMP GENERATOR/Triangle_offset: R41.1, R42.2, U7.5 (+)
unnamed: C18.2, R43.1, U7.6 (-)
unnamed: R39.1, R40.2, U7.3 (+)
unnamed: R40.1, R43.2, TP18.1, U7.1
VCC: C17.1, U7.8 (V+); also elsewhere on the board
VREF: R37.2, R41.2; also elsewhere on the board

Notes on the sheet:
Integrateur
Schmitt trigger
Triangle offset (3.5V)
OP Amp supply
Schmitt tigger Offset (3.14V)
ponts diviseurs sur +7V ?

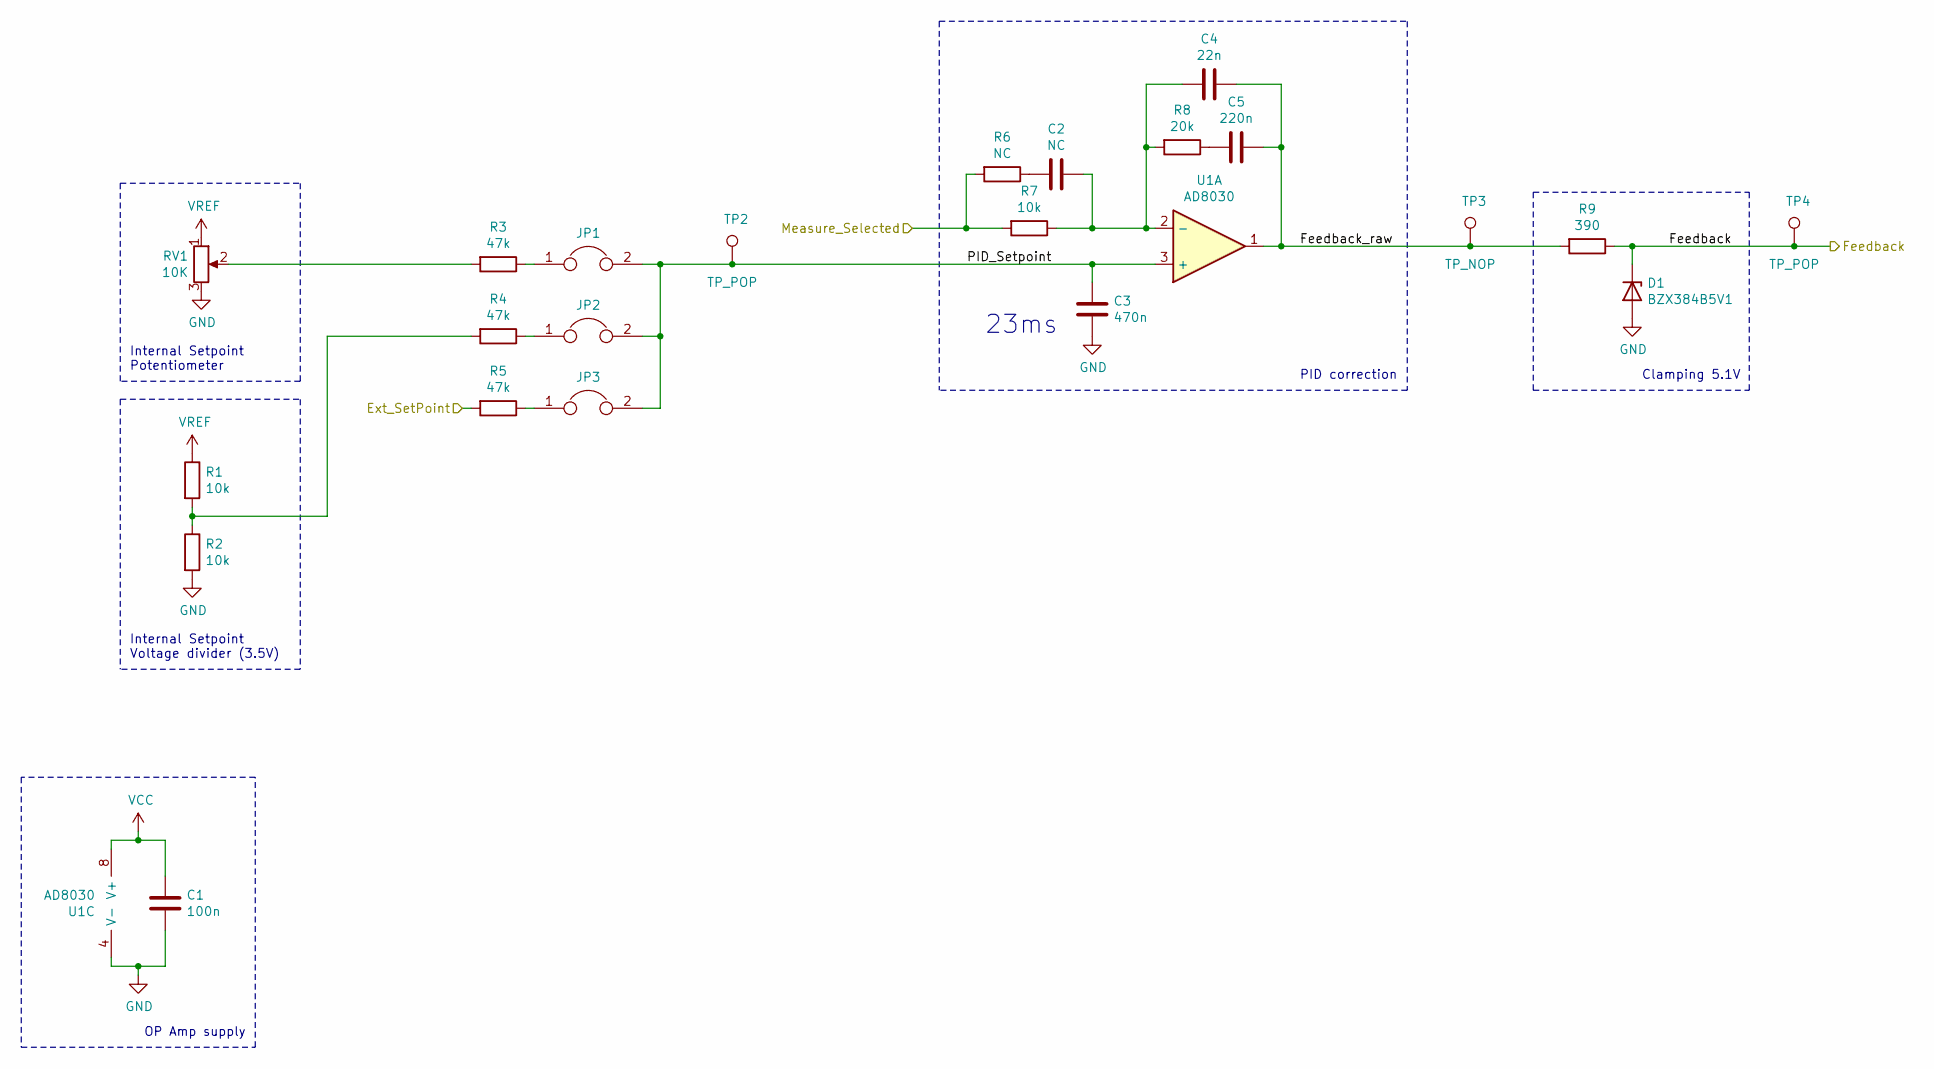
[picture p57: schematic PID.sch, SESAME]

Parts:
C1: 100n; C_0805_2012Metric_Pad1.18x1.45mm_HandSolder
C2: NC; C_0805_2012Metric_Pad1.18x1.45mm_HandSolder
C3: 470n; C_0805_2012Metric_Pad1.18x1.45mm_HandSolder
C4: 22n; C_0805_2012Metric_Pad1.18x1.45mm_HandSolder
C5: 220n; C_0805_2012Metric_Pad1.18x1.45mm_HandSolder
D1: BZX384B5V1; D_SOD-323_HandSoldering
JP1, JP2, JP3: Jumper; PinHeader_1x02_P2.54mm_Vertical
R1, R2, R7: 10k; R_0805_2012Metric_Pad1.20x1.40mm_HandSolder
R3, R4, R5: 47k; R_0805_2012Metric_Pad1.20x1.40mm_HandSolder
R6: NC; R_0805_2012Metric_Pad1.20x1.40mm_HandSolder
R8: 20k; R_0805_2012Metric_Pad1.20x1.40mm_HandSolder
R9: 390; R_0805_2012Metric_Pad1.20x1.40mm_HandSolder
RV1: 10K; Potentiometer_Bourns_3214W_Vertical
TP2, TP4: TP_POP; TestPoint_Loop_D1.80mm_Drill1.0mm_Beaded
TP3: TP_NOP; TestPoint_THTPad_D2.0mm_Drill1.0mm
U1: AD8030; SO-8_5.3x6.2mm_P1.27mm

Connections:
/Ext_Setpoint: R5.2; also elsewhere on the board
/MEASURE SELECTOR/Measure_Selected: R6.2, R7.2; also elsewhere on the board
/PID/Feedback: D1.1 (K), R9.1, TP4.1; also elsewhere on the board
/PID/Feedback_raw: C4.1, C5.1, R9.2, TP3.1, U1.1
/PID/PID_Setpoint: C3.1, JP1.2, JP2.2, JP3.2, TP2.1, U1.3 (+)
unnamed: C2.1, C4.2, R7.1, R8.2, U1.2 (-)
unnamed: C2.2, R6.1
unnamed: C5.2, R8.1
unnamed: JP1.1, R3.1
unnamed: JP2.1, R4.1
unnamed: JP3.1, R5.1
unnamed: R1.2, R2.1, R4.2
unnamed: R3.2, RV1.2
VCC: C1.1, U1.8 (V+); also elsewhere on the board
VREF: R1.1, RV1.1; also elsewhere on the board

Notes on the sheet:
PID correction
Clamping 5.1V
OP Amp supply
Internal Setpoint Potentiometer
Internal Setpoint Voltage divider (3.5V)
23ms

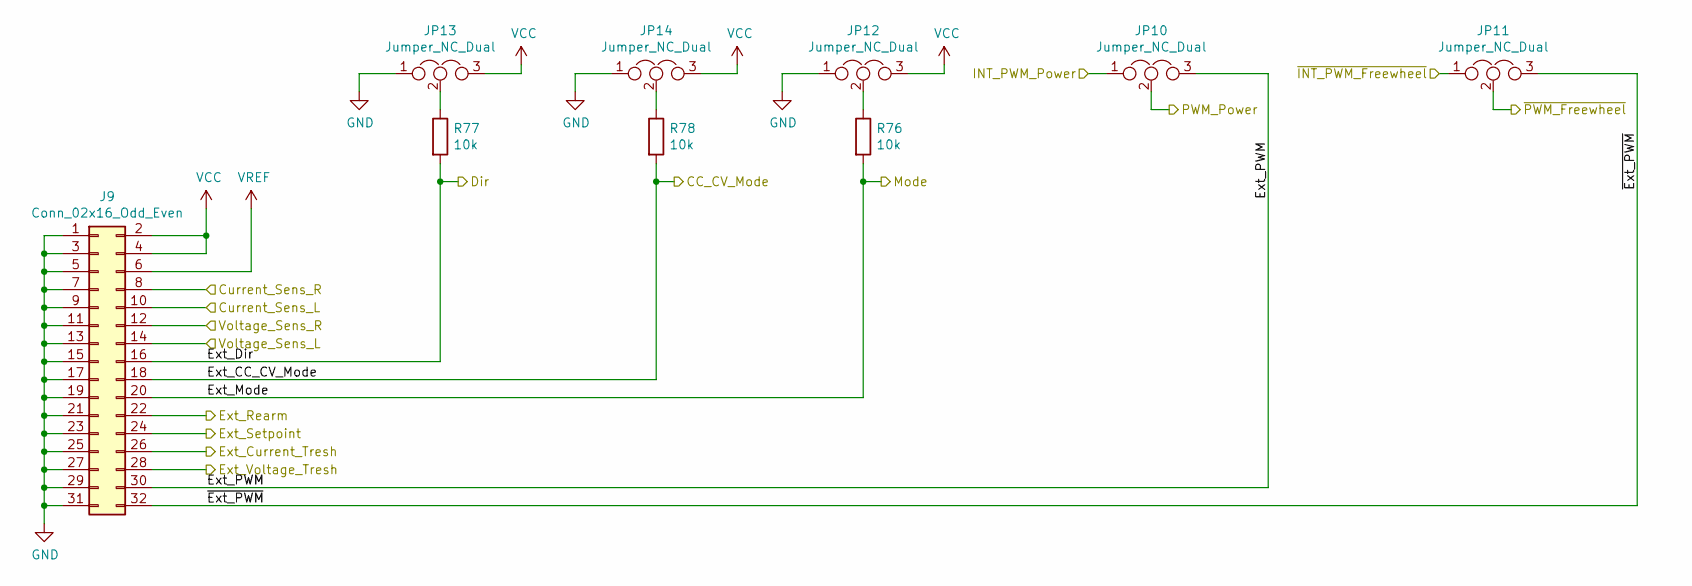
[picture p58: schematic Int_Ext_Config.sch, SESAME]

Parts:
J9: Conn_02x16_Odd_Even; PinSocket_2x16_P2.54mm_Vertical
JP10, JP11, JP12, JP13, JP14: Jumper_NC_Dual; PinHeader_1x03_P2.54mm_Vertical
R76, R77, R78: 10k; R_0805_2012Metric_Pad1.20x1.40mm_HandSolder

Connections:
/CC_CV_Mode: J9.18, R78.2; also elsewhere on the board
/Current_Sens_L: J9.10; also elsewhere on the board
/Current_Sens_R: J9.8; also elsewhere on the board
/Current_Thres: J9.26; also elsewhere on the board
/Dir: J9.16, R77.2; also elsewhere on the board
/Ext_Setpoint: J9.24; also elsewhere on the board
/INT EXT CONFIG/Ext_PWM: J9.30, JP10.3
/INT EXT CONFIG/~Ext_PWM: J9.32, JP11.3
/INT_PWM_Power: JP10.1; also elsewhere on the board
/Mode: J9.20, R76.2; also elsewhere on the board
/PWM_Power: JP10.2; also elsewhere on the board
/Rearm: J9.22; also elsewhere on the board
/Voltage_Sens_L: J9.14; also elsewhere on the board
/Voltage_Sens_R: J9.12; also elsewhere on the board
/Voltage_Thres: J9.28; also elsewhere on the board
/~INT_PWM_Freewheel: JP11.1; also elsewhere on the board
/~PWM_Freewheel: JP11.2; also elsewhere on the board
unnamed: JP12.2, R76.1
unnamed: JP13.2, R77.1
unnamed: JP14.2, R78.1
VCC: J9.2, J9.4, JP12.3, JP13.3, JP14.3; also elsewhere on the board
VREF: J9.6; also elsewhere on the board

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
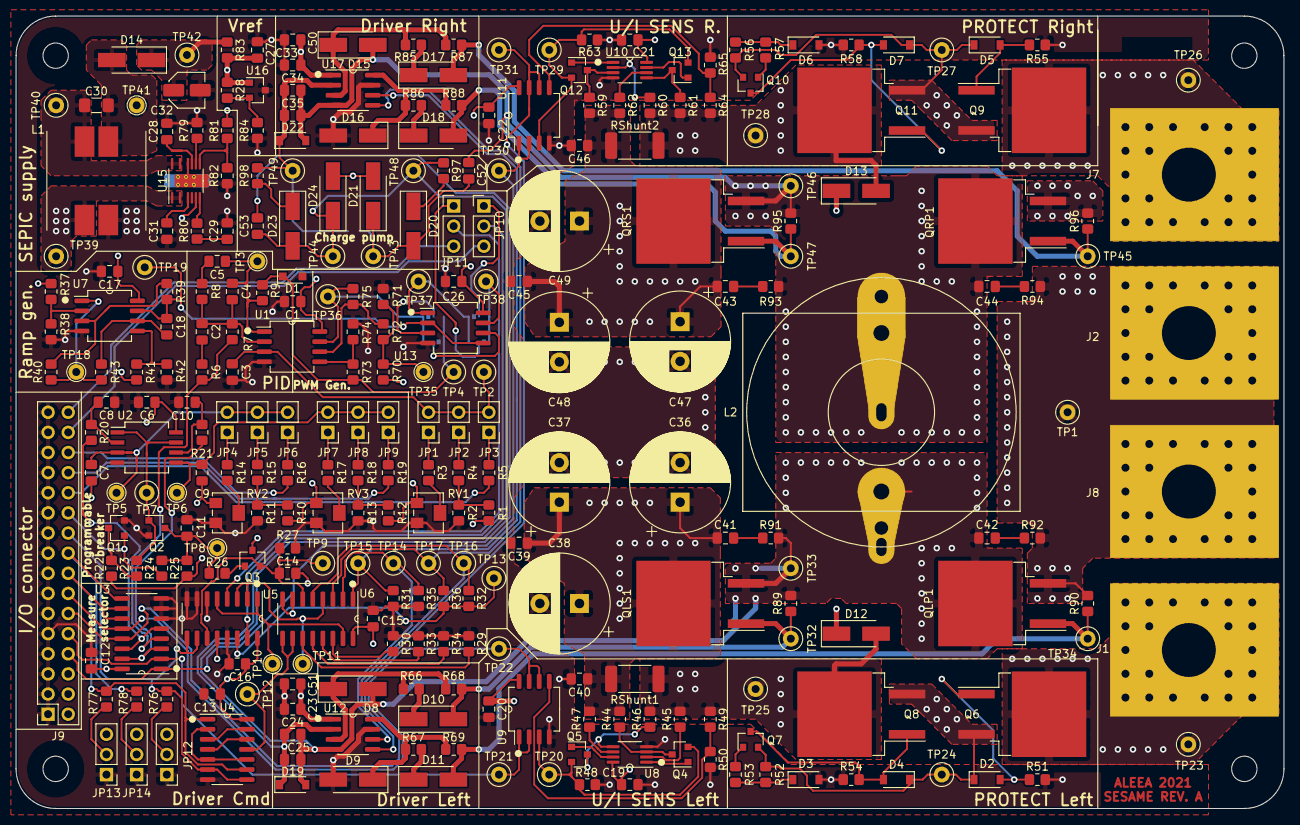
[picture p59: board sesame-fonctionnel.kicad_pcb from above]

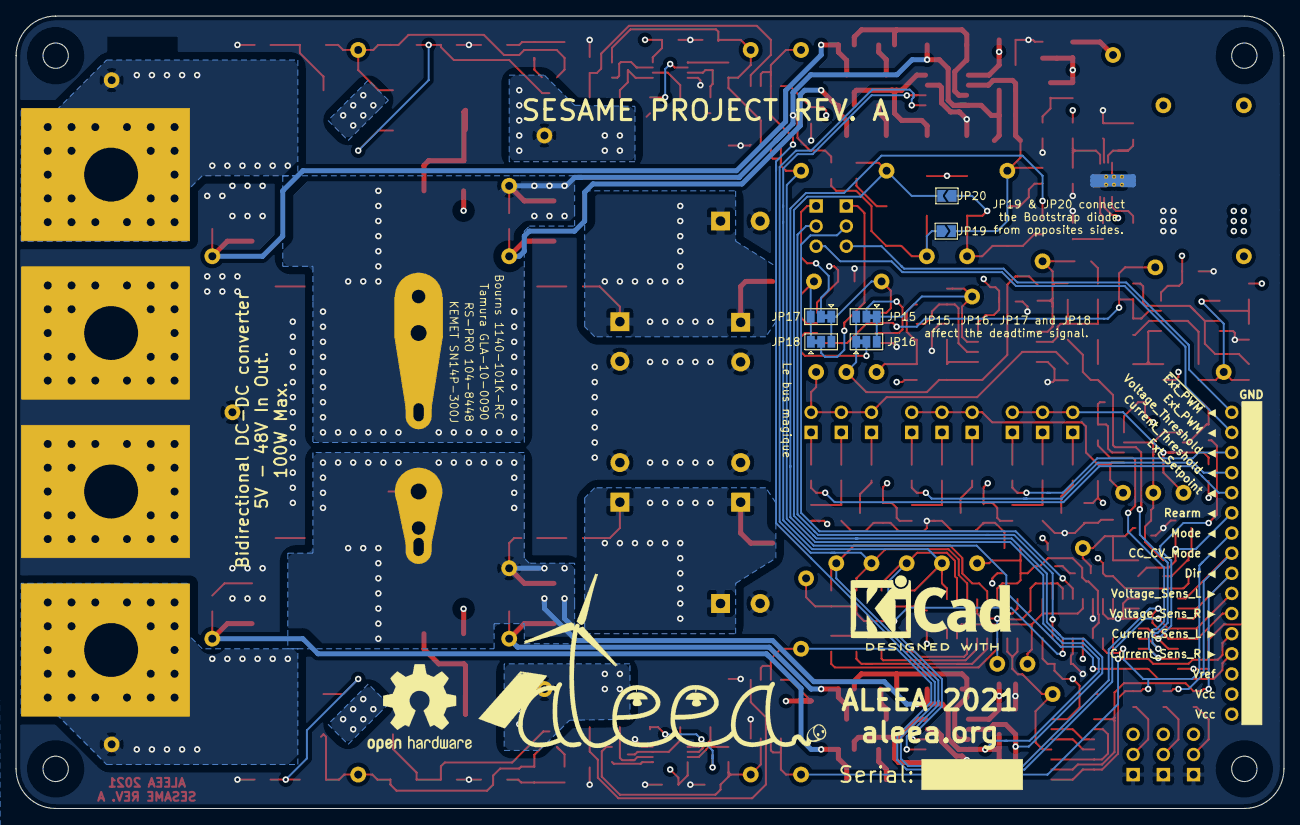
[picture p60: board sesame-fonctionnel.kicad_pcb from below]

Board: 4 copper layers, 160.0 x 100.0 mm, 293 parts (6 on the bottom side), 151 nets.
