Antho32170/ETD2/KICAD/dual_LT6105/dual_LT6105.kicad_pcb

## KiCad design KICAD/dual_LT6105/dual_LT6105.kicad_pcb (2021-11-26)

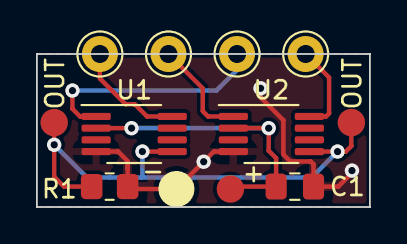
[picture p61: board dual_LT6105.kicad_pcb from above]

Board: 2 copper layers, 18.5 x 8.5 mm, 12 parts (0 on the bottom side), 7 nets.

Parts:
+: Conn_01x01; conn_pad
-: Conn_01x01; conn_pad
C1: 100n; C_0805_2012Metric_Pad1.18x1.45mm_HandSolder
J3, J4, J5, J6: Conn_01x01; Pin_D1.0mm_L10.0mm
OUT: Conn_01x01; conn_pad
OUT#2: Conn_01x01; conn_pad
R1: 20k; R_0805_2012Metric_Pad1.20x1.40mm_HandSolder
U1, U2: LT6105; MSOP-8_3x3mm_P0.65mm

Connections:
GND: -.1, C1.2, R1.2, U1.4 (V-), U2.4 (V-)
unnamed: J3.1, U1.8 (+)
unnamed: J4.1, U1.1 (-)
unnamed: J5.1, U2.8 (+)
unnamed: J6.1, U2.1 (-)
unnamed: OUT.1, OUT#2.1, R1.1, U1.5, U2.5
VCC: +.1, C1.1, U1.2 (V+), U2.2 (V+)
