Antho32170/ETD2/(commit log)

2021-08-02 Feuilles hierachiques terminees
    [DC_DC_Converter.sch, Driver_Command.sch, Driver_Modes.sch, Drivers_Command.sch, Int_Ext_Config.sch, Measure_Selector.sch, Mos_Drivers.sch, PID.sch]
2021-08-03 removed legacy symbols
    [DC_DC_Converter.sch, Drivers_Command.sch, Int_Ext_Config.sch, Measure_Selector.sch, Mos_Drivers.sch, PID.sch, PWM_Gen.sch, programmable_breaker.sch]
2021-08-03 labels dans les blocks
    [DC_DC_Converter.sch, Drivers_Command.sch, Measure_Selector.sch, Mos_Drivers.sch, PID.sch, PROTECT.sch, PWM_Gen.sch, gen_ramp.sch]
2021-08-03 add 4053
    [Measure_Selector.sch]
2021-08-03 modif cartouche
    [sesame-fonctionnel.sch]
2021-08-03 fix rescue symbol
    [Measure_Selector.sch]
2021-08-03 finished measure selector
    [Drivers_Command.sch, Measure_Selector.sch]
2021-08-05 Nearly finished Driver cmd
    [Drivers_Command.sch, Int_Ext_Config.sch, alims.sch, voltage_current_sens.sch]
2021-08-05 update header + redraw Driver CMD
    [DC_DC_Converter.sch, Drivers_Command.sch, Int_Ext_Config.sch, Measure_Selector.sch, Mos_Drivers.sch, PID.sch, PROTECT.sch, PWM_Gen.sch]
2021-08-06 changed grid for Measure selector
    [Measure_Selector.sch]
2021-08-06 added ina240 sim + drawed protect and DC-DC chopper
    [DC_DC_Converter.sch, Measure_Selector.sch, PROTECT.sch, voltage_current_sens.sch]
2021-08-07 added ramp draed by jebin + mod the current sim and it's working
    !
    [Measure_Selector.sch, gen_ramp.sch]
2021-08-08 mod the main sheet + drawed the first full version of the u/i sensor
    [sesame-fonctionnel.sch, voltage_current_sens.sch]
2021-08-15 minors edits + 7v rail
    [DC_DC_Converter.sch, Drivers_Command.sch, Measure_Selector.sch, Mos_Drivers.sch, PROTECT.sch, gen_ramp.sch, programmable_breaker.sch, sesame-fonctionnel.sch]
2021-08-15 ebauche driver mos
    [DC_DC_Converter.sch, Mos_Drivers.sch, alims.sch, sesame-fonctionnel.sch, voltage_current_sens.sch]
2021-08-15 added draft pwm gen & pid
    [Mos_Drivers.sch, PID.sch, PWM_Gen.sch, gen_ramp.sch, programmable_breaker.sch, sesame-fonctionnel.sch, voltage_current_sens.sch]
2021-08-17 a ton of new stuff. V0.8
    [DC_DC_Converter.sch, Drivers_Command.sch, Int_Ext_Config.sch, Measure_Selector.sch, Mos_Drivers.sch, PID.sch, PROTECT.sch, PWM_Gen.sch]
2021-08-19 alim sepic sim + diff mos sim
    [voltage_current_sens.sch]
2021-08-20 simu meseure de courant sans sommateur
2021-08-20 current measure new style sim
2021-08-21 PID + PWM + RAMP finished
    [Drivers_Command.sch, PID.sch, PWM_Gen.sch, gen_ramp.sch, sesame-fonctionnel.sch]
2021-08-21 reworked driver command
    [DC_DC_Converter.sch, Drivers_Command.sch, Measure_Selector.sch, Mos_Drivers.sch, PROTECT.sch]
2021-08-22 worked on power supply + connectors
    [Drivers_Command.sch, alims.sch, programmable_breaker.sch, sesame-fonctionnel.kicad_pcb, sesame-fonctionnel.sch, voltage_current_sens.sch]
2021-08-22 added footprint lib + steps for connectors
    [CXS70-14-C.STEP, keystone-PN6095.STEP, sesame-fonctionnel.kicad_pcb, sesame-fonctionnel.sch, voltage_current_sens.sch]
2021-08-22 moved things arround in the main sheet
    [sesame-fonctionnel.sch]
2021-08-22 lt6015 it is
    [alims.sch, sesame-fonctionnel.sch, voltage_current_sens.sch]
2021-08-23 mainly footprints
    [DC_DC_Converter.sch, Drivers_Command.sch, Measure_Selector.sch, PID.sch, PROTECT.sch, PWM_Gen.sch, alims.sch, gen_ramp.sch]
2021-08-23 revex with jmt
    [DC_DC_Converter.sch, Drivers_Command.sch, Int_Ext_Config.sch, Measure_Selector.sch, Mos_Drivers.sch, PID.sch, PROTECT.sch, PWM_Gen.sch]
2021-08-23 minor cleanup
    [Drivers_Command.sch, Int_Ext_Config.sch, Measure_Selector.sch, Mos_Drivers.sch, alims.sch, infos.sch, programmable_breaker.sch, sesame-fonctionnel.sch]
2021-08-23 Stef merge
    [DC_DC_Converter.sch, PROTECT.sch, programmable_breaker.sch, voltage_current_sens.sch]
2021-08-23 drivers draft + clean and minors changes
    [Drivers_Command.sch, Int_Ext_Config.sch, Measure_Selector.sch, Mos_Drivers.sch, PID.sch, PROTECT.sch, PWM_Gen.sch, alims.sch]
2021-08-24 driver + clean clean clean
    [DC_DC_Converter.sch, Drivers_Command.sch, Int_Ext_Config.sch, Measure_Selector.sch, Mos_Drivers.sch, PID.sch, PROTECT.sch, PWM_Gen.sch]
2021-08-24 review w/ jmt
    [DC_DC_Converter.sch, Drivers_Command.sch, Int_Ext_Config.sch, Measure_Selector.sch, Mos_Drivers.sch, PID.sch, PROTECT.sch, PWM_Gen.sch]
2021-08-24 edit footprints by jmt
    [DC_DC_Converter.sch, Drivers_Command.sch, Int_Ext_Config.sch, Measure_Selector.sch, Mos_Drivers.sch, PID.sch, PROTECT.sch, PWM_Gen.sch]
2021-08-25 route + work on djd
    [DC_DC_Converter.sch, Int_Ext_Config.sch, Mos_Drivers.sch, PID.sch, PROTECT.sch, PWM_Gen.sch, infos.sch, programmable_breaker.sch]
2021-08-25 added footprint for sepic coil + no more errors in netlist
    [744873001_Download_STP_WE-DD-1280_rev1.stp, DC_DC_Converter.sch, Drivers_Command.sch, Int_Ext_Config.sch, Measure_Selector.sch, Mos_Drivers.sch, PID.sch, PROTECT.sch]
2021-08-25 added footprint sepic + place place place
    [alims.sch, sesame-fonctionnel.kicad_pcb]
2021-08-26 end of placement 7 beginning of routing
    [3214W.stp, Mos_Drivers.sch, sesame-fonctionnel.kicad_pcb]
2021-08-27 changed monting holes + tweaks & still routing
    [PROTECT.sch, SOIC-16.STEP, sesame-fonctionnel.kicad_pcb, sesame-fonctionnel.sch, voltage_current_sens.sch]
2021-08-27 protect left finished
    [sesame-fonctionnel.kicad_pcb]
2021-08-27 changed transistor placement in protect
    [sesame-fonctionnel.kicad_pcb]
2021-08-27 little cleanup. 278 conn. to go
    [sesame-fonctionnel.kicad_pcb]
2021-08-27 clean up eco user 2 layer
    [sesame-fonctionnel.kicad_pcb]
2021-08-27 protect right. 249 conn.
    [sesame-fonctionnel.kicad_pcb]
2021-08-28 200 conn. remaining
    [Drivers_Command.sch, Measure_Selector.sch, Mos_Drivers.sch, PROTECT.sch, sesame-fonctionnel.kicad_pcb, voltage_current_sens.sch]
2021-08-28 ui sens right. 170 conn.
    [sesame-fonctionnel.kicad_pcb]
2021-08-28 right driver done. 149 conn.
    [sesame-fonctionnel.kicad_pcb]
2021-08-28 144 conn. will convert to 4 layers
    [sesame-fonctionnel.kicad_pcb]
2021-08-28 test w/ layers indicator
    [sesame-fonctionnel.kicad_pcb]
2021-08-28 layer indicator stuff
    [sesame-fonctionnel.kicad_pcb]
2021-08-29 95 conn. doing analog switchs
    [Int_Ext_Config.sch, Mos_Drivers.sch, sesame-fonctionnel.kicad_pcb, voltage_current_sens.sch]
2021-08-29 63 conn. dij placed
    [sesame-fonctionnel.kicad_pcb]
2021-08-29 30 conn. changed again the pinout of io connector
    [Int_Ext_Config.sch, sesame-fonctionnel.kicad_pcb]
2021-08-29 all done. 3 conn. left for vref
    [sesame-fonctionnel.kicad_pcb]
2021-08-29 ibom for testing
    [sesame-fonctionnel.kicad_pcb]
2021-08-30 changed ground planes
    [sesame-fonctionnel.kicad_pcb]
2021-08-30 enhanced copper planes
    [sesame-fonctionnel.kicad_pcb]
2021-08-30 sim vref + djd write
    [Mos_Drivers.sch, alims.sch, sesame-fonctionnel.kicad_pcb, voltage_current_sens.sch]
2021-08-30 0 conn. + new vref
    [alims.sch, sesame-fonctionnel.kicad_pcb, voltage_current_sens.sch]
2021-08-30 correction on the ext config
    [Int_Ext_Config.sch, alims.sch]
2021-08-30 mod. ref rail on kicad
    [Mos_Drivers.sch, PROTECT.sch, alims.sch, sesame-fonctionnel.kicad_pcb, sesame-fonctionnel.sch, voltage_current_sens.sch]
2021-08-31 minor changes on the bottom layer + minor silkscreen cleaning
    [sesame-fonctionnel.kicad_pcb]
2021-09-02 cleanup silkscreen
    [Mos_Drivers.sch, PROTECT.sch, sesame-fonctionnel.kicad_pcb, sesame-fonctionnel.sch, voltage_current_sens.sch]
2021-09-02 lil cleanup silk and gate tracks
    [sesame-fonctionnel.kicad_pcb]
2021-09-02 clean clean clean. still not finished '
    [sesame-fonctionnel.kicad_pcb]
2021-09-02 modified deadtime + added config pads on the bottom for charge pump config
    [Drivers_Command.sch, Mos_Drivers.sch, PID.sch, PWM_Gen.sch, sesame-fonctionnel.kicad_pcb, sesame-fonctionnel.sch]
2021-09-03 minor changes
    [sesame-fonctionnel.kicad_pcb]
2021-09-19 lil cleanup on the main schematic sheet
    [DC_DC_Converter.sch, Drivers_Command.sch, Int_Ext_Config.sch, Measure_Selector.sch, Mos_Drivers.sch, PID.sch, PROTECT.sch, PWM_Gen.sch]
2021-09-19 fixed a mistake w/ not connected net and net naming mistake
    [Drivers_Command.sch, Int_Ext_Config.sch, PWM_Gen.sch, sesame-fonctionnel.kicad_pcb, sesame-fonctionnel.sch]
2021-09-23 V1.0 of the schematic
    [DC_DC_Converter.sch, Drivers_Command.sch, Int_Ext_Config.sch, Measure_Selector.sch, Mos_Drivers.sch, PID.sch, PROTECT.sch, PWM_Gen.sch]
2021-09-24 fab files rev A
    [sesame-fonctionnel-B_Cu.gbr, sesame-fonctionnel-B_Mask.gbr, sesame-fonctionnel-B_SilkS.gbr, sesame-fonctionnel-Dwgs_User.gbr, sesame-fonctionnel-Edge_Cuts.gbr, sesame-fonctionnel-F_Cu.gbr, sesame-fonctionnel-F_Mask.gbr, sesame-fonctionnel-F_SilkS.gbr]
2021-10-01 drill plan
    [bom sesame 2021.xlsx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]
2021-10-01 project save
    [sesame-fonctionnel.kicad_pcb]
2021-11-09 \added dual lt1605
    [dual_LT6105-B_Cu.gbr, dual_LT6105-B_Mask.gbr, dual_LT6105-B_Silkscreen.gbr, dual_LT6105-Edge_Cuts.gbr, dual_LT6105-F_Cu.gbr, dual_LT6105-F_Mask.gbr, dual_LT6105-F_Silkscreen.gbr, dual_LT6105-NPTH.drl]
2021-11-26 added gitignore and docs need cleenup
    [Mos_Drivers.sch, PROTECT.sch, PWM_Gen.sch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]
2021-11-26 export the dual LT6105 board
    [dual_LT6105.step, dual_LT61051.FCStd]
2021-12-02 procedure de montage du dual lt6105
    [montage composants ordre.xlsx, sesame-fonctionnel.kicad_pcb]
2021-12-16 added datasheets + test bench first version
    [dual_LT6105.kicad_sch]
2021-12-25 working multilines tracer
